mtkimmins/LTSDM_hack/scripts/cartridge-flasher/README.md

#TODO
- make LTSDM-specific wiring diagram for a resistor divider, upload, link
- count the jumper wires, insert #
- upload all pictures
- verify formatting on github
- continuity testing resistors will not beep
- redo all pictures

# Official Documentation of the LTSDM Cartridge Flasher
*The aim of this documentation is to explain this build so simply that a kid could build it like Legos. To report ambiguity, please submit a question to [the github](https://github.com/mtkimmins/LTSDM_hack/discussions/new?category=q-a).*

## Foreword
This is certainly not the only way to set up a communication channel with a cartridge ([see John-K's repo](https://github.com/John-K/LittleTikesDreamProjector)). For my own sanity, I will document a validated setup guide to at least get to where I am now, and as a way to "save" my progress more consistently.

---

## Resources Used
### Software
- Linux Ubuntu LTS (as operating system)
- Arduino IDE (for arduino upload)
- VSCode (for scripts)

### Hardware
- A multimeter with continuity testing ability
- Arduino Uno 3 (ch340-based clone; idVendor=1a86, idProduct=7523) (x1)
- Arduino-PC USB cable (x1)
- [8-Pin Card Edge Connector Socket](https://www.amazon.ca/PATIKIL-Connector-Straight-Connection-Circuit/dp/B0BPP6SVRD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) (Thanks to [John-K](https://github.com/John-K) for finding this part in the wild) (x1)
- Breadboard/Protoboard (x1)
- 24G wires
- 2k ohm resistors (x3)
- 3k ohm resistors (x3)
- intact LTSDM cartridge (x1)

---

## Circuitry Wiring
### P25D80SH PCB
It is important to note that the P25D80SH chip is the black integrated circuit (IC) that sits on the topside of the green PCB inside the cartridge housing. The cartridge uses the PCB's golden fingers to conduct electrical information from the embedded chip (IC) and the projector. The golden fingers on the PCB found in the LTSDM cartridges *is not* a direct mapping to the P25D80SH pins (see [datasheet](https://github.com/mtkimmins/LTSDM_hack/blob/main/Images/Chips/P25D80SH.pdf) vs explanation below).

#### **PINOUT** for P25D80SH *PCB*
> [!NOTE]
> For the description below, the PCB orientation is with (1) the golden fingers pointing toward you, (2) the black IC chip facing up, and (3) this position is held when describing both the top-face and bottom-face.
> The [PCB is in this orientation](https://github.com/mtkimmins/LTSDM_hack/blob/main/Images/CartridgeDissassembly/orientation_of_pcb.JPG) when the cartridge casing is (1) pointing the PCB golden fingers toward you, and (2) the book's cover label is face-down.The PCB golden fingers are DIFFERENT than the [pinout of the chip](https://github.com/mtkimmins/LTSDM_hack/blob/main/Images/Chips/P25D80SH.pdf). See [John-K's repository](https://github.com/John-K/LittleTikesDreamProjector) for further clarification.

**PCB Golden Finger Pinout**
||LEFT|||RIGHT|
|:-:|:-:|:-:|:-:|:-:|
|TOP-FACE|MISO|CS*|SLCK*|MOSI*|
|BOTTOM-FACE|WP/HOLD/VCC|WP/HOLD/VCC|GND|GND|

*\*must reduce the voltage from 5V to 3.3V*

Despite there being two sets of two bottom-facing fingers with WP/HOLD/VCC and GND, **both P25D80SH GND fingers must be connected to the arduino GND.

### Resistor Dividers
> [!CAUTION]
> Running 5V (PC USB voltage) through the P25D80SH will **fry the chip** making it potentially unusable.

Resistor dividers are essential (but not the only option, see *level shifters*) for the protection and proper operation (dump/flash) of the P25D80SH chip. The following P25D80SH pins need to be connected to the arduino through resistor dividers: **MOSI**, **SLCK**, and **CS**.

**Diagram of a Resistor Divider in the Context of the LTSDM Project**
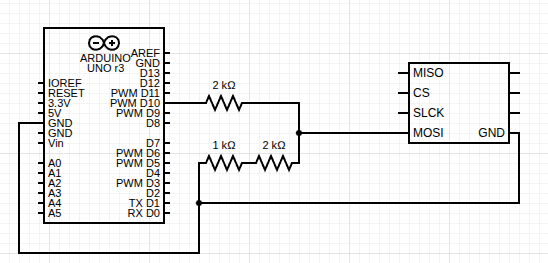
[picture p1: Images/WiringSetup/official-guide/1-resistor-divider-circuit-diagram.png]


Resistor dividers are partitioned into the "top resistor" and "bottom resistor." In the LTSDM project, we are reducing the voltage from the arduino pins (coming out at 5V; too high for the P25D80SH) to the operational ~3.3V.

Our top resistor (R1) = 2k ohms

Our bottom resistor (R2) = 3k ohms (direct chaining a 2k ohm resistor and a 1k ohm resistor together in series for the first breadboard prototype, then subbed them for a 3k resistor for the shield).

This resistor divider produces a current of about 3.0V, which is sufficient for the P25D80SH to operate.

### Arduino Pinout
For convention, one may use the following pins on the arduino:
- GND
- 3.3V
- PIN 10 through PIN 13 (this choice and assignment is largely arbitrary)
*the pinout is physically labeled on my arduino's PCB making the wiring much easier; Check your arduino's/microcontroller's datasheet if unsure of its pinout.*

> [!NOTE]
> Pins 10 through 13 output electricity at 5.0V, thus the need for resistor dividers despite there also being an actual *3.3V* pin. One cannot run all the P25D80SH pins through a single 3.3V arduino pin.

**Arduino-P25D0SH-Divider Mapping**
|P25D80SH pin|Arduino pin|Divider required?|
|:-:|:-:|:-:|
|CS|10|YES|
|SI|11|YES|
|SO|12|NO|
|SCLK|13|YES|
|GND|GND|NO|
|VCC/HOLD/WP|3.3V|NO|

---

## Hardware Setup Guide
**Full Circuit Diagram**
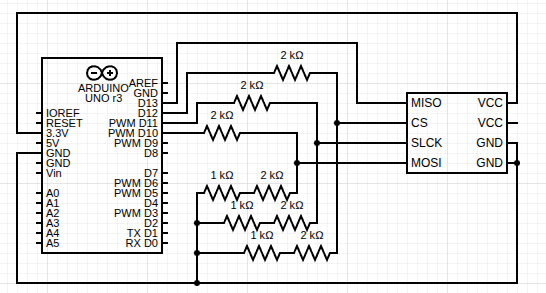
[picture p2: Images/WiringSetup/official-guide/full-circuit-diagram.png]


### Breadboard or Protoboard
Home circuity has been a messy endeavour, but using breadboards and then protoboards has connected the worlds of electronics and programming for me. Although I am quite awful with soldering, it has helped move this project along significantly even at my toddler-grade work. Consider soldering if connectivity is a bothersome issue. Alternatively, a solderless plastic breadboard is best to minimize health risk.

> [!WARNING]
> Have a responsible adult to supervise children operating soldering equipment. Soldering poses several health threats such as toxic fumes, physical contact with lead, and scalding-hot metal. Refer to a comprehensive soldering guide before attempting.

**Photo of One Plastic Breadboard (middle) and Two Protoboards**


### Adding the Cartridge Socket
**Photo of Socket and Header Pins**
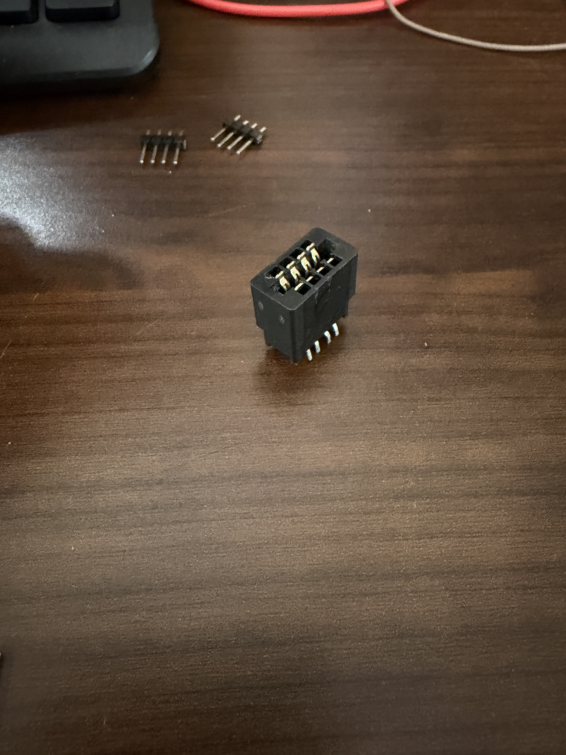
[picture p3: Images/WiringSetup/official-guide/socket-up.JPG]
Upright
  
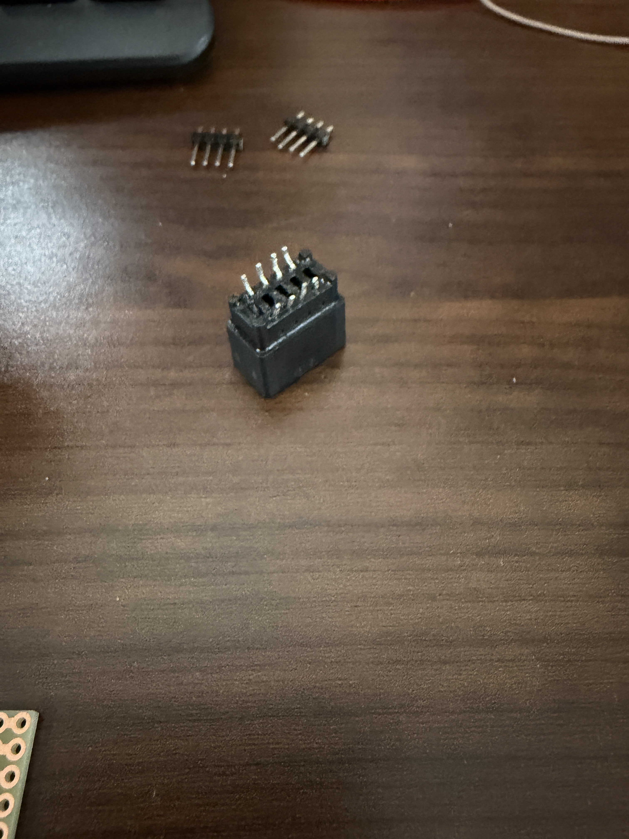
[picture p4: Images/WiringSetup/official-guide/socket-down.JPG]
Upside-down


Originally, I had thought that this part was a proprietary piece of electronics. For mine, I bought an entire other projector off Amazon, gutted it, and stole its socket. Months later, I read in John-K's documentation that one may buy these sockets off Amazon by the handful. Either approach works as evident by both our repositories. As noted by John-K, the width of this socket is not sufficient by default to interface with most breadboards and protoboards, thus the pins may be bent to accomodate the extra width required.

**Photo of 8-pin Socket in Breadboard**
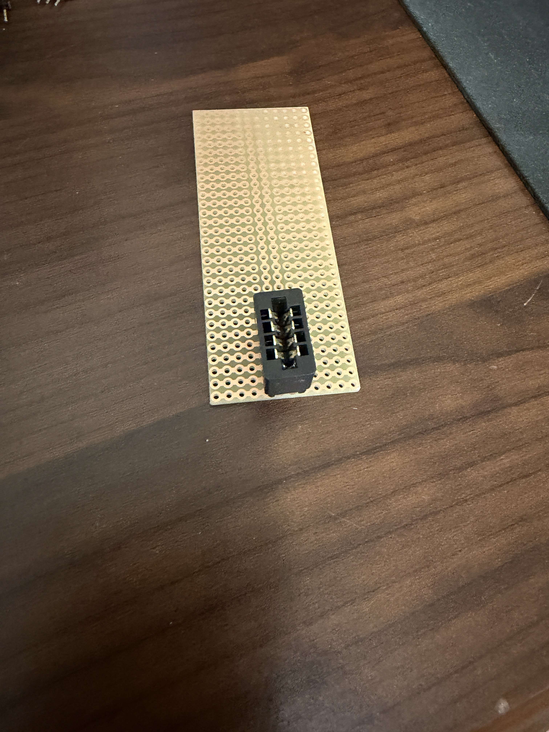
[picture p5: Images/WiringSetup/official-guide/placed-socket.JPG]


#### Checking Electrical Continuity
In order to ensure that the socket works and is securely connected to the breadboard/protoboard a multimeter should be used to perform a continuity test on each of the socket's pins. It is essential to test if the soldering joints are actually touching. This testing helps prevent later confounding between hardware malfunction and software debugging.

For breadboards one could use *header pins* to allow the multimeter leads to connect with the socket and the breadboard. Potentially, using two headers on either end of the breadboard's breakout rows can verify the validity of the *header pins* themselves. A disadvantage to plastic breadboards is the possibility of components shifting and slipping causing momentary or hidden circuit breaks.

For protoboards one could use the above-described "breadboard method," however, protoboards have the advantage over breadboards in that they can be soldered to hold components in place and increase the chance of a complete circuit connection. An additional advantage of a protoboard over a breadboard is that often the breakout rows are exposed versus on a conventional breadboard, thus allowing one to continuity test without *header pins*.

It is important to note that performing a continuity test through *resistors* will not trigger a signal. Resistors are meant to slow electricity, thus a continuity test will fail on a multimeter despite a circuit being physically complete. Using the Ohms setting on a multimeter can perform a continuity test through resistors if the meter reads the correct resistor value.

### Inserting the Cartridge, and Cartridge Orientation
One may notice that once the socket is placed on the board the LTSDM cartridge can be plugged in two conformations. Only 1 conformation will work -- they are not interchangeable as the P25D80SH pins will be flipped. This is where the builder must choose what orientation they would like their cartridge to fit into their socket. It is recommended to make a marking on the board and cartridge that align them properly.

**Photo of Cartridge in Socket**


### Resistor Dividers
As illustrated above, resistor dividers are used to reduce the voltage sent out of the arduino and into the P2D80SH chip. This protects the chip and allows it to function properly where it sends out signals classified in two states, "high" and "low."

**Photo of Resistor Dividers**


Ground (GND) will not need a divider as it receives any voltage of electricity sent through. Similarly, "master-in-slave-out" (MISO) will also conduct the output of the P25D80SH which will be within its tolerated 3.3V window by default. There also exists one 3.3V port on the arduino which can be used for the WP/HOLD/VCC. This leaves three P25D80SH pins: "master-out-slave-in (MOSI), "clock" (SCLK), and "chip select" (CS) to be reduced by resistor dividers. Three pins means three separate resistor dividers. One must connect each of those pins to a resistor divider *before* the arduino, thus positioning the resistor divider in the obligatory middle between the P25D80SH chip and the arduino.

To connect the P25D80SH chip pin to a resistor divider, one may use *jumper wires* to allow electricity to pass from the pin breakout row to the appropriate position in the resistor divider. The position of jumper wire connection *does* matter, so following the circuit diagram above as well as observing the reference photos may be of help.

The position of each resistor also matters which are designated as *top* and *bottom*. As the formula for a resistor divider is the following:
$$
V_{out}=(V_{in}*R_{bottom})/(R_{top}+R_{bottom})
$$
If $R_{top}$ > $R_{bottom}$, then the $V_{in}$ will be reduced more than 50%, and vice-versa.

**Photo of All Chip-Resistor Divider Connections**
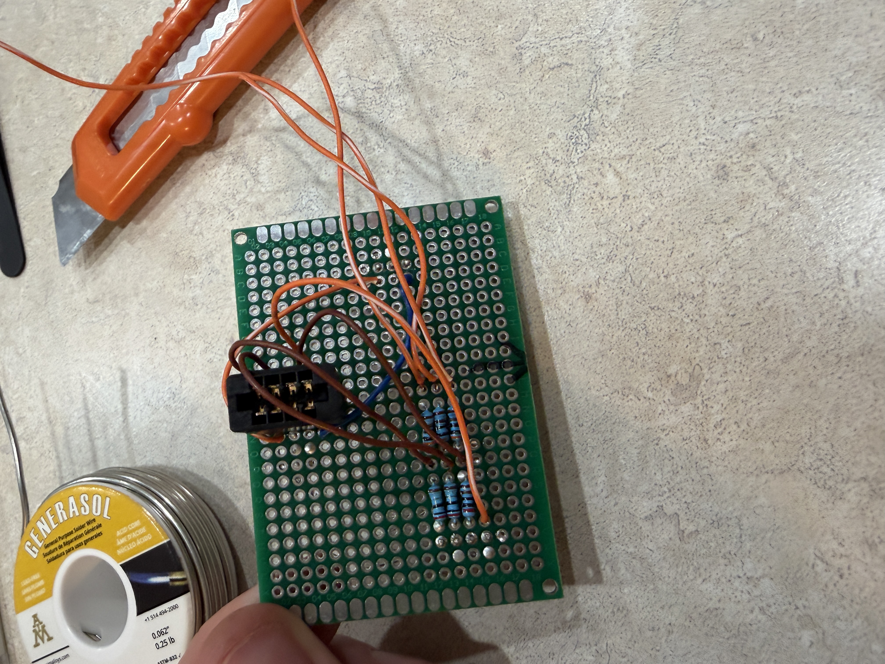
[picture p8: Images/shield/soldering/pre-solder-bridges-top.jpg]


### Complete Connection
**Photo of Physical Complete Connection Build**
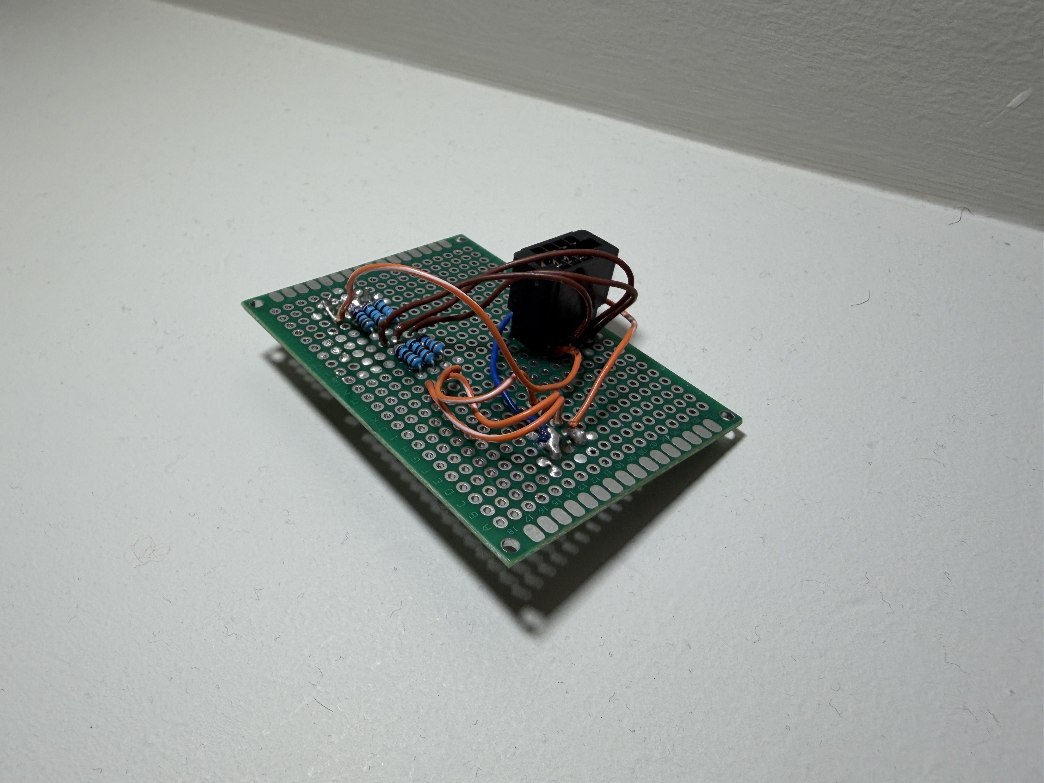
[picture p9: Images/shield/soldering/final3.jpg]


For a technical building overview, refer to the "Full Circuit Diagram" above.

### Arduino-PC Connection
In order to control the flow of electricity (and thus information) one must plug in the Arduino to a PC where one can compile and upload a script the arduino may execute to push and pull data from the cartridge. Plug in the microcontroller to the PC using the USB adapter that came with the microcontroller.

### Conclusion
Congratulations! The physical build is completed. The rest of the guide will reference the software used to interact with the P25D80SH chip.

**Photo of Overall Build**


---
## Flasher GUI
M0: Confirm SPI strategy (bitbang vs rewire) ──► M1
M1: PC↔Arduino serial handshake ──► M2
M2: Arduino low-level SPI primitives (CS assert, byte in/out) ──► M3
M3: JEDEC ID read (0x9F) — confirms chip talks & IDs correctly ──► M4, M6
M4: Bulk READ (0x03) — dump full 1MB to PC over serial ──► M5
M5: PC-app: save dump, verify length/checksum ──► M7
M6: Write-enable + status register polling (0x06, 0x05) ──► M6a
M6a: Erase primitives (0x20 sector / 0xD8 block / 0xC7 chip) ──► M6b
M6b: Page program (0x02) ──► M7
M7: Full round-trip test: dump → erase → flash → re-dump → diff ──► M8
M8: GUI polish (tkinter): progress bar, error states, retry logic

---
## Preparing the Custom Audio/Light Data Payload to Flash onto the P25D80SH chip
### Gathering Sources
### Converting Audio
### Defining Lights
### Compiling Payload
### Flashing Payload

---
## Milestones
TIER 2 — Link verification (your requirement #1 and #2)
 [3] Arduino ⟷ PC serial link verified   (PING/PONG handshake)
 [4] Arduino ⟷ chip electrical link verified (JEDEC ID read ≠ 0x00/0xFF)
      └─> [3] feeds: 5, 7, 9   |   [4] feeds: 5

TIER 3 — Read path
 [5] Single-block READ command working (addr, len) → hex payload over serial
      └─> feeds: 6

TIER 4 — Requirement #3: verified dump
 [6] Full-chip dump loop with double-read compare + retry/majority-vote on mismatch
      └─> feeds: 10

TIER 5 — Write path (each depends on the read path existing, for verify)
 [7] STATUS/WIP polling + WRITE ENABLE handling
 [8] ERASE (sector/chip) using [7]
 [9] PAGE PROGRAM (256B) using [7]
      └─> [8],[9] feed: 10 (need [5] too, for readback verify)

TIER 6 — Requirement #4: flash + verify
 [10] Erase→flash→read-back-verify orchestration for custom .bin

TIER 7 — Integration
 [11] GUI ties 3,4,6,10 into one workflow with logging + abort-safety
 [12] End-to-end test: dump stock cartridge → hash it → flash test pattern → dump again → diff
