mtkimmins/LTSDM_hack/docs/physical_specs.md

# Physical Specifications
This document will house the numerical values of dimensional measurements for the case, film, and PCB -- all components of the cartridge. All measurements were measured using a digital caliper with a **resolution** of 0.1mm/0.01" and an **accuracy** of $\pm$ 0.2mm/0.01".

## Case Components
### Carousel
* Diameter of big nubs = 2.2mm
* Diameter of small nubs = 1.9mm
* Height of all nubs (top of nub to back of disc) = 2.0mm
* Total diameter = 38.7mm
* Center gear diameter = 11.9mm
* Central hole in gear head depth = 1.4mm
* Film window width (ea) = 5.0mm
* Film window height (ea) = 6.0mm
* Inner central hole diameter = 3.2mm
* Center lip thickness = 0.9mm
* Carousel disc thickness (uniform) = 1.0mm
* Outer central hole diameter = 9.5mm
* Bottom of frame-bottom of frame diameter = 22.7mm
* Margin thickness between window outer top->edge = 1.4mm
* Depth of outer central hole = 2.3mm
* Depth of inner central hole = 3.0mm
* Depth of black window = 0.4mm
* Margin thickness between black window and bottom of film window = 0.6mm
* Height from back of disc (no nub) to top of gear teeth = 4.7mm
* Height from back of disc (no nub) to bottom groove of gear teeth = ~3.4mm
* Height of gear teeth (calculated) = 1.3mm
* Number of gear teeth = 12
* Number of film windows = 12
> [!Note]
> Carousel-film mounting becomes arbitrary in a modded cartridge due to its lack of interfacing with the projector making it functionally non-critical. As long as the film is fixed to the carousel in the right position, and turns with the carousel, the mounting method can be altered.
>
> An aspect of the official mounting method I would like to retain is the forced directionality the mounts impose on the film ensuring it is oriented and faced correctly. We also must ensure that the black window aligns with the first frame of the film too.
>
> Film windows are spaced evenly along the radius of the carousel.
>
> Gear teeth are centrally aligned with their nearest film window.
>
> The black marker that signals when to stop spinning the projector upon cartridge setup is directly opposite (180$^o$) from slide 1.
>
> The gear is on the rear surface of the carousel.
>
> The projected slide is the window to the center-left, at -90$^o$, or at 270$^o$ when looking at the backside (gear side).

### Front Case
* Pillar (PCB) diameter = 3.8mm
### Back Case

## Film Components
### Film Disc (Both Halves)
* Thickness (uniform across whole film) = 0.1mm
* Film diameter = 38mm
* Film slide width (average of 6) = 4.2mm
* Film slide height (average of 6) = 3.5mm
* Outer margin between outer slide edge and disc edge (average of 6) = 1.9mm
> [!Note]
> In official cartridges the film disc is cut in half and mounted separately onto the same carousel. It is unclear as the the purpose of the division, but it can be speculated that the mass production process favoured it.
>
> Film center hole edge borders on the outside of the carousel's central lip.
>
> Film background is all black except for the transparent arrows indicating rotation direction for each half.
>
> The film is projected upside down (vertically inverted) through the carousel window.
>
> Our custom film should have "FRONT" and "BACK" printed on it close to the centre of the whole disc. Alternatively, the print "THIS SIDE AWAY FROM CAROUSEL" may be ideal for layman orientation and repeatability.
> 
> When deciding how to print the custom film, a decision must be made whether it is best to print it so the ink is smushed against the carousel, or facing away from the carousel.
>
> Resolution of each slide is roughly 6:5.

## PCB Components
> [!Note]
> Dimensions are from the perspective of P25D80SH chip facing toward the viewer with the golden fingers pointed down.
* Top width = 14.5mm
* Top side height = 11.1mm
* Bottom width = 12.1mm
* Total PCB height = 19.9mm
* Rounded corners of Bottom = 7.0mm
* Small hole diameter = ~2.0mm
* Small hole-edge top margin = 2.2mm
* Small hole-edge left matgin = 1.6mm
* Large hole diameter = 4.0mm
* Large hole-edge top margin = 1.0mm
* Large hole-edge right margin = 1.8mm
> [!Note]
> All gold finger measurements can be assumed also from the socket's dimensions. However, these measurements are from direct caliper measurement.
* Edge connector pitch (center-to-center between neighbouring gold fingers; as per manufacturer ) = 2.54mm
* Gold finger width = 1.5mm
* Gold finger height = 7.4mm
* Gold finger margin between fingers = 0.4mm
* Gold finger-exge margin left = ~1.4mm
* Gold ginger-edge margin right = 1.6mm
* P25D80SH pin solder length = 2.5mm
* Copper well x from left edge to well center = 5.6mm
* Copper well y from too edge to well center = 1.5mm
* Copper well diameter = ~0.7mm
* PCB thickness (just board, no components) = 
1.4mm
* PCB thickness total (bottom to top surface of P25D80SH = 2.9mm
> [!Note]
> There is one capacitor adjacent to the P25D80SH chip on the PCB. Read value with multimeter with capacitance setting.
* Capacitor value = 20 uF
* Capacitor length = 2.2mm
* Capacitor width = 1.3mm
* Capacitor height = 0.7mm
