mtkimmins/LTSDM_hack/docs/a1800.md

# Turning Sound Data Back to Sound Using the A1800 Codec

## Illustrating the Problem
### The Task
Imagine you are an engineer at Little Tikes. You have an idea to make a movie projector for young children. The company says, "sure, but due to budget constraints, here are the parts you are allowed to work with: a P25D80SH SPI chip. This holds exactly 1 MiB of data, no more. You must take a book -- albeit abridged -- and fit the sound of someone reading it along with a light show and motor signals.
### The Challenge
this is how big an uncompressed audio file would be (too big)
### Possible Solutions
Cut uncompressed audio short
Compress it and release it with the main chip
### Data Compression
encoder decoder
audio compression uses a "codec"
### A1800 Codec
few examples of compression algorithms
### The Compressing Process
16:1 compression (illustrate)
### Anatomy of '.a18' file in LTSDM
header
payload
### Header
size
hz
### Payload
40-byte chunks
### Decompressing Process
Cartridge to sound
what a speaker needs
what we have (byte blocks)
### Byte Translation
necessity overlap between bytes
convert bytes -> bits = "bitstream"
### What are subbands?
### Loading the First Subband with a Gain
first 5 bytes = band 0 gain
chain of gains
### Huffman Coding Data Compression
differences
table hardcoded external
### Loading Gains for Remaining Subbands
chain of gains
### Bit Allocation
purpose
loudest frequencies get more attention
attention levels turn into specific procedures
types of representation 
why noise as opposed to silence
