mtkimmins/LTSDM_hack/docs/preliminary_data.md

The following is a culmination of data from physical examination and the analysis of recorded video (not posted) with video editing software (Microsoft Clipchamp).
___
# Big Shark, Little Shark
pcb label number (back): 11
#Frames = 12  
No figurine mount used  
|Audio Event|Timestamp Begun|Timestamp End|Duration (Seconds)|Description|
|:-:|:-:|:-:|:-:|:-:|
|Display first frame|0:00|

Number on back of cartridge: W34J071

# Big Shark, Little Shark, Baby Shark
PCB label number (back): 12
#Frames = 12  
No figurine mount used  
|Audio Event|Timestamp Begun |Timestamp End|Duration (Seconds)|Description|
|:-:|:-:|:-:|:-:|:-:|
|Display first frame|0:00|0:18|18||
|Vocal introduction|0:00|0:08|8|Announce title, narrator, authors|
|Vocal reading|0:08|0:18|10|Reading first frame|
|Light - blue|0:08|0:10|2|"big shark"|
|Light - cyan|0:10|0:12|2|"little shark"|
|Light - blue|0:12|0:13|1|"big shark"|
|Light - cyan|0:13|0:14|1|"little shark"|
|Light - yellow|0:14|0:18|4|"friends"|
|Light off, hide + change frame|0:18|0:21|3|
|Display second frame|0:21|0:25|4|
|Light - pink|0:21|0:23|2|"play"|
|Vocal reading|0:21|0:25|4|Reading second frame|
|Light - yellow|0:23|0:25|2|"fun"|
|Light off, hide + change frame|0:25|0:28|3|
|Display third frame|0:28|0:39|11|
|Light - Blue|0:28|0:30|2|"uh oh"|
|Vocal reading|0:29|0:39|1|Reading third frame|
|Light - pink|0:30|0:33|3|"baby shark"|
|Light - blue|0:33|0:34|1|"Big Shark"|
|Light - cyan|0:34|0:35|1|"Little shark"|
|Light - red|0:35|0:38|3|Sharks mad at baby shark approach|
|Light - pink|0:38|0:39|1|"baby shark"|
|Light off, hide + change frame|0:39|0:42|3|
|Display fourth frame|0:42|0:54|12|
|Light - pink|0:42|0:45|3|"baby shark"|
|Vocal reading|0:43|0:54|11|Reading fourth frame|
|Light - green|0:45|0:46|1|"too little"|
|Light - pink|0:46|0:48|2|"Baby shark"|
|Light - yellow|0:48|0:49|1|"too slow"|
|Light - red|0:49|0:54|5|disgust for baby shark|
|Light off, hide + change frame|0:54|0:57|3|
|Display fifth frame|0:57|1:07|10|
|Light - blue|0:57|0:59|2|"big shark"|
|Vocal reading|0:57|1:05|8|Reading fifth frame|
|Light - cyan|0:59|1:00|1|"Little shark"|
|Light - pink|1:00|1:05|5|"Swim away, sad"|
|Light - blue + baby crying sfx|1:05|1:07|2|blue light for duration of baby crying sfx|
|Light off, hide + change frame|1:07|1:10|3|
|Display sixth frame|1:10|1:19|9|
|Light - pink|1:10|1:11|1|"baby shark"|
|Vocal reading|1:11|1:18|7|Reading sixth frame|
|Light - cyan|1:11|1:14|3|Baby swim to parents|
|Light - red|1:14|1:18|4|Parents mad at other two sharks|
|Light - pink/blue/red/pink/red + gong|1:18|1:19|1|Gong sfx + light flashes quickly in order before shutting off|
|Light off, hide + change frame|1:19|1:22|3|
|Display seventh frame|1:22|1:29|7|
|Light - cyan|1:22|1:25|3|Tell grandpa shark|
|Vocal reading|1:22|1:27|5|Reading seventh frame|
|Light - red|1:25|1:27|2|"what [the other sharks] did"|
|Light - pink/blue/pink/red + gong sfx|1:28|1:28|0|gong paired with light flash in order, lingers on red|
|Light off, hide + change frame|1:29|1:31|2|
|Display eighth frame|1:31|1:39|8|
|Light - cyan|1:32|1:34|2|"grandpa shark"|
|Vocal reading|1:32|1:38|6|Reading eighth frame|
|Light - blue|1:34|1:36|2|"grandma shark"|
|Light - red|1:36|1:38|2|"what [the other sharks] did"|
|Light - yellow/red + gong|1:38|1:39|1|gong paired with a flash of yellow, then red|
|Light off, hide + change frame|1:39|1:43|4|
|Display ninth frame|1:42|1:48|6|
|Light - red|1:43|1:46|3|"family mad"|
|Vocal reading|1:43|1:48|5|Reading ninth frame|
|Light - purple|1:46|1:48|2|"sharks do?"|
|Light off, hide + change frame|1:48|1:50|2|
|Display tenth frame|1:50|2:05|15|
|Light - purple|1:51|1:53|2|"5 sharks"|
|Vocal reading|1:51|1:58|7|Reading tenth frame pt1|
|Light - blue|1:53|1:55|2|"Deep breaths"|
|Light - white|1:55|1:57|2|"Play"|
|Light - yellow|1:57|1:58|1|"own game"|
|Light - blue/yellow/blue/yellow + baseball organ sfx|1:58|2:00|2|light flashes blue, then yellow, then blue, then yellow along with baseball organ "Play ball!" sfx|
|Light stays yellow|2:00|2:02|2|continue from previous yellow light, "now"|
|Vocal reading|2:00|2:05|5|continuation of reading tenth frame|
|Light - blue|2:02|2:03|1|"big shark"|
|Light - cyan|2:03|2:05|2|"little shark"|
|Light off, hide + change frame|2:05|2:08|3|
|Display eleventh frame|2:08|2:17|9|
|Light - cyan|2:08|2:10|2|"say"|
|Vocal reading|2:08|2:16|8|Reading eleventh frame|
|Light - yellow|2:10|2:13|3|big shark and little shark apology|
|Light - purple/pink|2:13|2:14|1|"baby shark"|
|Light - yellow|2:14|2:16|2|baby asks other two to play|
|Light off, hide + change frame|2:16|2:19|3|
|Display twelfth frame|2:19|2:26|7|
|Light - blue|2:20|2:21|1|"all play"|
|Vocal reading|2:20|2:24|4|Reading twelfth frame|
|Light - cyan|2:21|2:23|2|"baseball"|
|Light - blue|2:23|2:24|1|"together"|
|Light - white/blue + baseball bat sfx|2:24|2:26|2|baseball bat hitting a ball sfx + changed to white for a while, then flashed blue before off|
|Light off, hide + change frame|2:26|2:29|3|
|Finished sound|2:29|

Number on backof cartridge: W34F171

# Big Shark, Little Shark Go to School
PCB label number (back): 13
#Frames = 12  
No figurine mount used  
|Audio Event|Timestamp Begun|Timestamp End|Duration (Seconds)|Description|
|:-:|:-:|:-:|:-:|:-:|
|Display first frame|0:00|

Number on back of cartridge: W34F171
