mtkimmins/LTSDM_hack/data/devlog/images/CartridgeDissassembly/internals_11.JPG

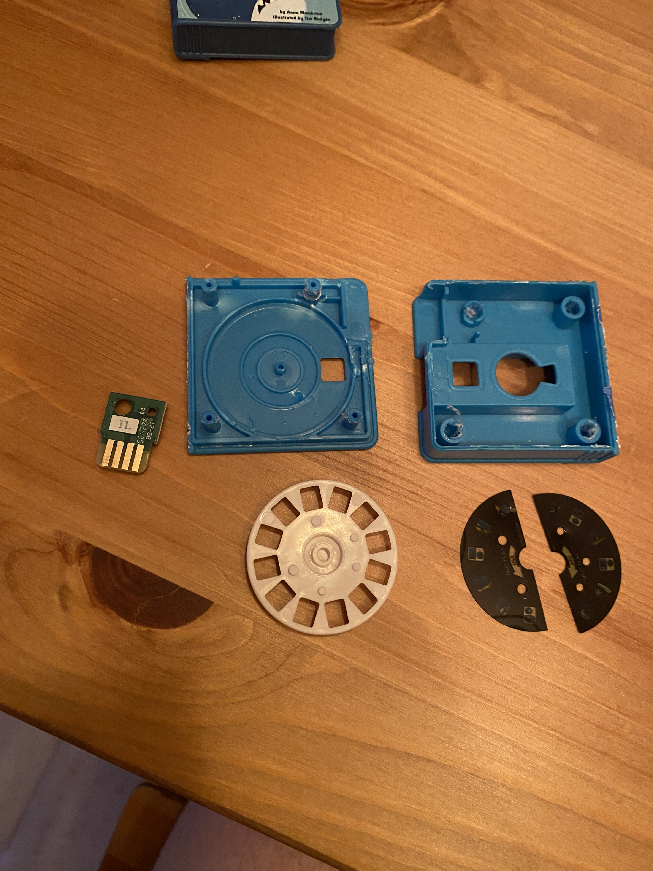
data/devlog/images/CartridgeDissassembly/internals_11.JPG
