mtkimmins/LTSDM_hack/data/devlog/images/CartridgeDissassembly/internals_12.JPG

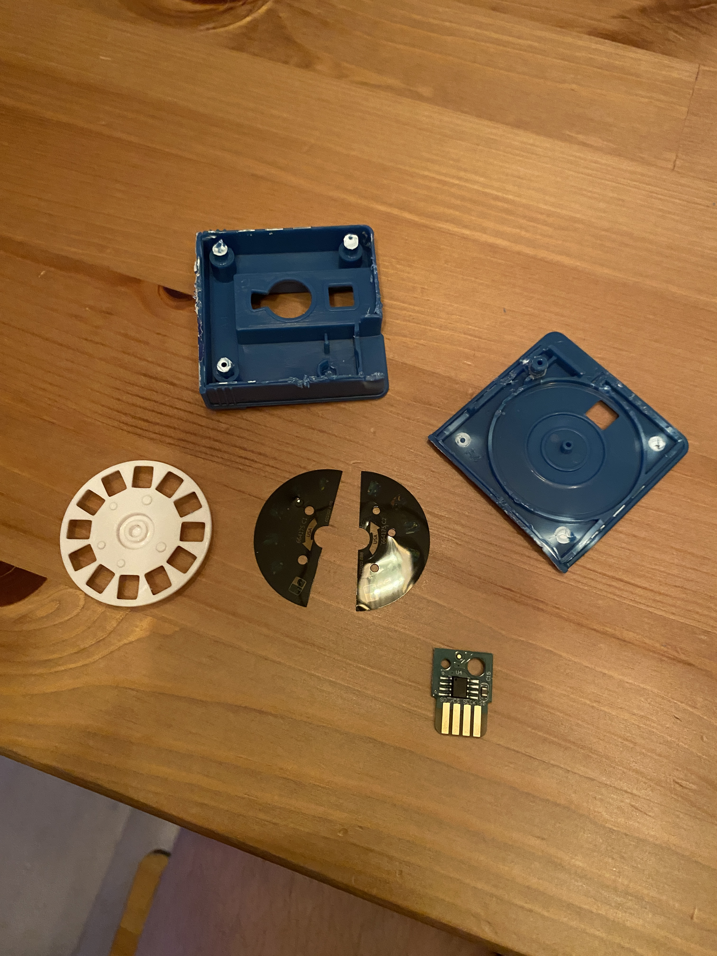
data/devlog/images/CartridgeDissassembly/internals_12.JPG
