mtkimmins/LTSDM_hack/data/devlog/images/CartridgeDissassembly/orientation_of_pcb.JPG

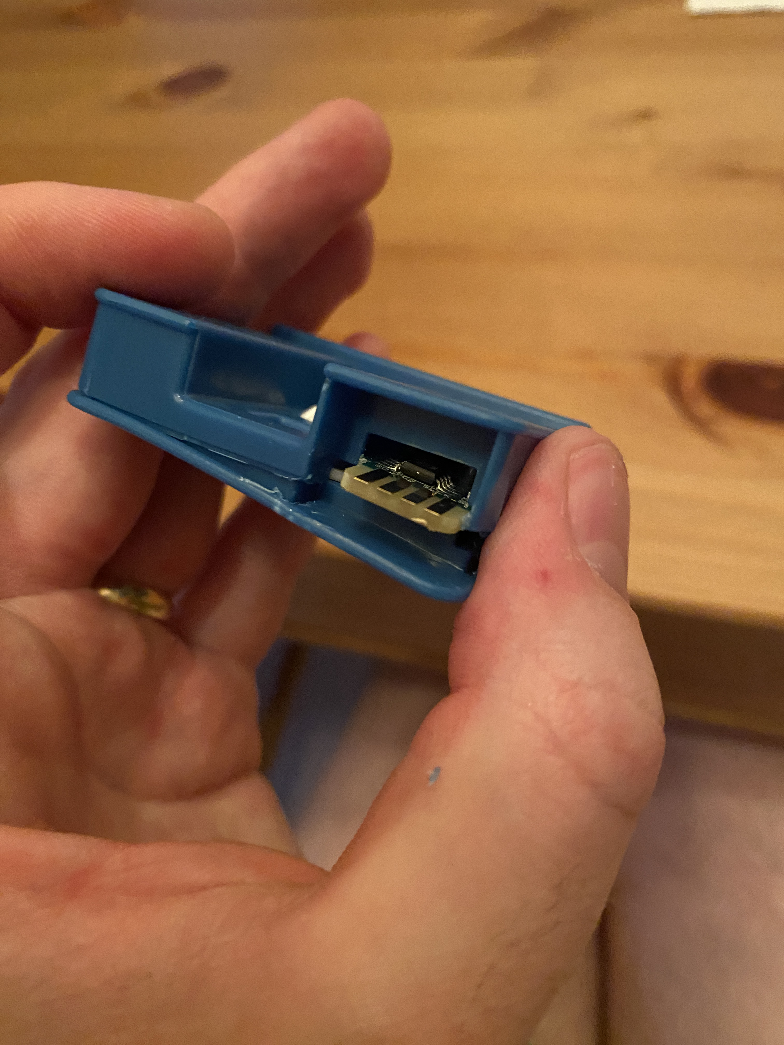
data/devlog/images/CartridgeDissassembly/orientation_of_pcb.JPG
