mtkimmins/LTSDM_hack/data/devlog/images/Projector_disassembly/audio jack board2.JPG

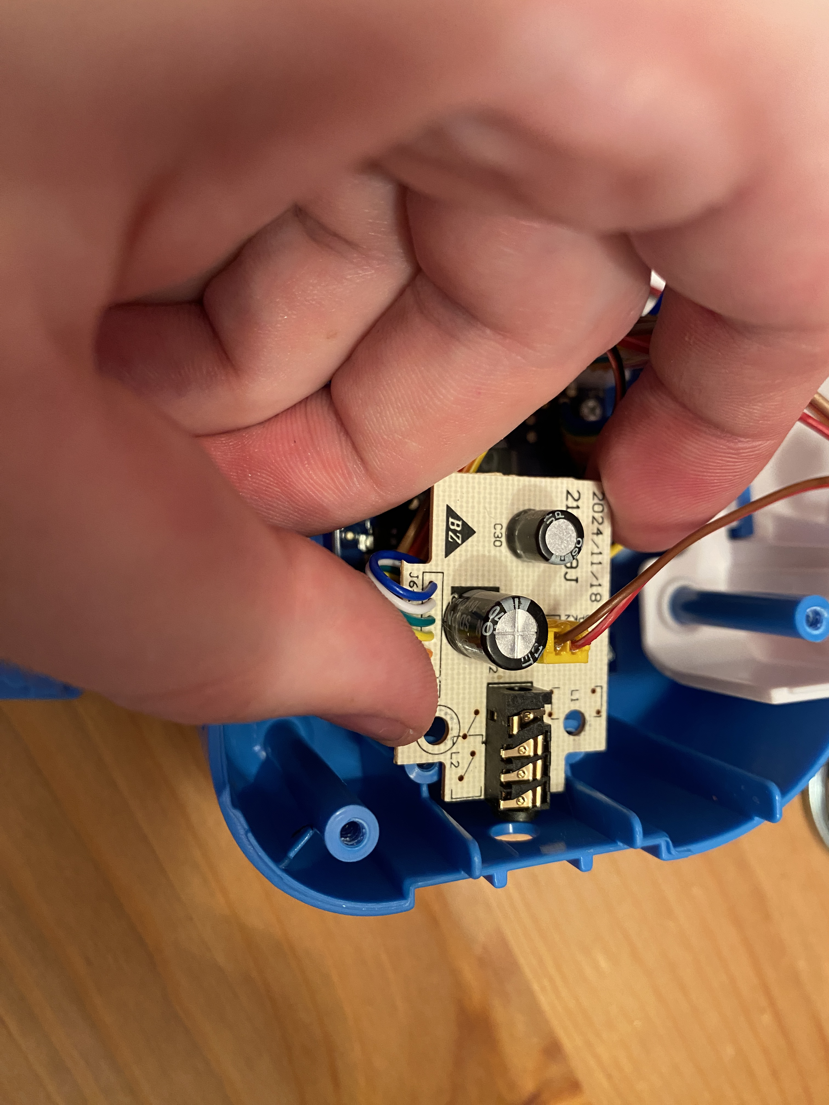
data/devlog/images/Projector_disassembly/audio jack board2.JPG
