mtkimmins/LTSDM_hack/data/devlog/images/Projector_disassembly/audio jack board.JPG

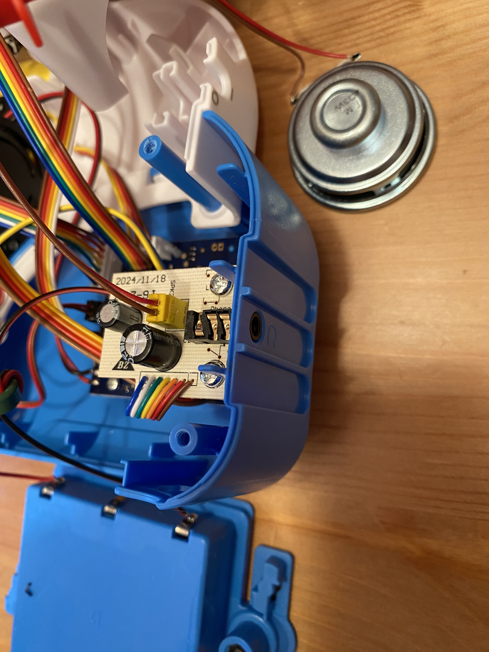
data/devlog/images/Projector_disassembly/audio jack board.JPG
