mtkimmins/LTSDM_hack/data/devlog/images/Projector_disassembly/audio jack converter.JPG

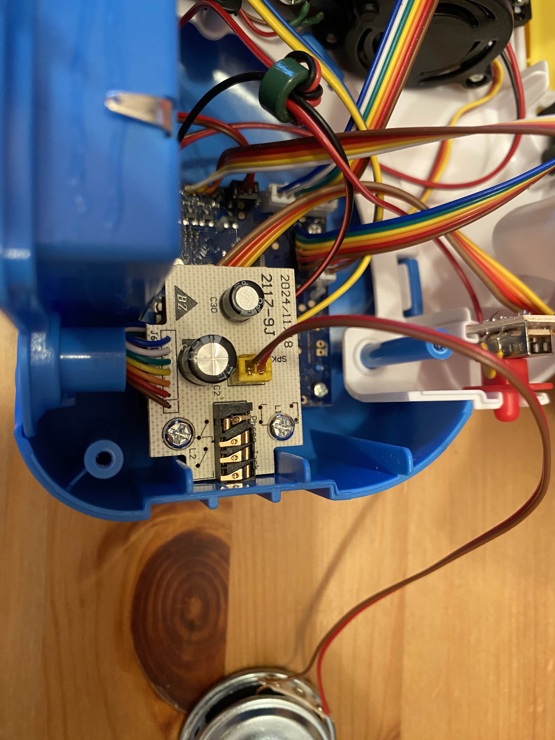
data/devlog/images/Projector_disassembly/audio jack converter.JPG
