mtkimmins/LTSDM_hack/data/devlog/images/Projector_disassembly/cartridge adapter side of main board.JPG

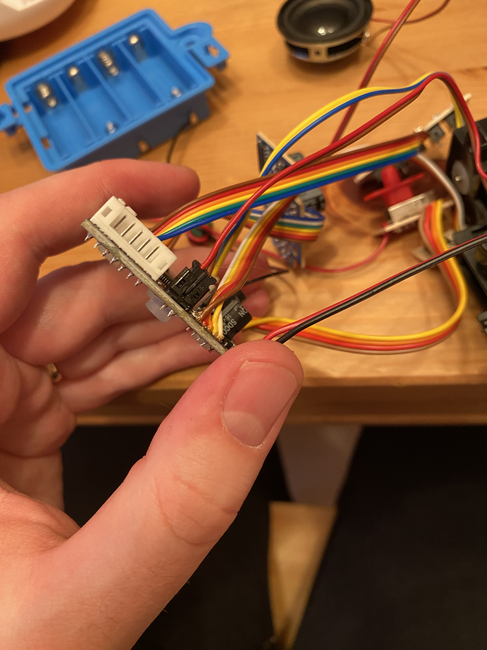
data/devlog/images/Projector_disassembly/cartridge adapter side of main board.JPG
