mtkimmins/LTSDM_hack/data/devlog/images/Projector_disassembly/cartridge edge adapter.JPG

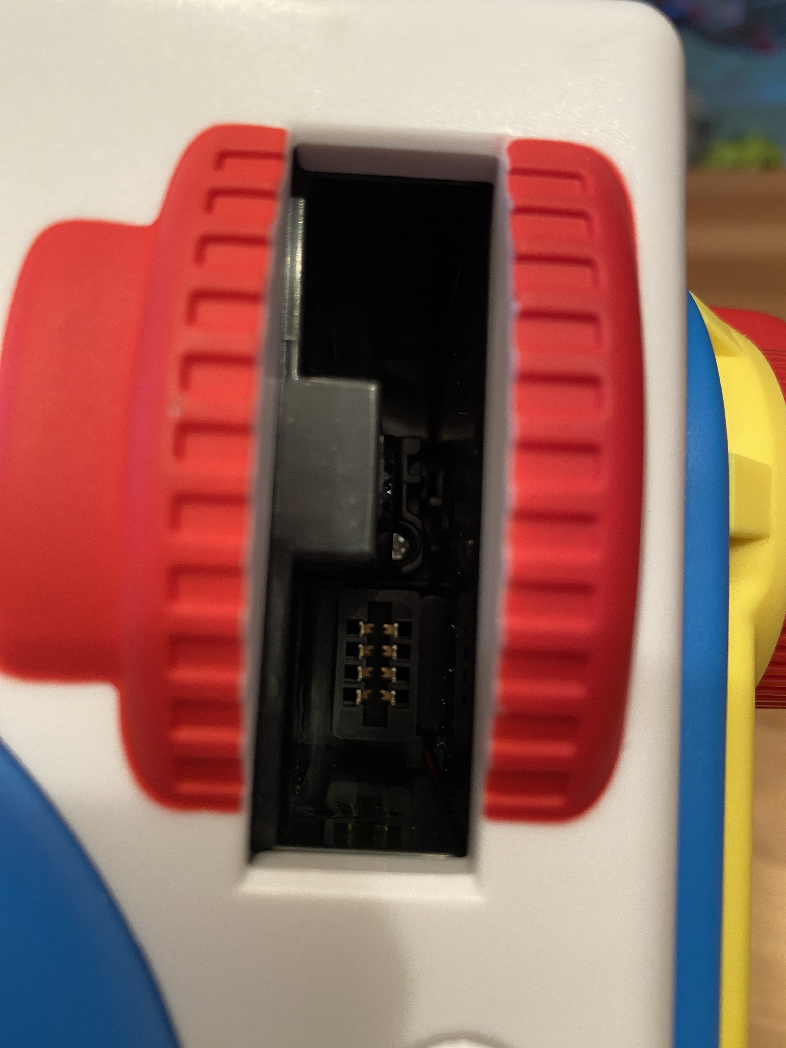
data/devlog/images/Projector_disassembly/cartridge edge adapter.JPG
