mtkimmins/LTSDM_hack/data/devlog/images/Projector_disassembly/cartridge wiring1.JPG

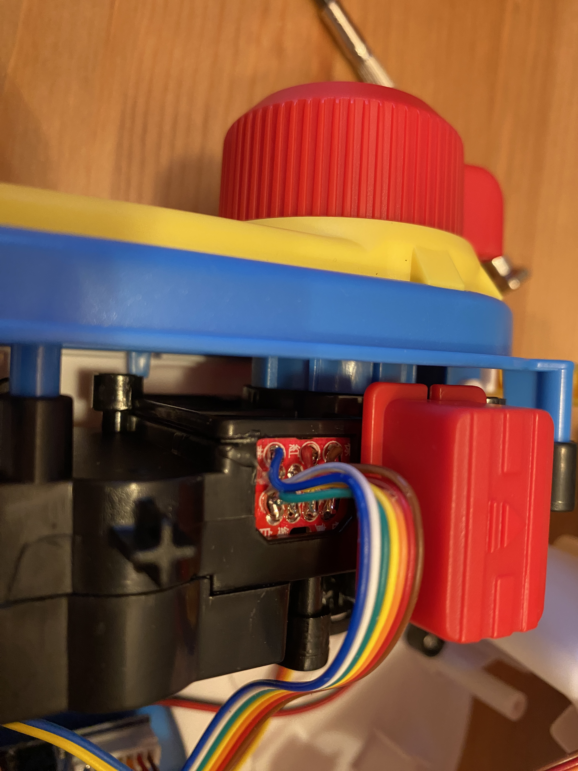
data/devlog/images/Projector_disassembly/cartridge wiring1.JPG
