mtkimmins/LTSDM_hack/data/devlog/images/Projector_disassembly/cartridge wiring.JPG

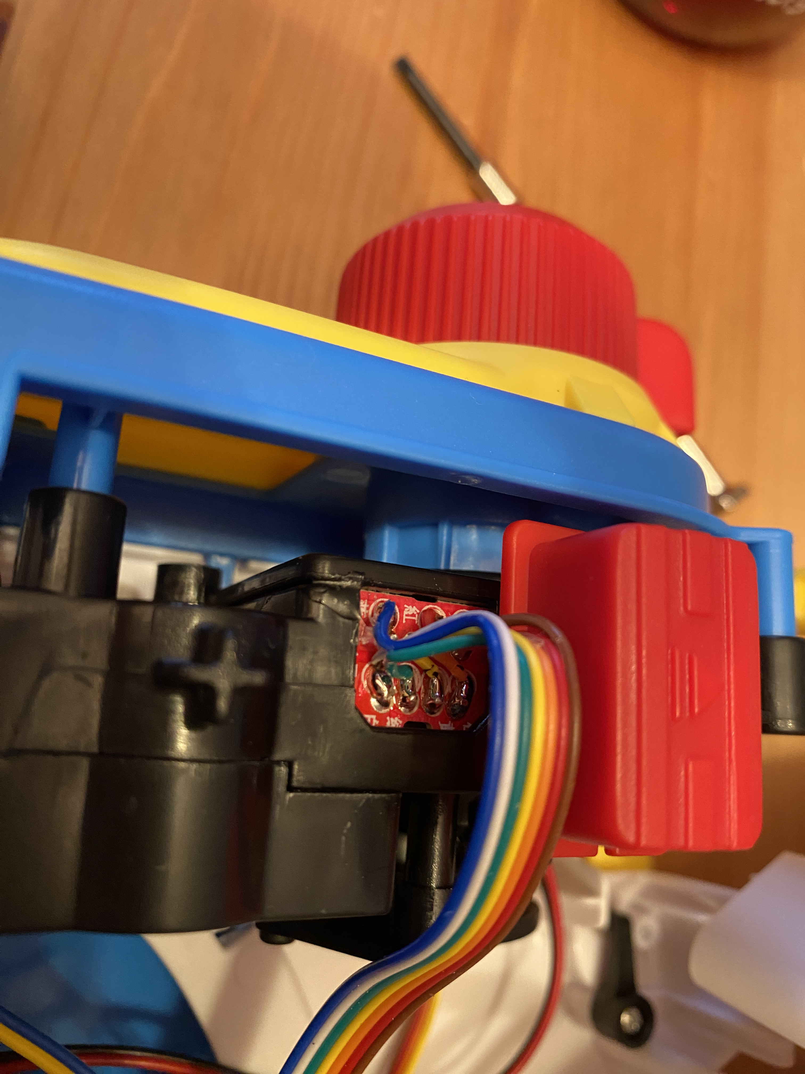
data/devlog/images/Projector_disassembly/cartridge wiring.JPG
