mtkimmins/LTSDM_hack/data/devlog/images/Projector_disassembly/figurine slot wiring1.JPG

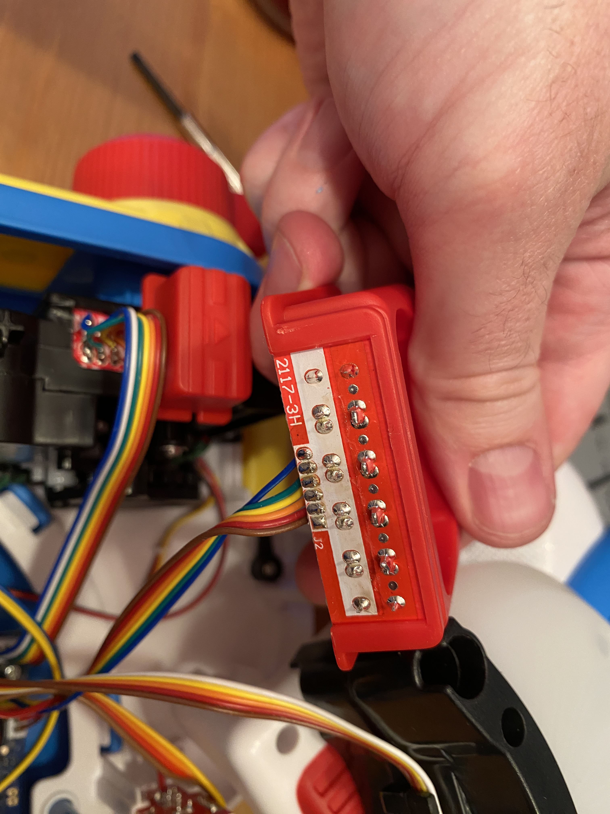
data/devlog/images/Projector_disassembly/figurine slot wiring1.JPG
