mtkimmins/LTSDM_hack/data/devlog/images/Projector_disassembly/figurine slot wiring3.JPG

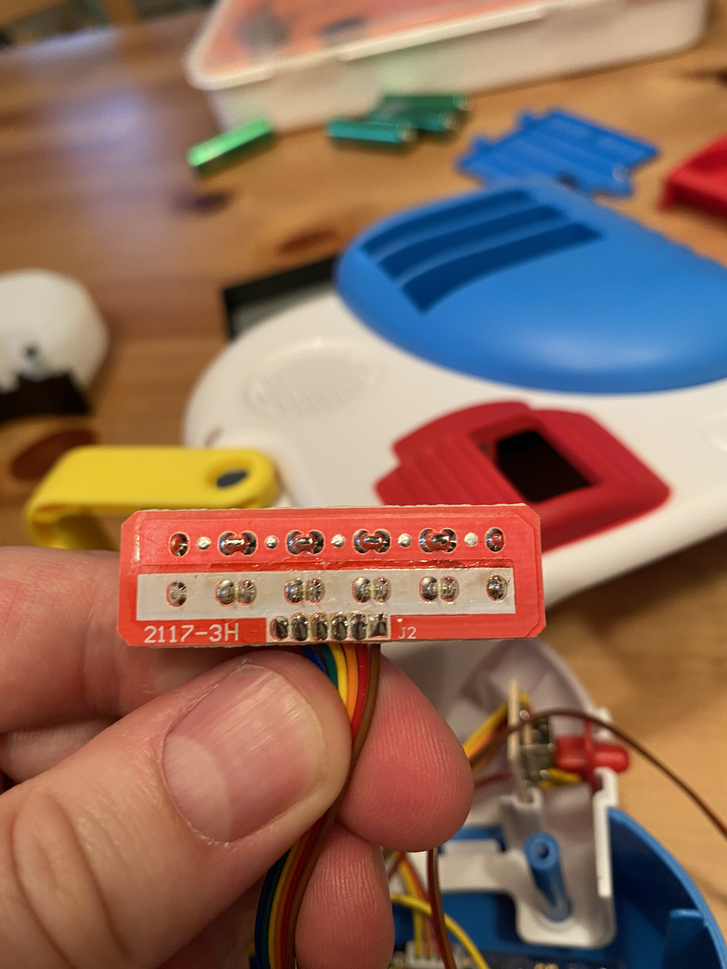
data/devlog/images/Projector_disassembly/figurine slot wiring3.JPG
