mtkimmins/LTSDM_hack/data/devlog/images/Projector_disassembly/figurine slot wiring.JPG

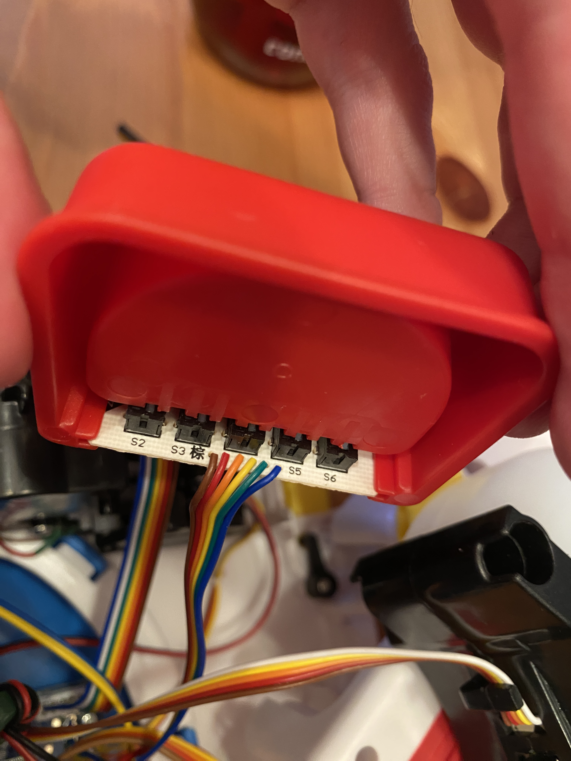
data/devlog/images/Projector_disassembly/figurine slot wiring.JPG
