mtkimmins/LTSDM_hack/data/devlog/images/Projector_disassembly/figurine slot.JPG

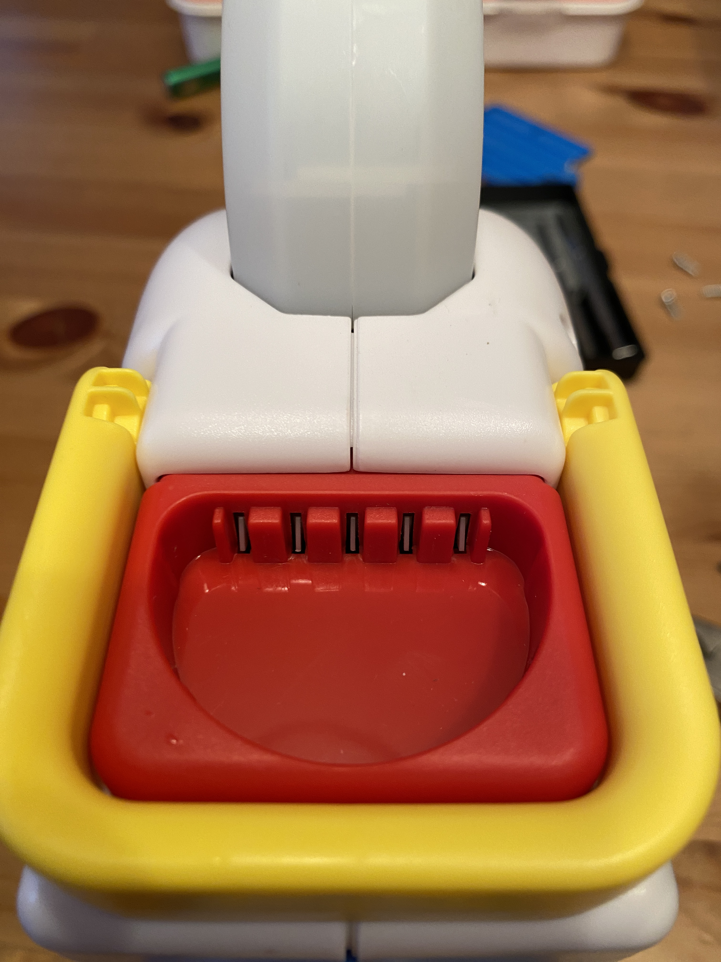
data/devlog/images/Projector_disassembly/figurine slot.JPG
