mtkimmins/LTSDM_hack/data/devlog/images/Projector_disassembly/glued_adapter1.JPG

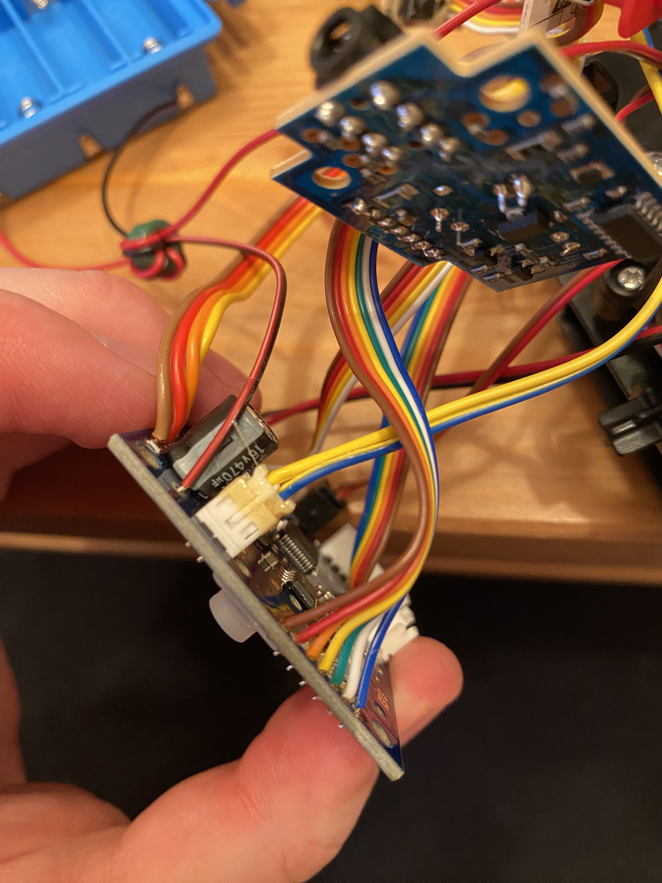
data/devlog/images/Projector_disassembly/glued_adapter1.JPG
