mtkimmins/LTSDM_hack/data/devlog/images/Projector_disassembly/IO switch.JPG

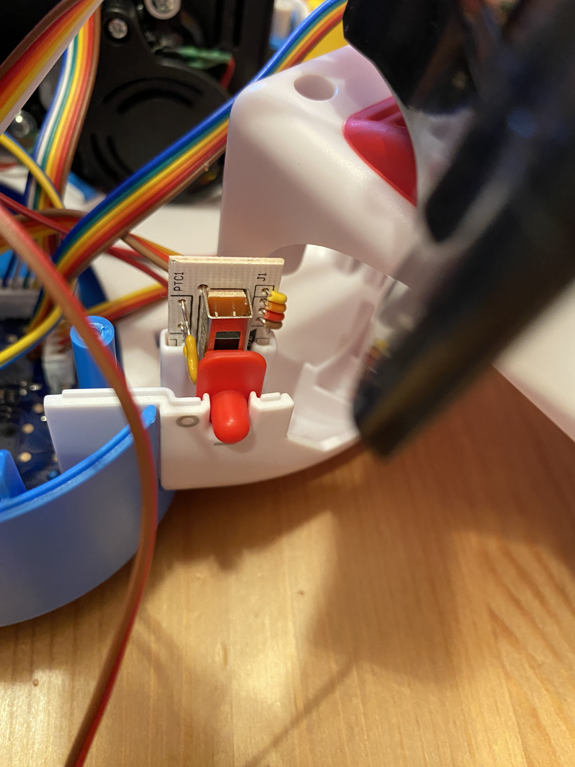
data/devlog/images/Projector_disassembly/IO switch.JPG
