mtkimmins/LTSDM_hack/data/devlog/images/Projector_disassembly/IO wiring1.JPG

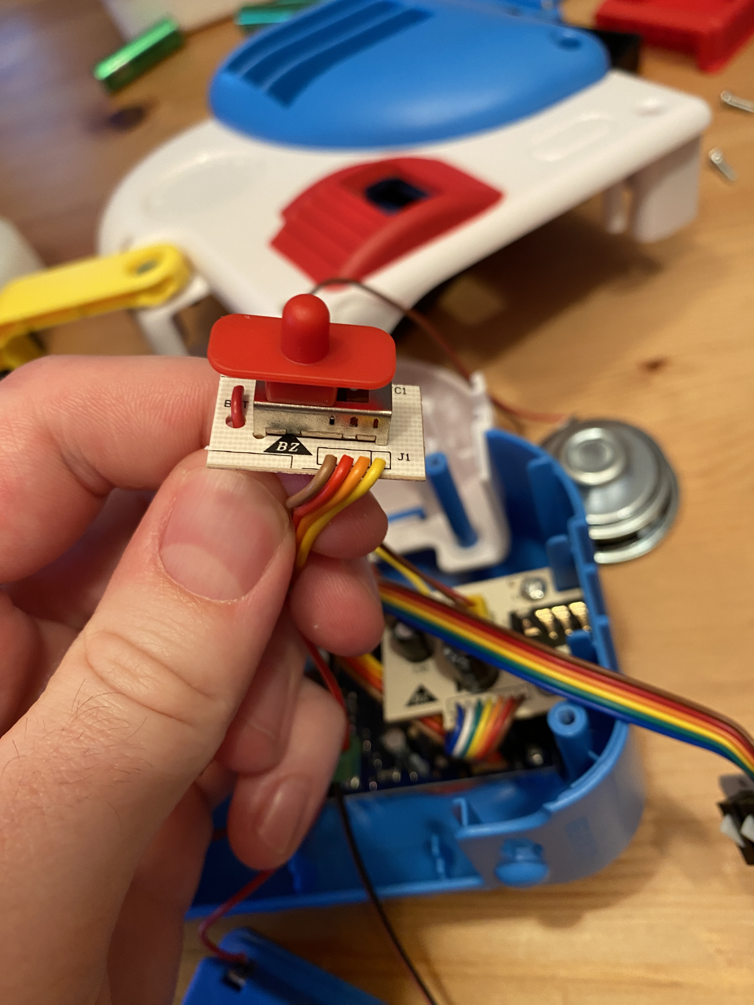
data/devlog/images/Projector_disassembly/IO wiring1.JPG
