mtkimmins/LTSDM_hack/data/devlog/images/Projector_disassembly/IO wiring back.JPG

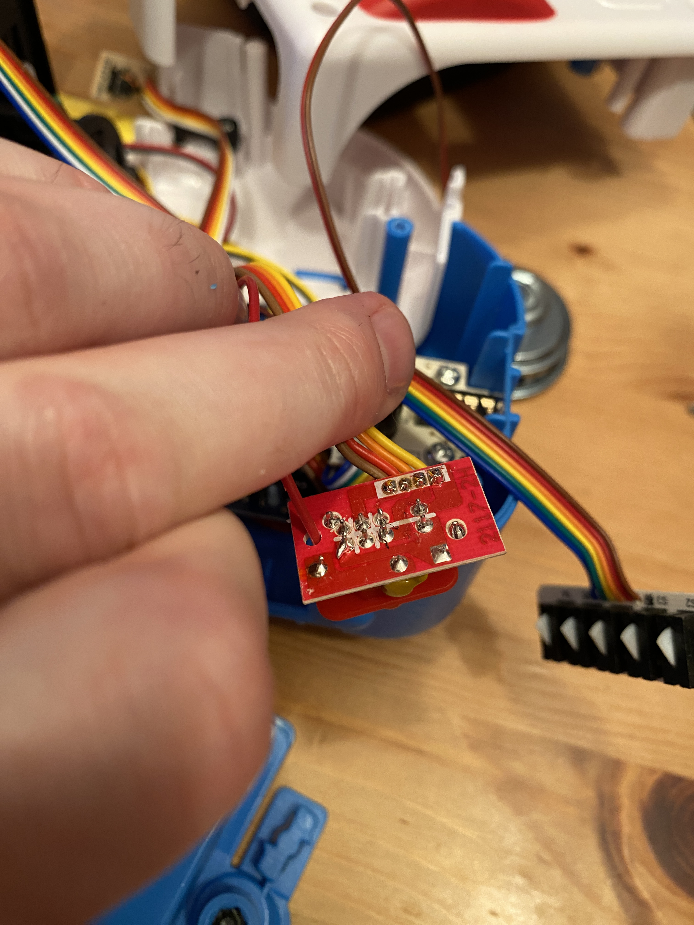
data/devlog/images/Projector_disassembly/IO wiring back.JPG
