mtkimmins/LTSDM_hack/data/devlog/images/Projector_disassembly/IO wiring.JPG

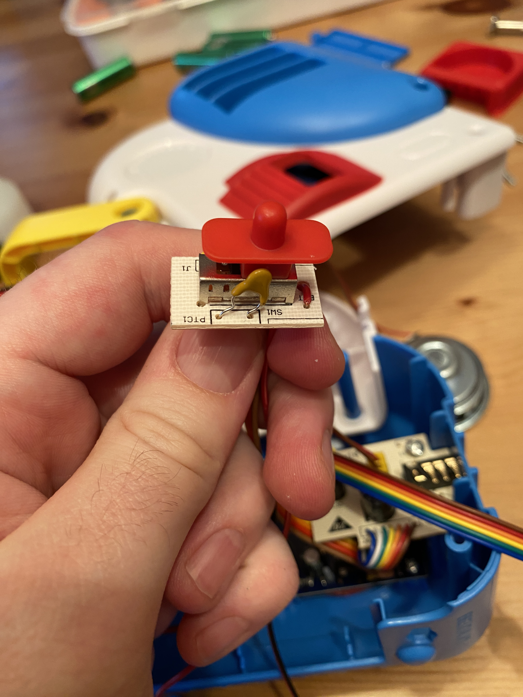
data/devlog/images/Projector_disassembly/IO wiring.JPG
