mtkimmins/LTSDM_hack/data/devlog/images/Projector_disassembly/led wiring bottom1.JPG

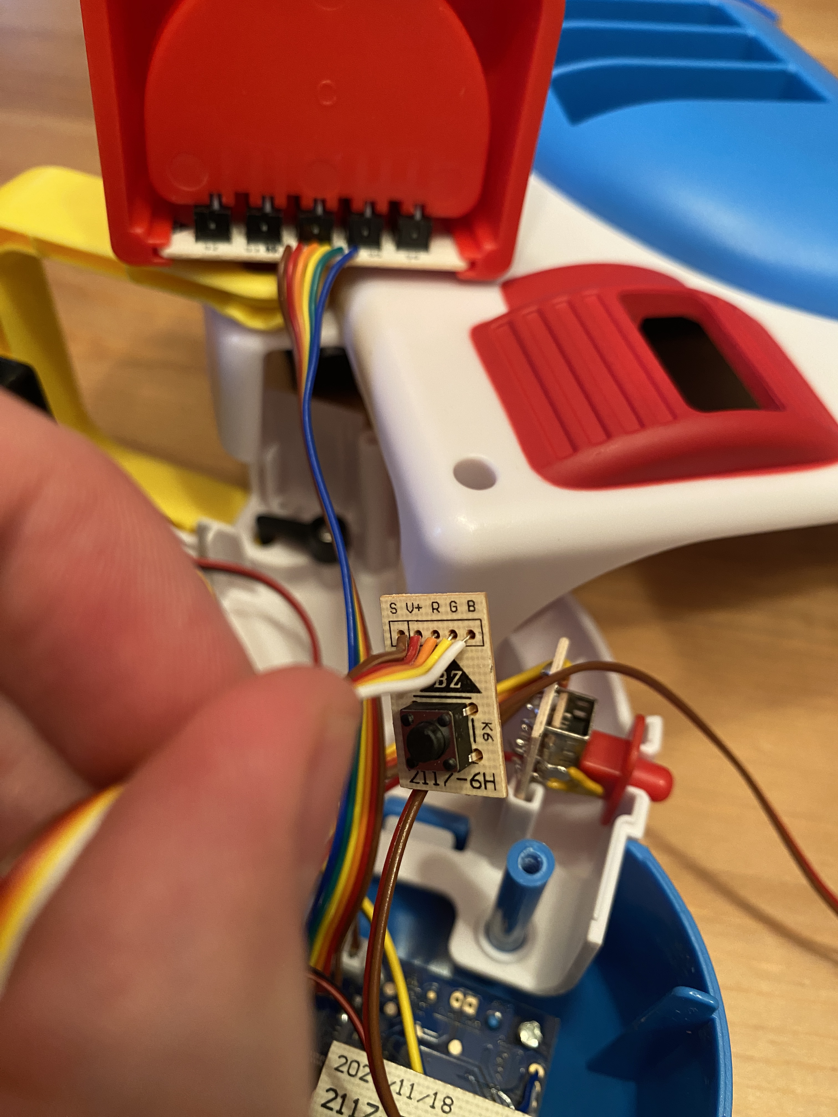
data/devlog/images/Projector_disassembly/led wiring bottom1.JPG
