mtkimmins/LTSDM_hack/data/devlog/images/Projector_disassembly/led wiring bottom.JPG

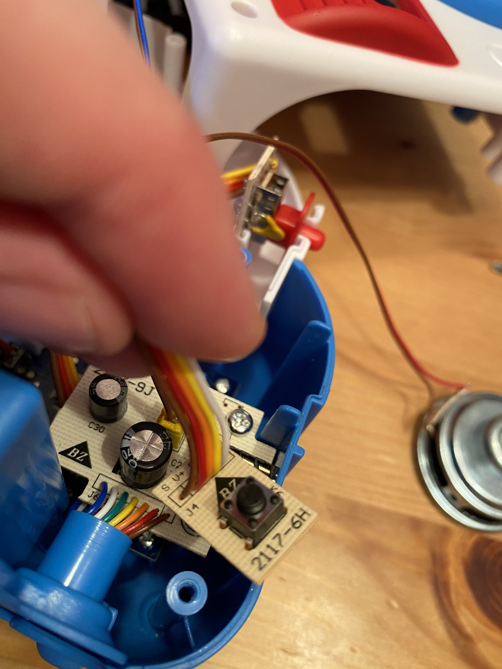
data/devlog/images/Projector_disassembly/led wiring bottom.JPG
