mtkimmins/LTSDM_hack/data/devlog/images/Projector_disassembly/led wiring.JPG

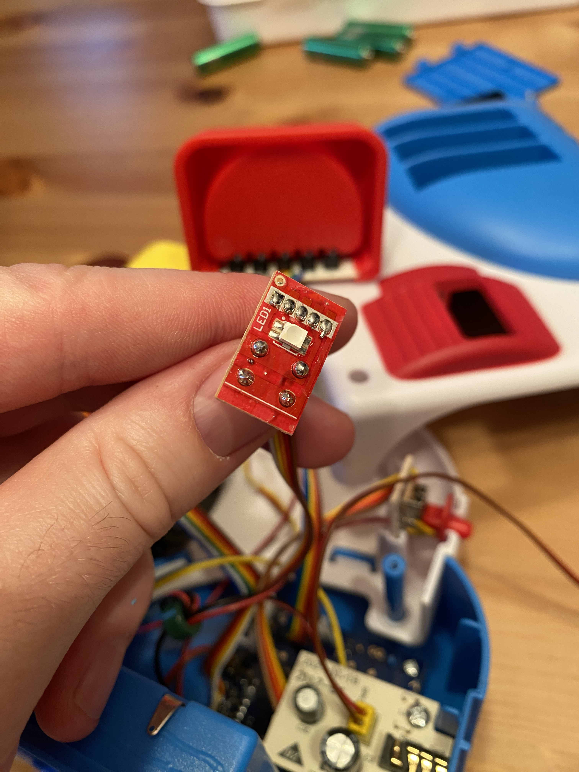
data/devlog/images/Projector_disassembly/led wiring.JPG
