mtkimmins/LTSDM_hack/data/devlog/images/Projector_disassembly/light inside wiring.JPG

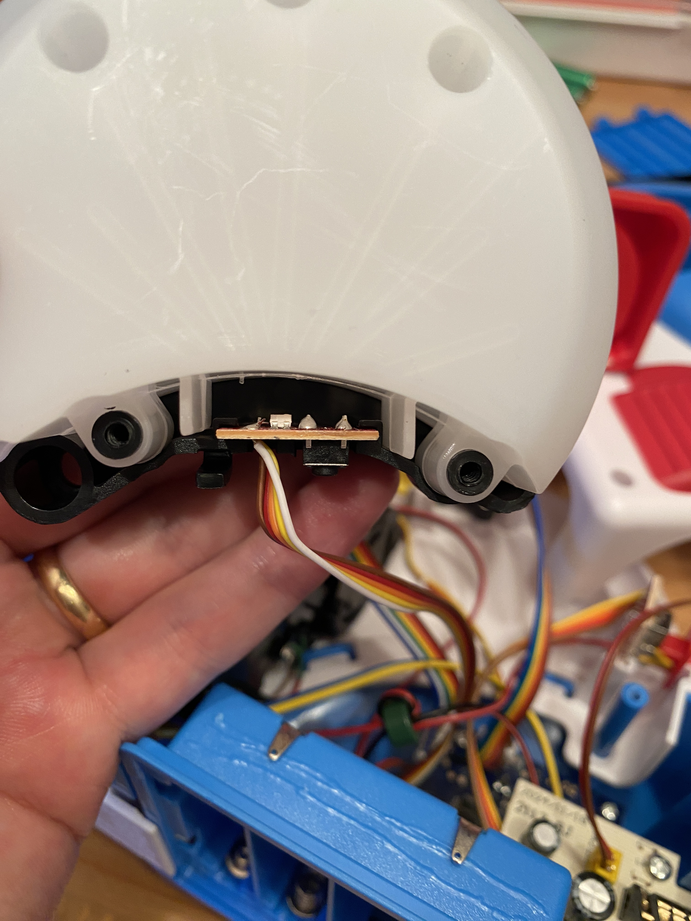
data/devlog/images/Projector_disassembly/light inside wiring.JPG
