mtkimmins/LTSDM_hack/data/devlog/images/Projector_disassembly/light wiring.JPG

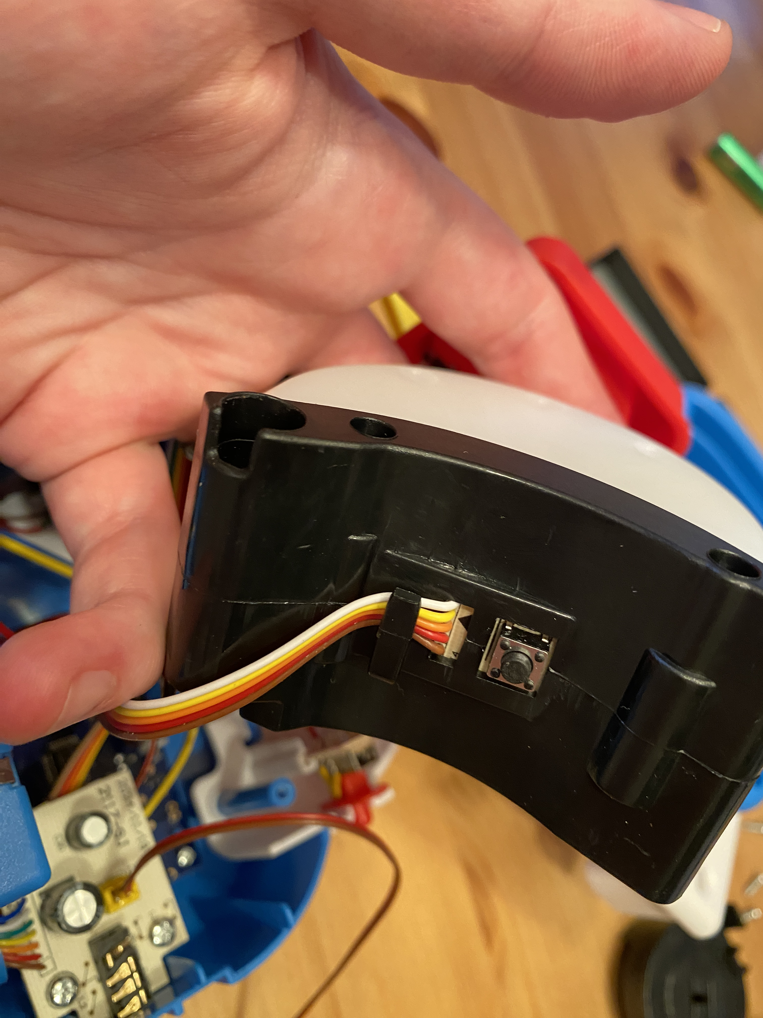
data/devlog/images/Projector_disassembly/light wiring.JPG
