mtkimmins/LTSDM_hack/data/devlog/images/Projector_disassembly/main_board_back.JPG

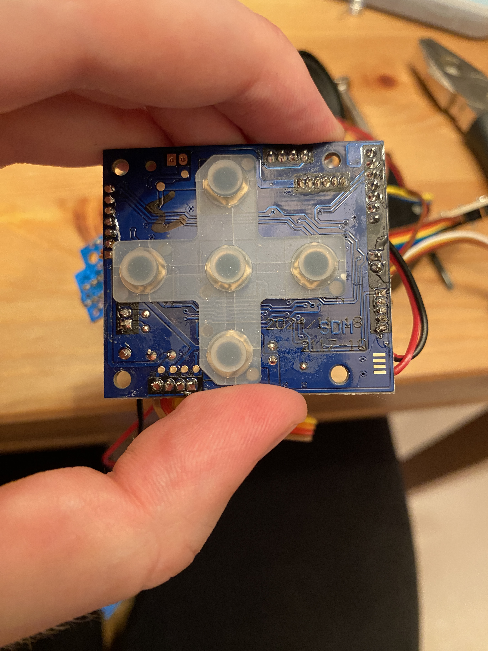
data/devlog/images/Projector_disassembly/main_board_back.JPG
