mtkimmins/LTSDM_hack/data/devlog/images/Projector_disassembly/main_board_front1.JPG

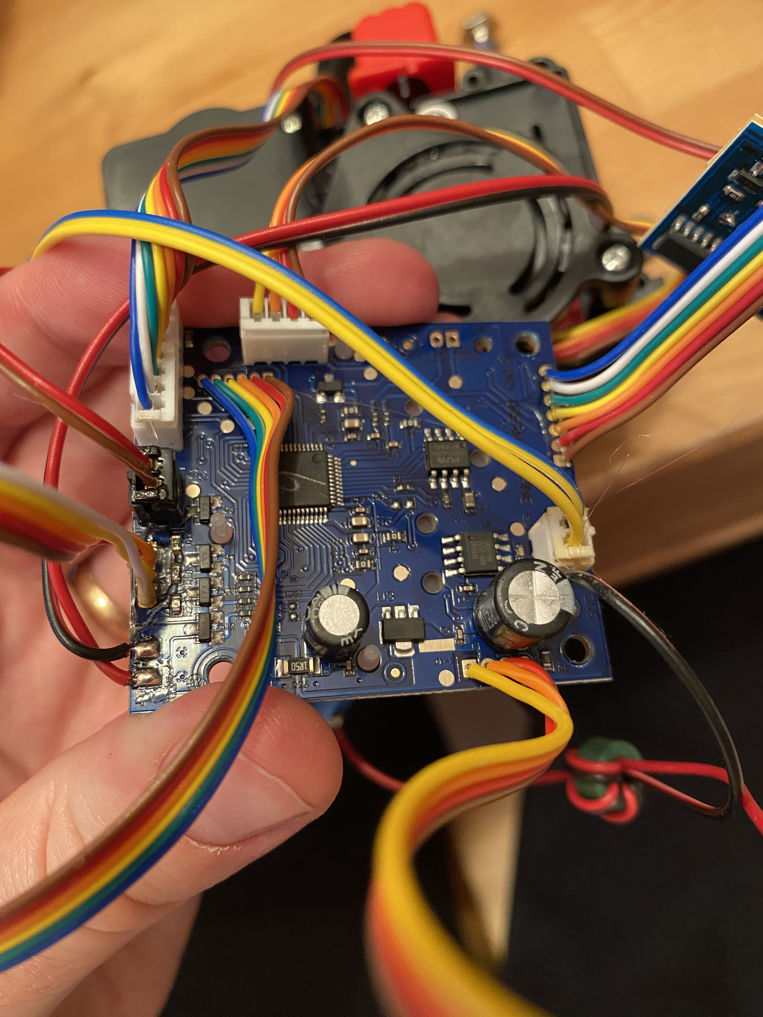
data/devlog/images/Projector_disassembly/main_board_front1.JPG
