mtkimmins/LTSDM_hack/data/devlog/images/Projector_disassembly/orientation of cartridge reader adapter.JPG

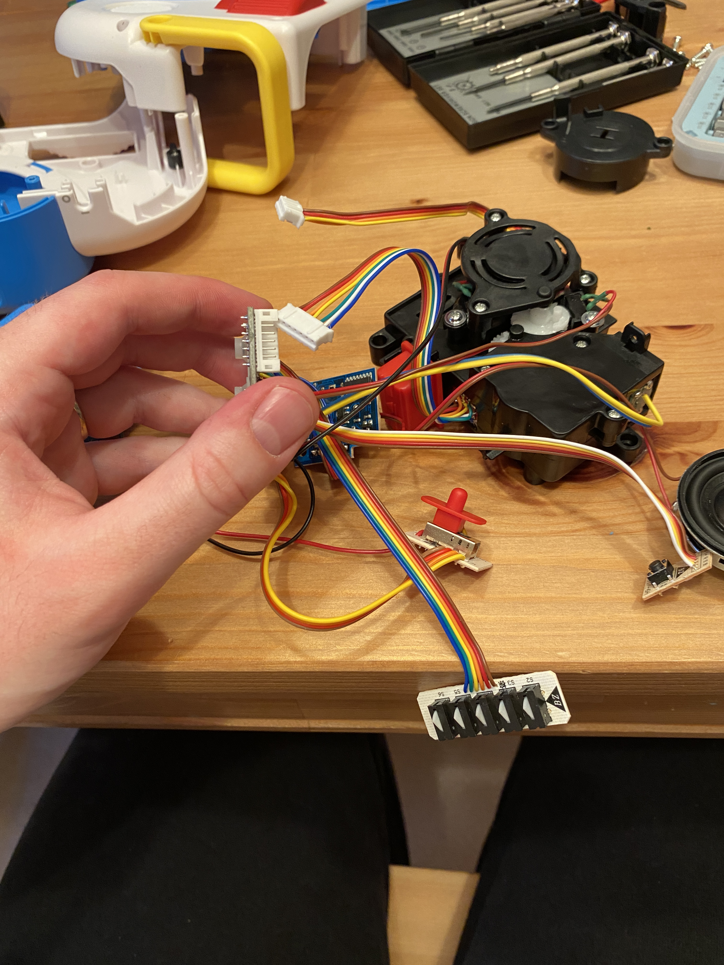
data/devlog/images/Projector_disassembly/orientation of cartridge reader adapter.JPG
