mtkimmins/LTSDM_hack/data/devlog/images/Projector_disassembly/orientation of motor adapter.JPG

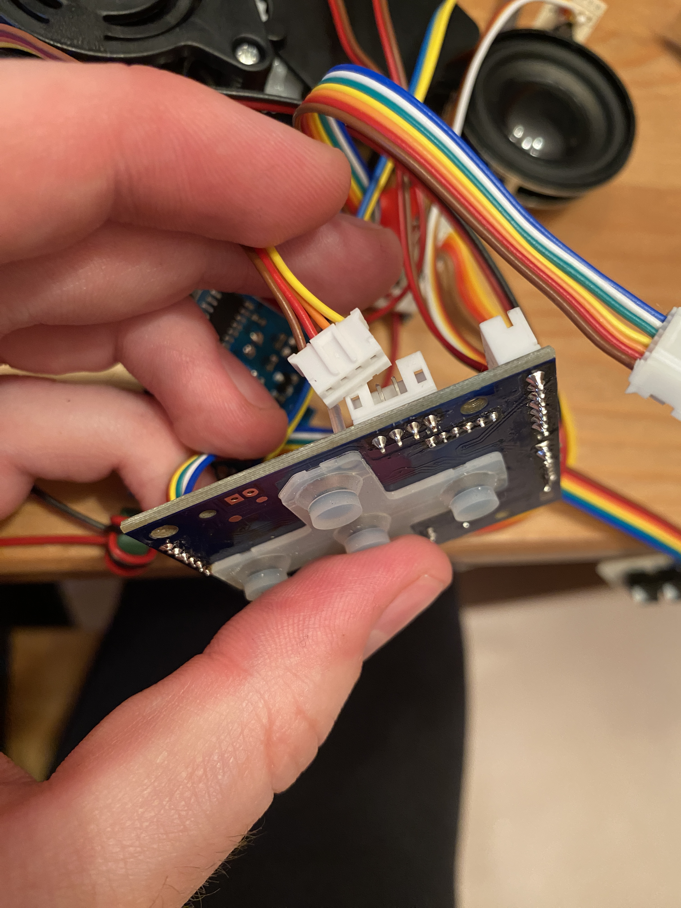
data/devlog/images/Projector_disassembly/orientation of motor adapter.JPG
