mtkimmins/LTSDM_hack/data/devlog/images/Projector_disassembly/screw1.JPG

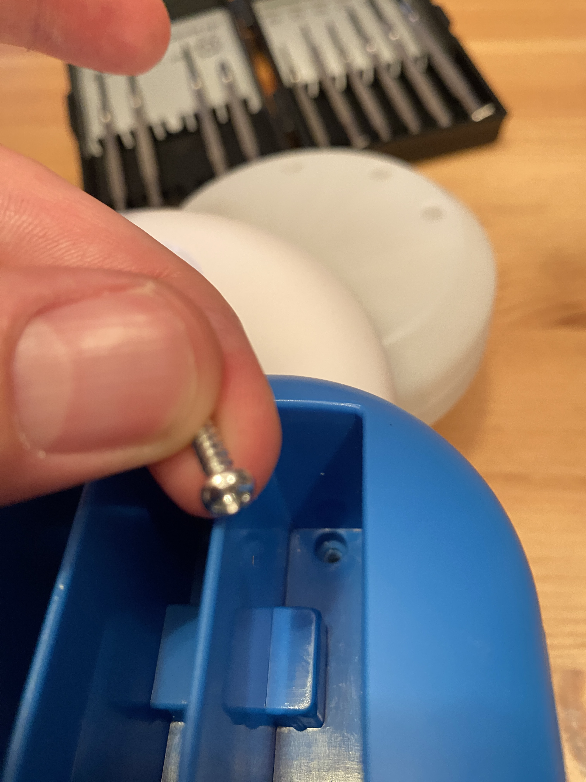
data/devlog/images/Projector_disassembly/screw1.JPG
