mtkimmins/LTSDM_hack/data/devlog/images/Projector_disassembly/screw2.JPG

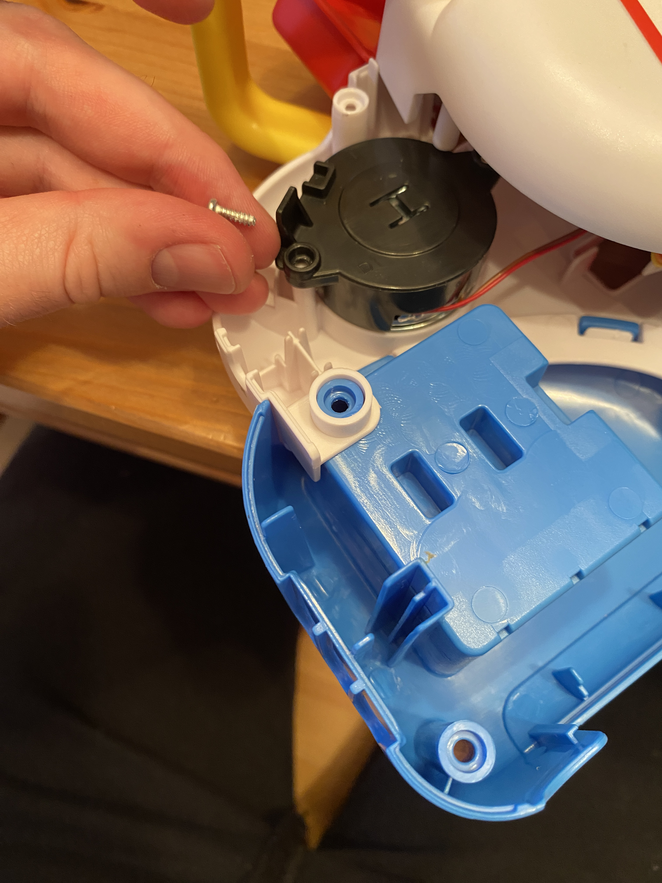
data/devlog/images/Projector_disassembly/screw2.JPG
