mtkimmins/LTSDM_hack/data/devlog/images/Projector_disassembly/screw3.JPG

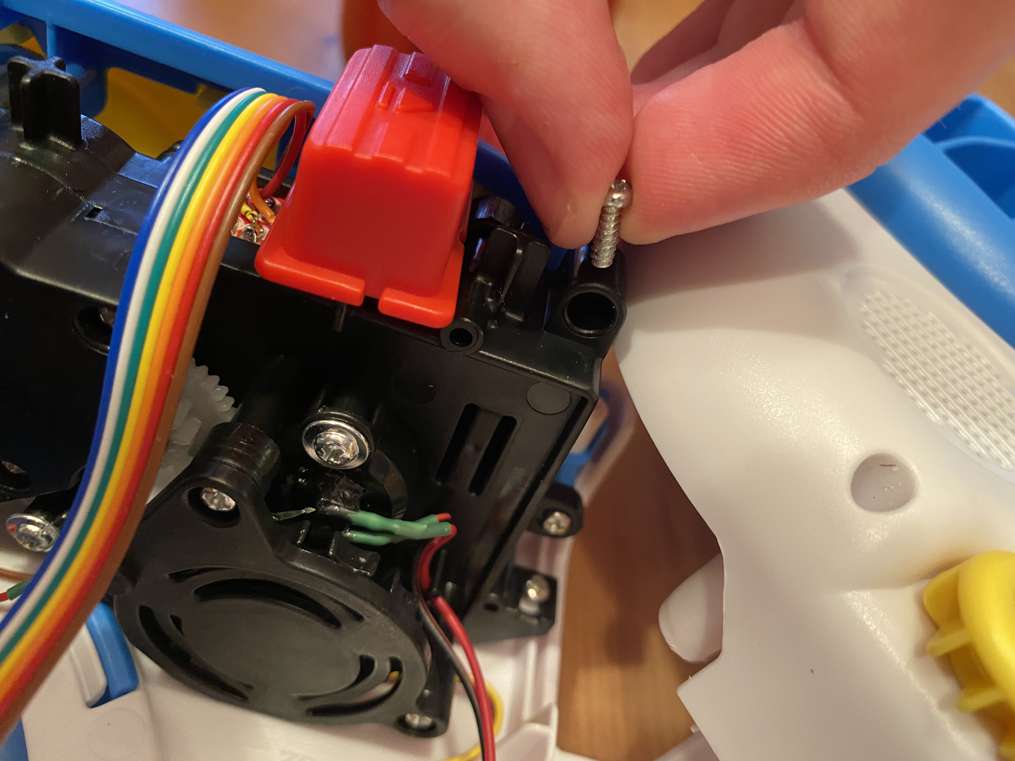
data/devlog/images/Projector_disassembly/screw3.JPG
