mtkimmins/LTSDM_hack/data/devlog/images/Projector_disassembly/screw4.JPG

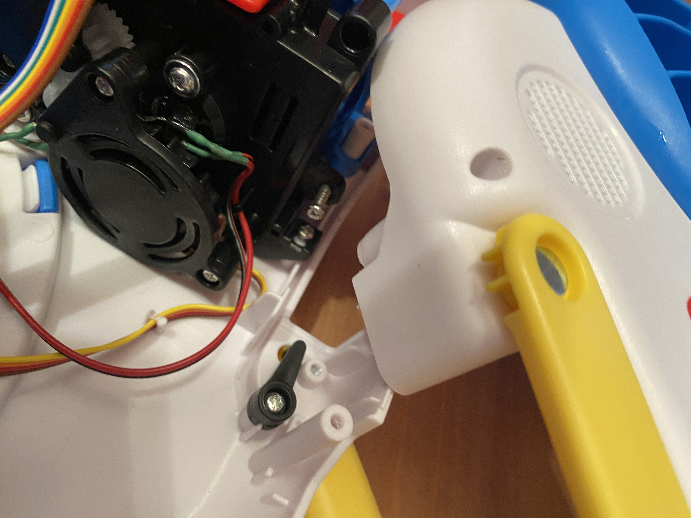
data/devlog/images/Projector_disassembly/screw4.JPG
