mtkimmins/LTSDM_hack/data/devlog/images/Projector_disassembly/screw5.JPG

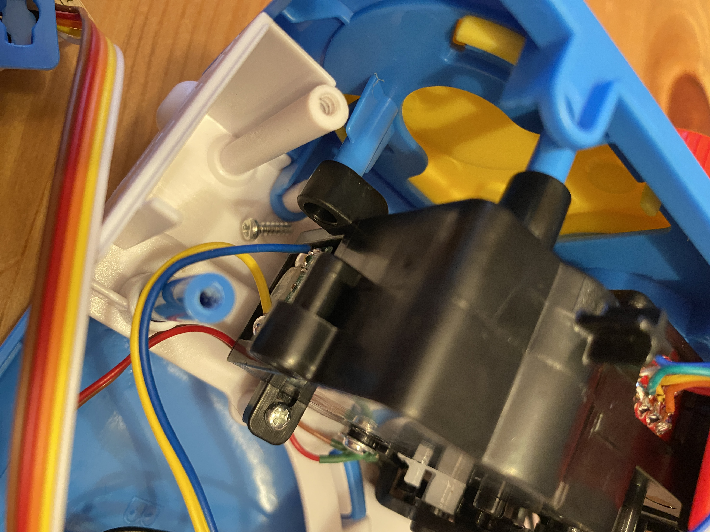
data/devlog/images/Projector_disassembly/screw5.JPG
