mtkimmins/LTSDM_hack/data/devlog/images/Projector_disassembly/screw7.JPG

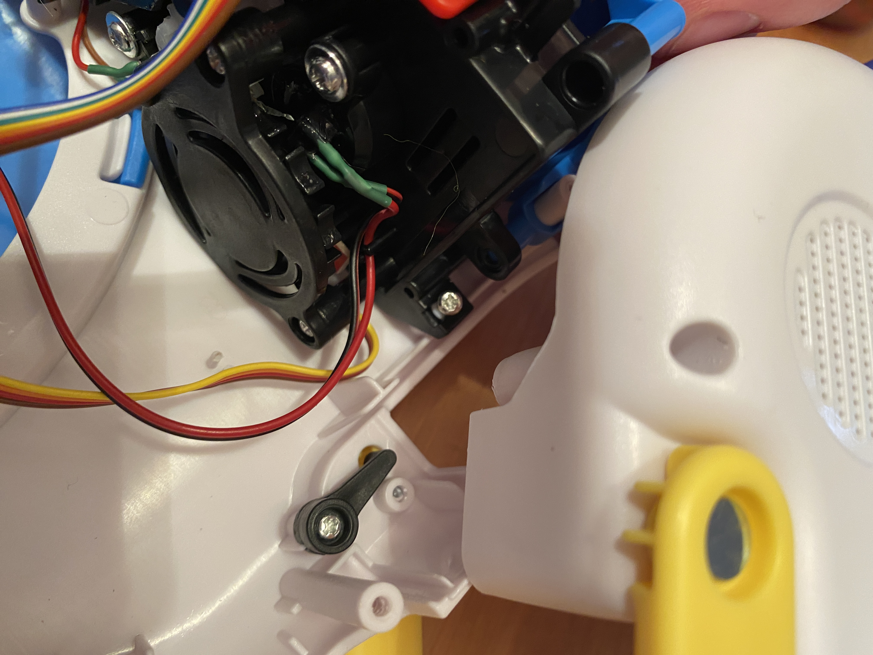
data/devlog/images/Projector_disassembly/screw7.JPG
