mtkimmins/LTSDM_hack/data/devlog/images/Projector_disassembly/screw_locations.JPG

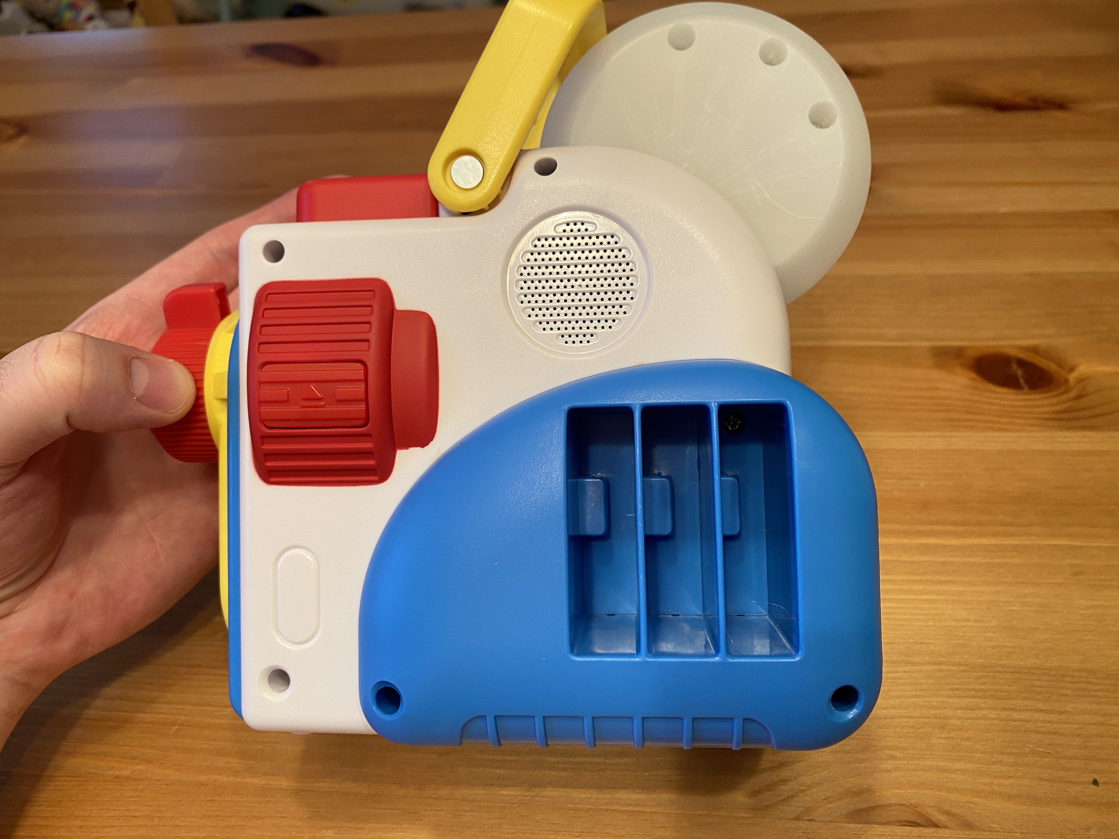
data/devlog/images/Projector_disassembly/screw_locations.JPG
