mtkimmins/LTSDM_hack/data/devlog/images/Projector_disassembly/serial number comparison (new on right).JPG

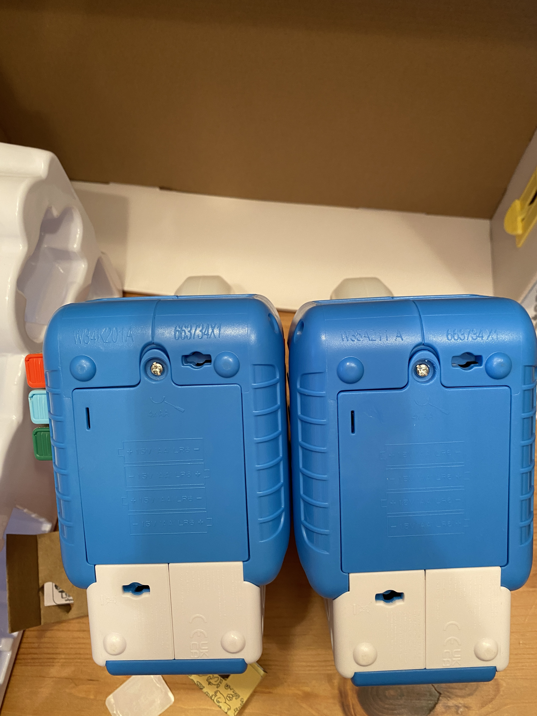
data/devlog/images/Projector_disassembly/serial number comparison (new on right).JPG
