mtkimmins/LTSDM_hack/data/devlog/images/Projector_disassembly/speaker.JPG

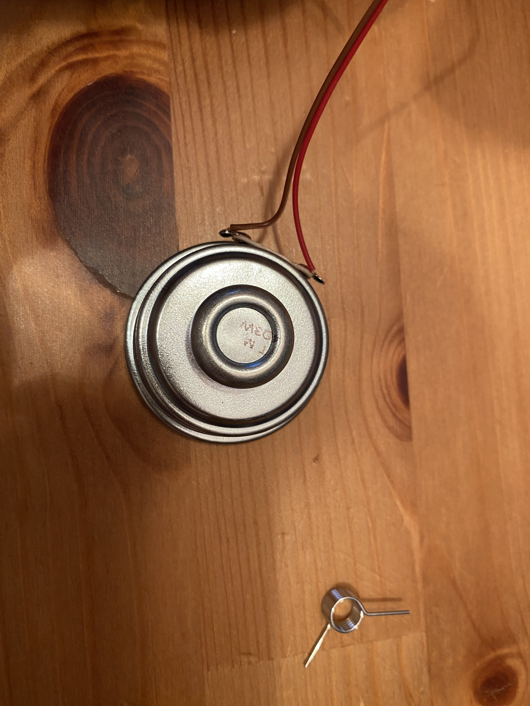
data/devlog/images/Projector_disassembly/speaker.JPG
