mtkimmins/LTSDM_hack/data/devlog/images/shield/soldered-headers-arduino.JPG

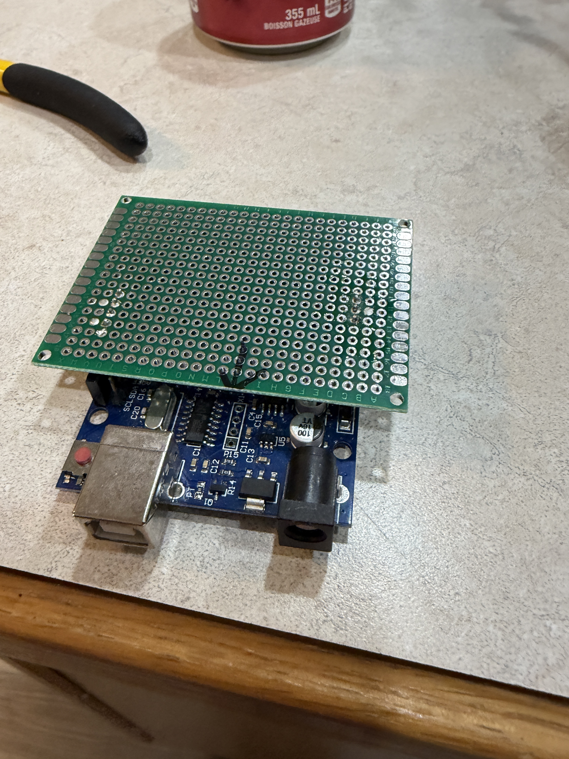
data/devlog/images/shield/soldered-headers-arduino.JPG
