mtkimmins/LTSDM_hack/data/devlog/images/shield/soldering/connecting-dividers.jpg

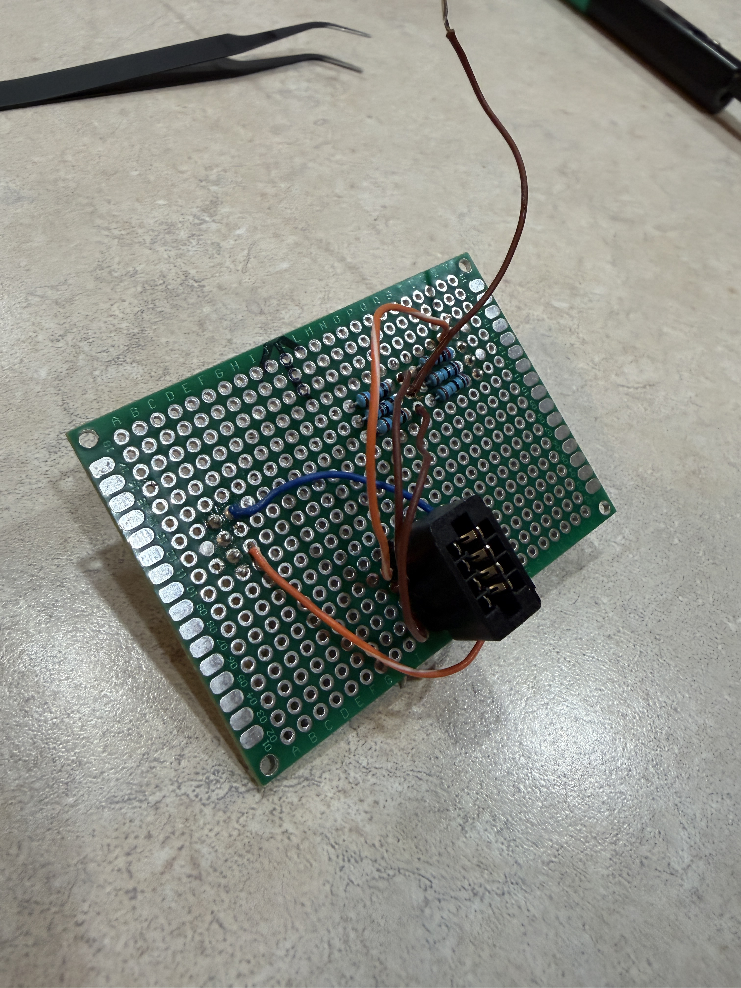
data/devlog/images/shield/soldering/connecting-dividers.jpg
