mtkimmins/LTSDM_hack/data/devlog/images/shield/soldering/divider-final-bottom.jpg

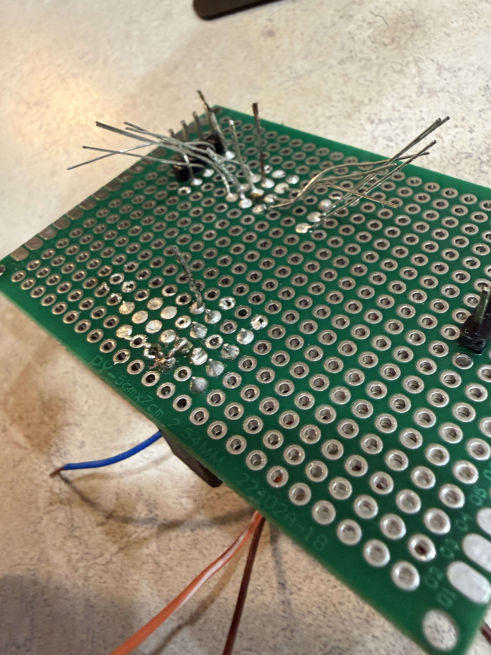
data/devlog/images/shield/soldering/divider-final-bottom.jpg
