mtkimmins/LTSDM_hack/data/devlog/images/shield/soldering/divider-wires-bottom2.jpg

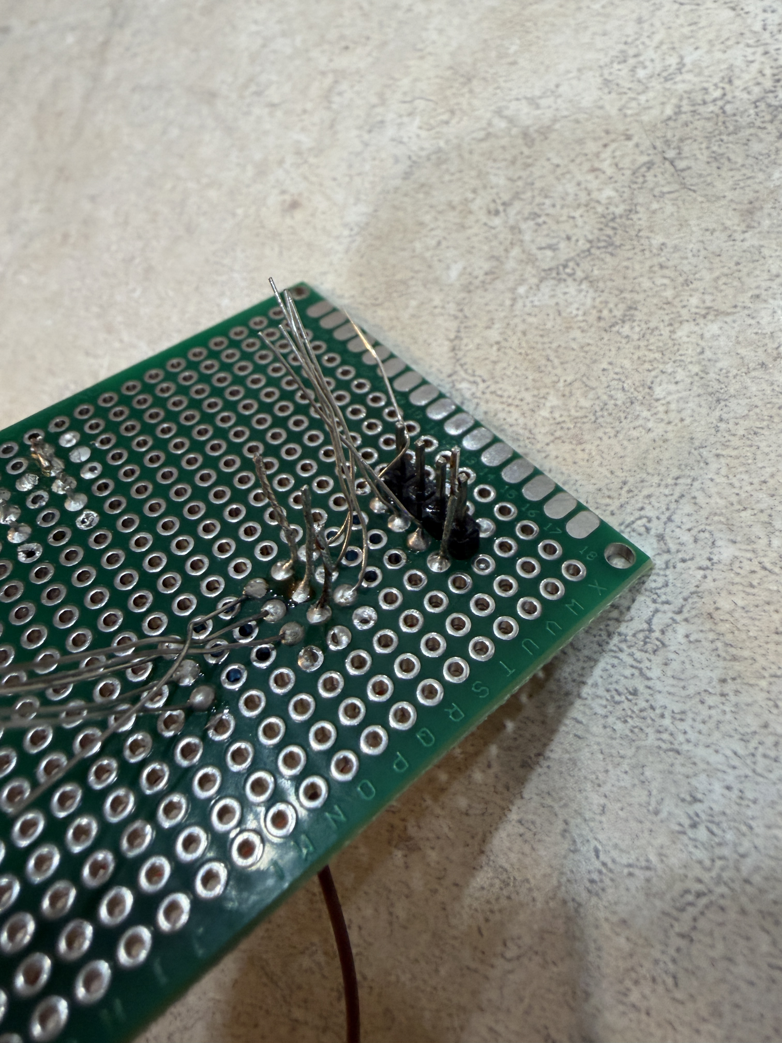
data/devlog/images/shield/soldering/divider-wires-bottom2.jpg
