mtkimmins/LTSDM_hack/data/devlog/images/shield/soldering/divider-wires-bottom.jpg

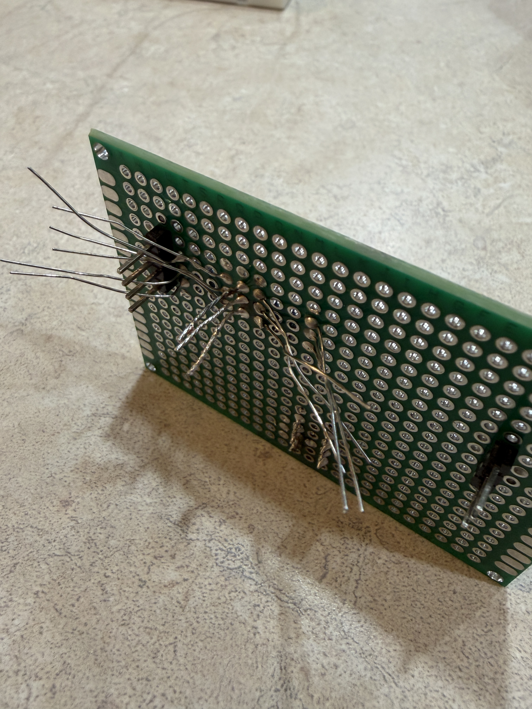
data/devlog/images/shield/soldering/divider-wires-bottom.jpg
