mtkimmins/LTSDM_hack/data/devlog/images/shield/soldering/dry-wire-bottom.jpg

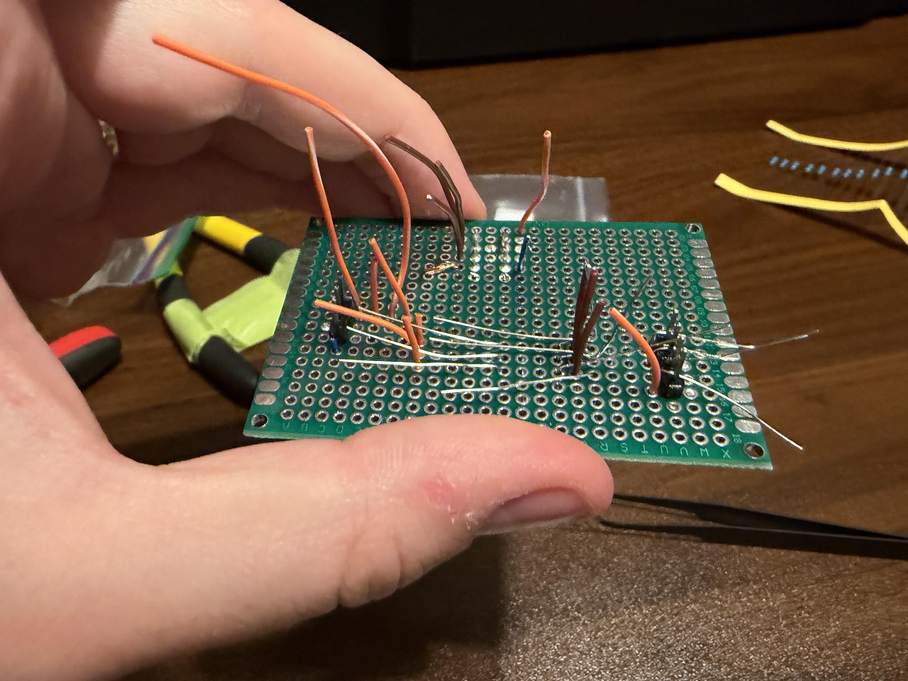
data/devlog/images/shield/soldering/dry-wire-bottom.jpg
