mtkimmins/LTSDM_hack/data/devlog/images/shield/soldering/dry-wire-top1.jpg

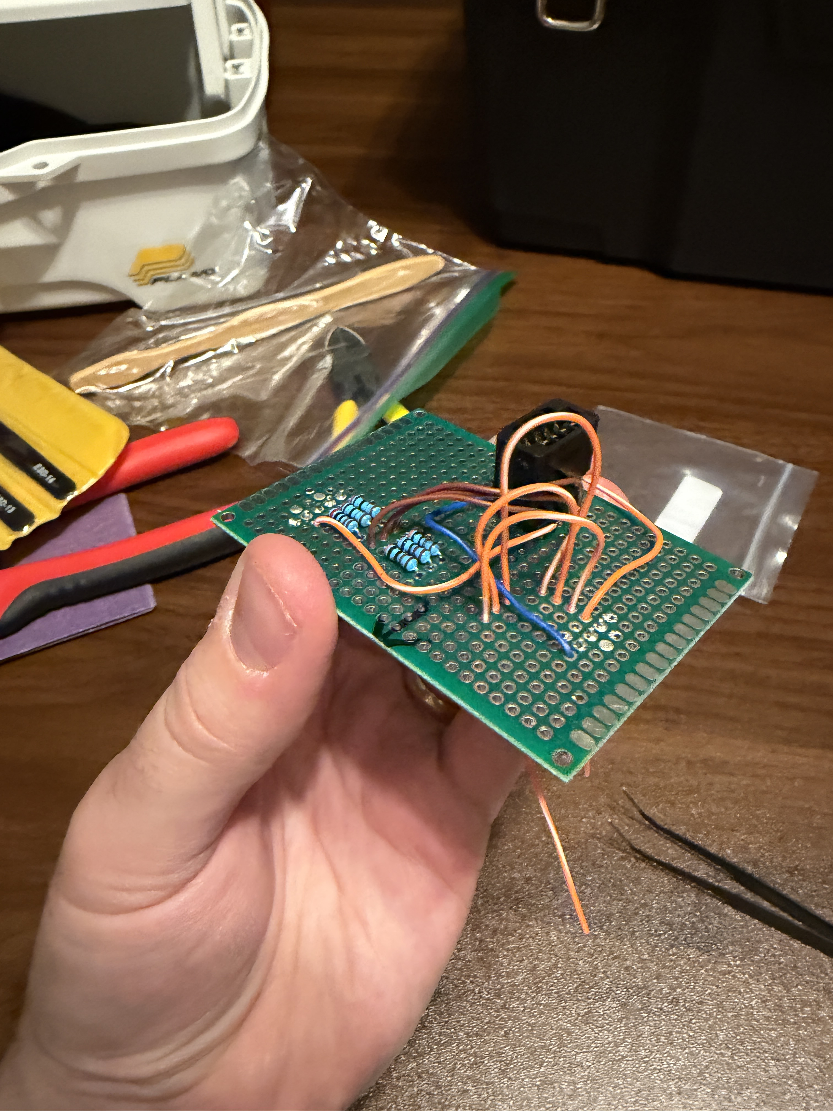
data/devlog/images/shield/soldering/dry-wire-top1.jpg
