mtkimmins/LTSDM_hack/data/devlog/images/shield/soldering/final2.jpg

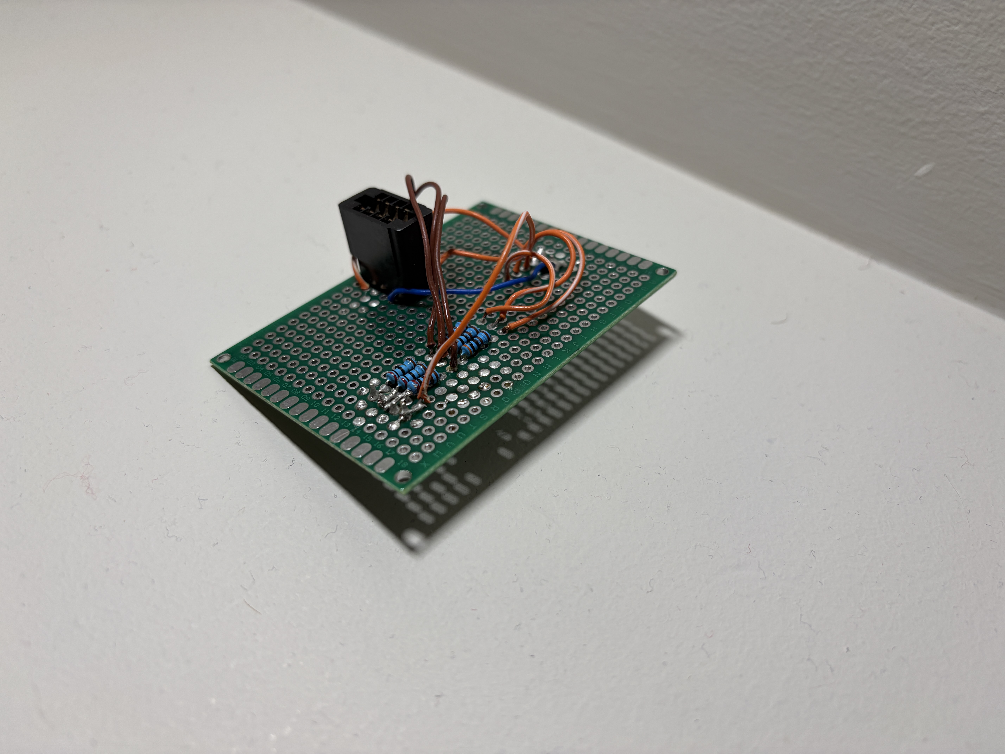
data/devlog/images/shield/soldering/final2.jpg
