mtkimmins/LTSDM_hack/data/devlog/images/shield/soldering/final-bottom.jpg

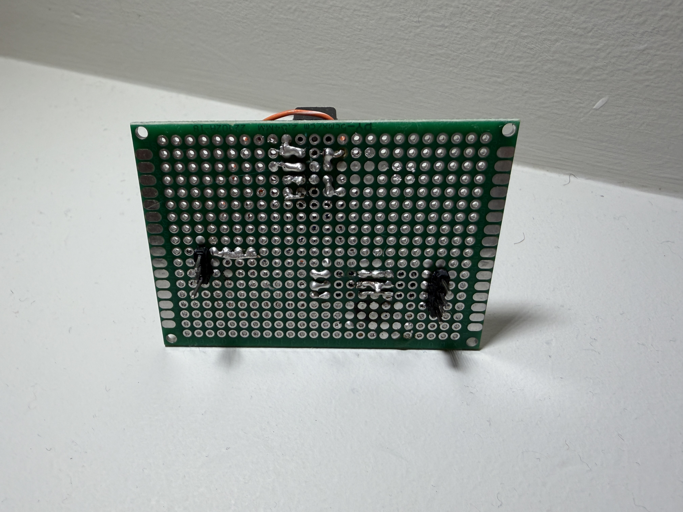
data/devlog/images/shield/soldering/final-bottom.jpg
