mtkimmins/LTSDM_hack/data/devlog/images/shield/soldering/miso-wire.jpg

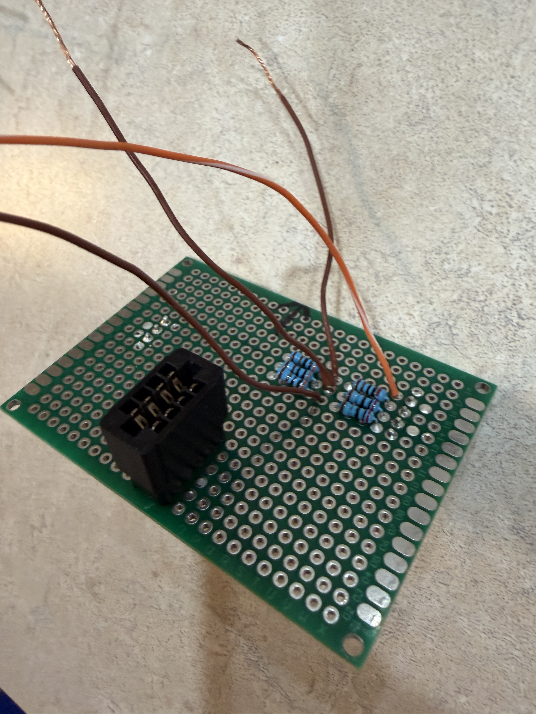
data/devlog/images/shield/soldering/miso-wire.jpg
