mtkimmins/LTSDM_hack/data/devlog/images/shield/soldering/pre-solder-bridge-bottom.jpg

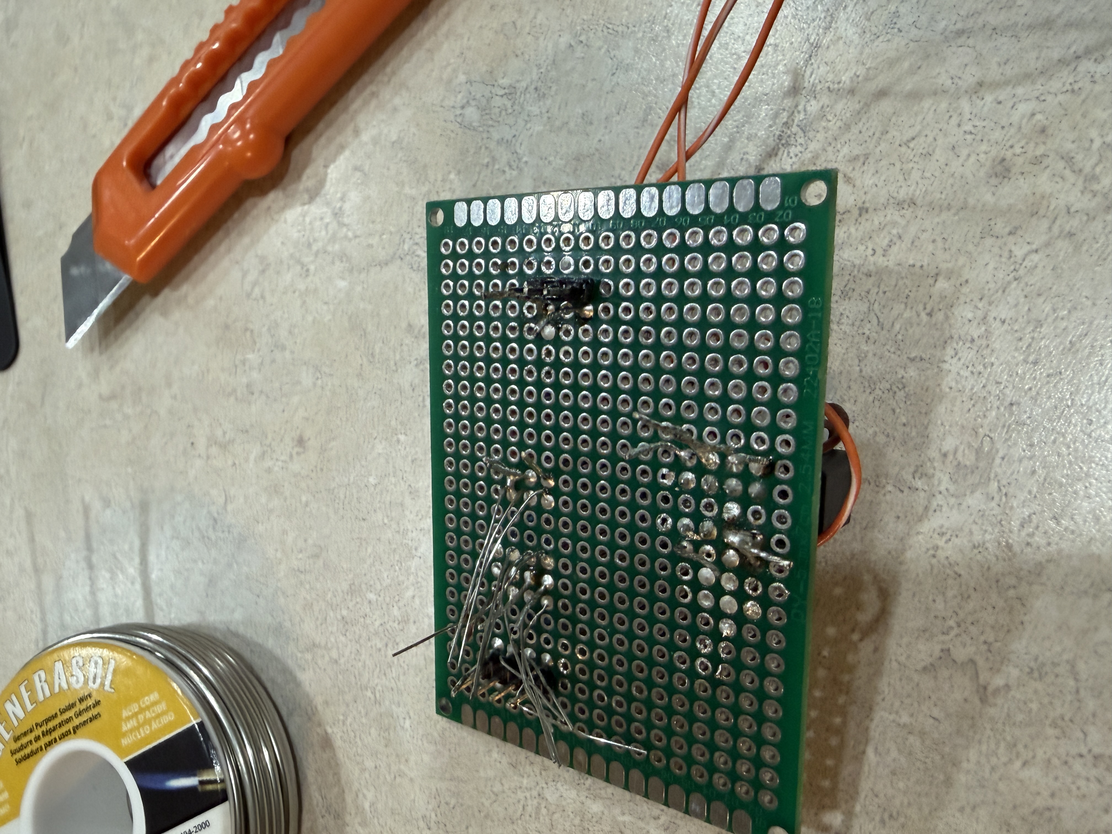
data/devlog/images/shield/soldering/pre-solder-bridge-bottom.jpg
