mtkimmins/LTSDM_hack/data/devlog/images/shield/soldering/pre-trim-bottom.jpg

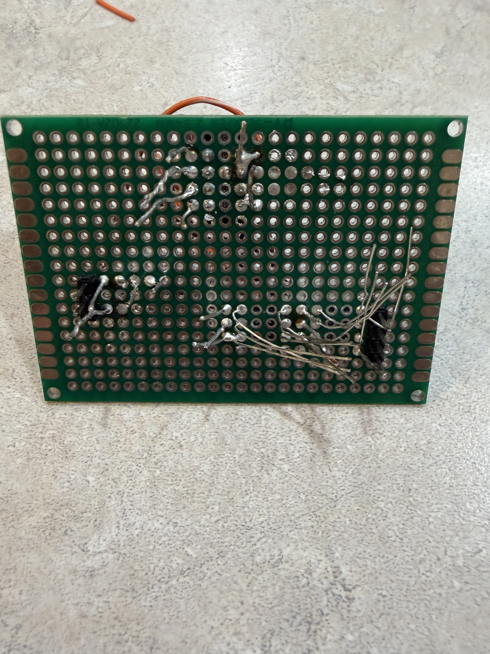
data/devlog/images/shield/soldering/pre-trim-bottom.jpg
