mtkimmins/LTSDM_hack/data/devlog/images/shield/soldering/soldered-resistors-bottom.jpg

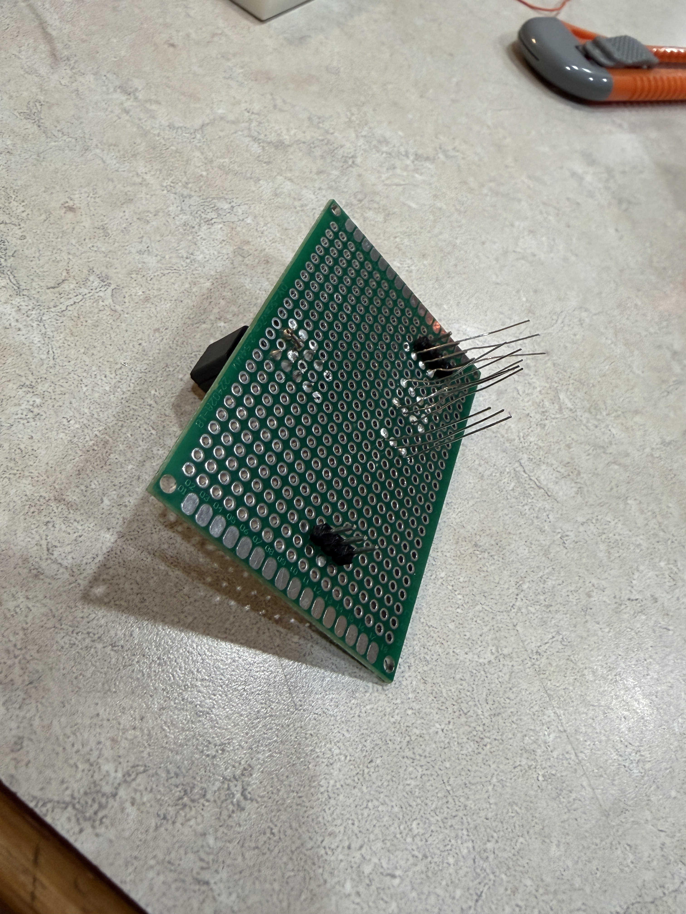
data/devlog/images/shield/soldering/soldered-resistors-bottom.jpg
