mtkimmins/LTSDM_hack/data/devlog/images/shield/soldering/vcc-chip2.jpg

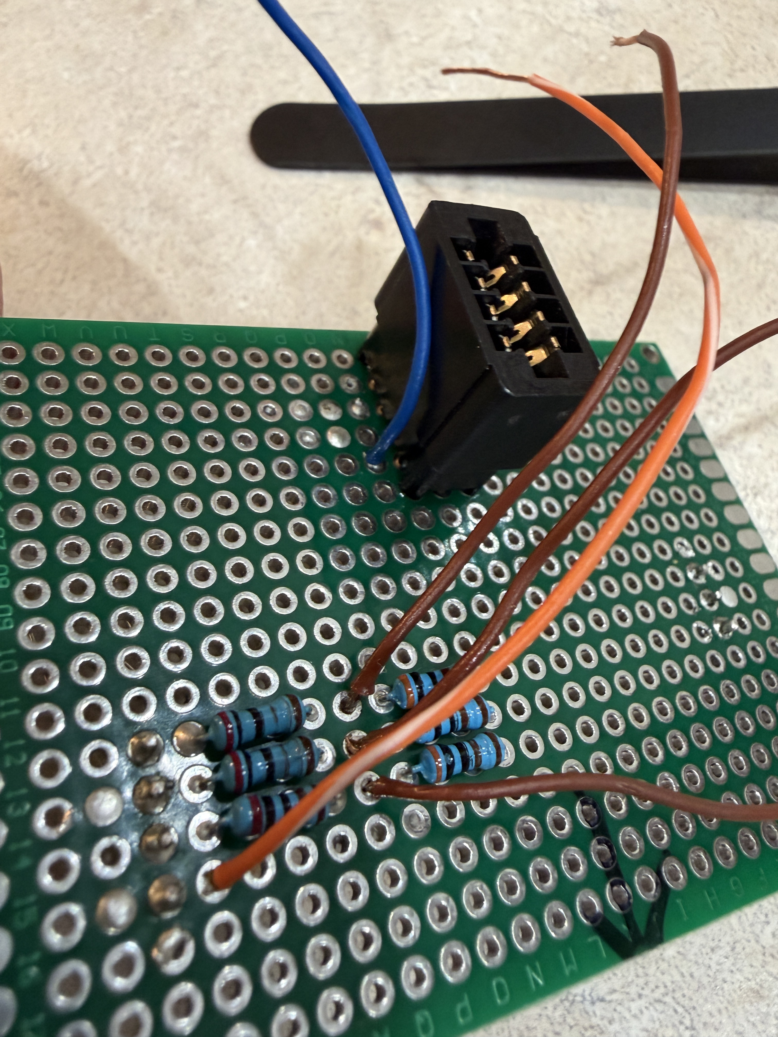
data/devlog/images/shield/soldering/vcc-chip2.jpg
