mtkimmins/LTSDM_hack/data/devlog/images/WiringSetup/cartridge_adapter_wiring_diagram.JPG

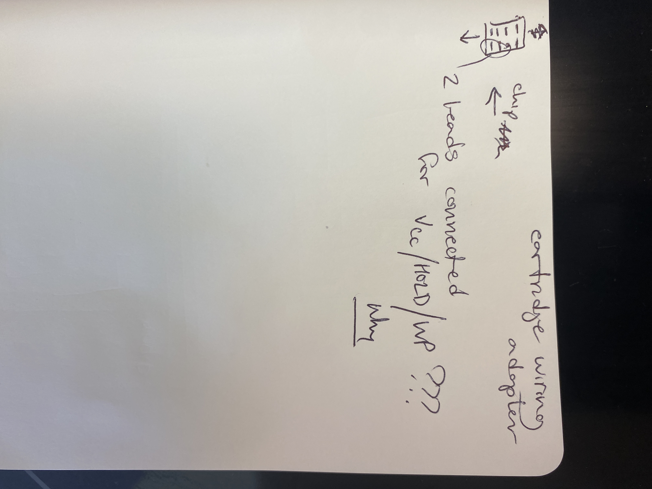
data/devlog/images/WiringSetup/cartridge_adapter_wiring_diagram.JPG
