mtkimmins/LTSDM_hack/data/devlog/images/WiringSetup/official-guide/soldered-socket.JPG

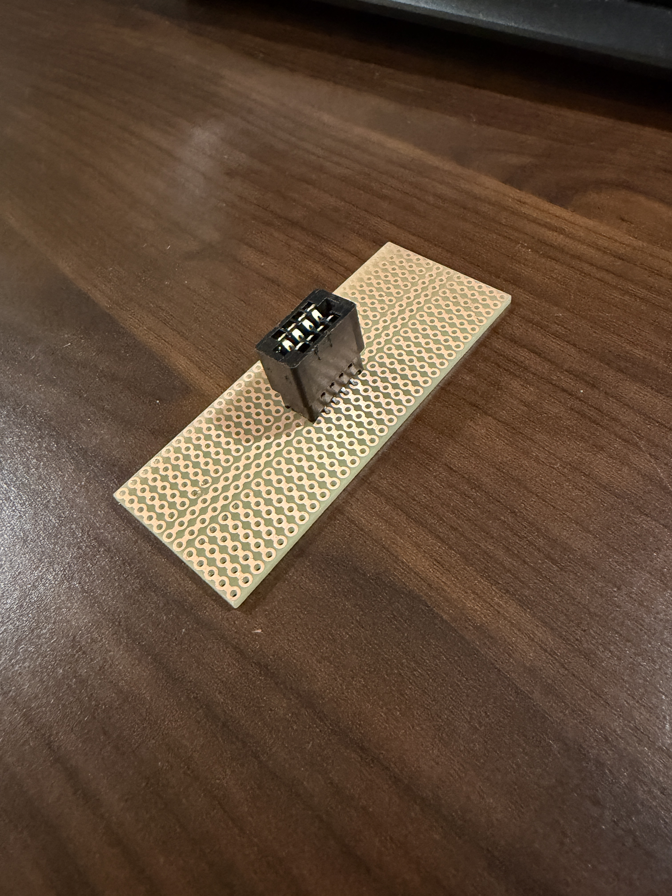
data/devlog/images/WiringSetup/official-guide/soldered-socket.JPG
