mtkimmins/LTSDM_hack/data/devlog/images/CaseMeasurements/port-end-measurements.png

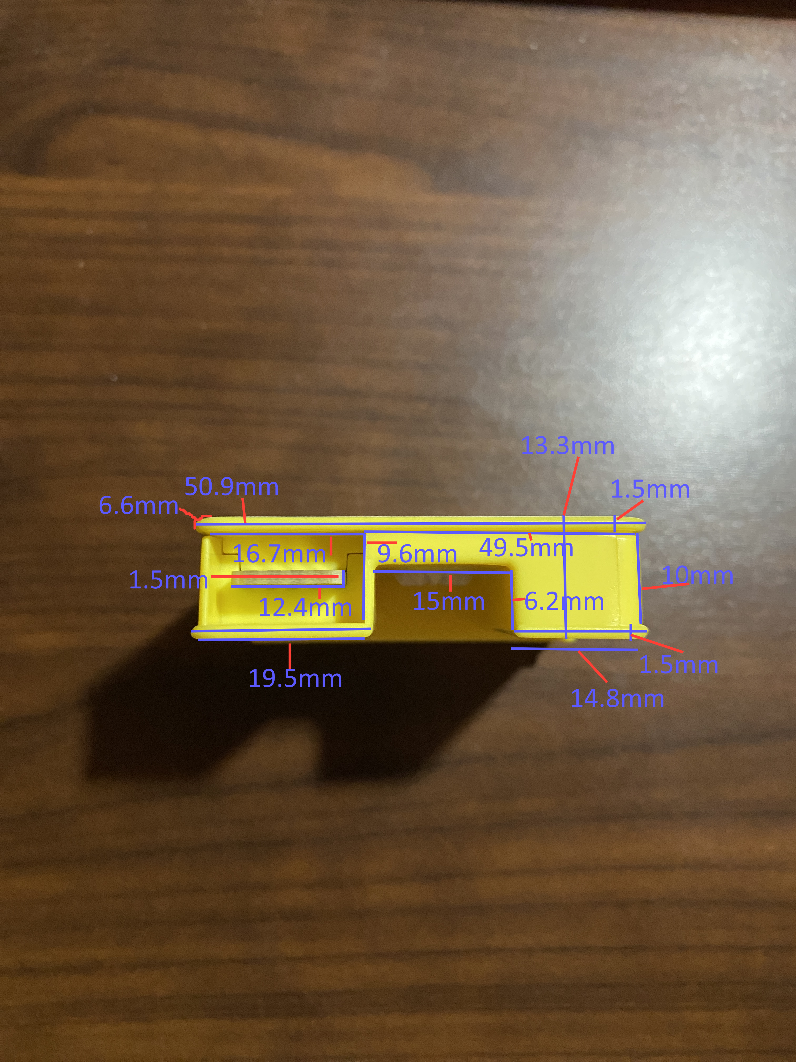
data/devlog/images/CaseMeasurements/port-end-measurements.png
