mtkimmins/LTSDM_hack/data/devlog/images/CaseMeasurements/side-measurements.png

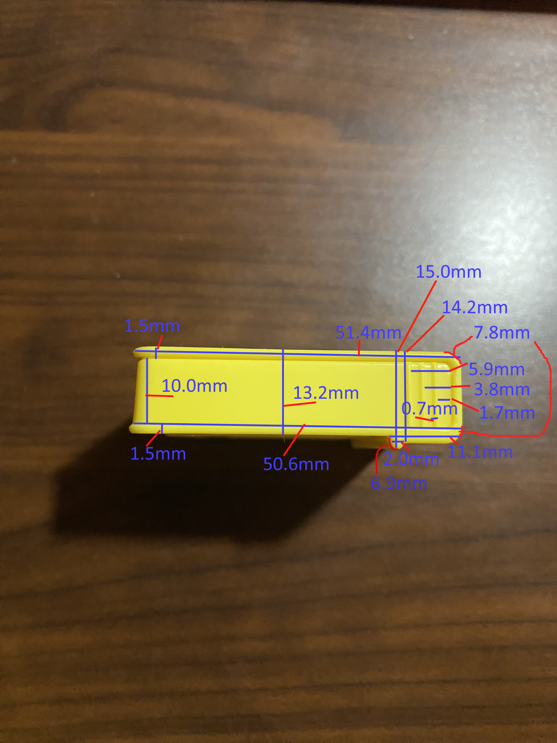
data/devlog/images/CaseMeasurements/side-measurements.png
