mtkimmins/LTSDM_hack/data/devlog/images/ImHex_screenshots/Diff_Results1.PNG

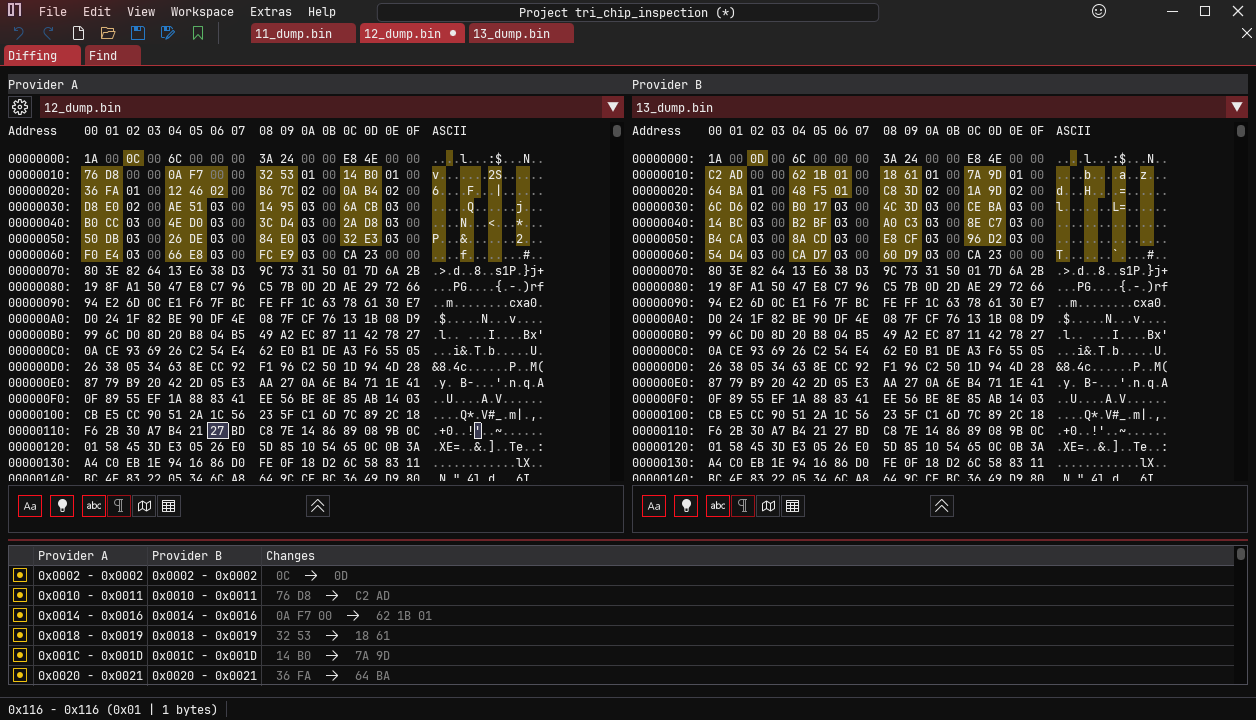
data/devlog/images/ImHex_screenshots/Diff_Results1.PNG
