mtkimmins/LTSDM_hack/data/devlog/images/ImHex_screenshots/Diff_Results.PNG

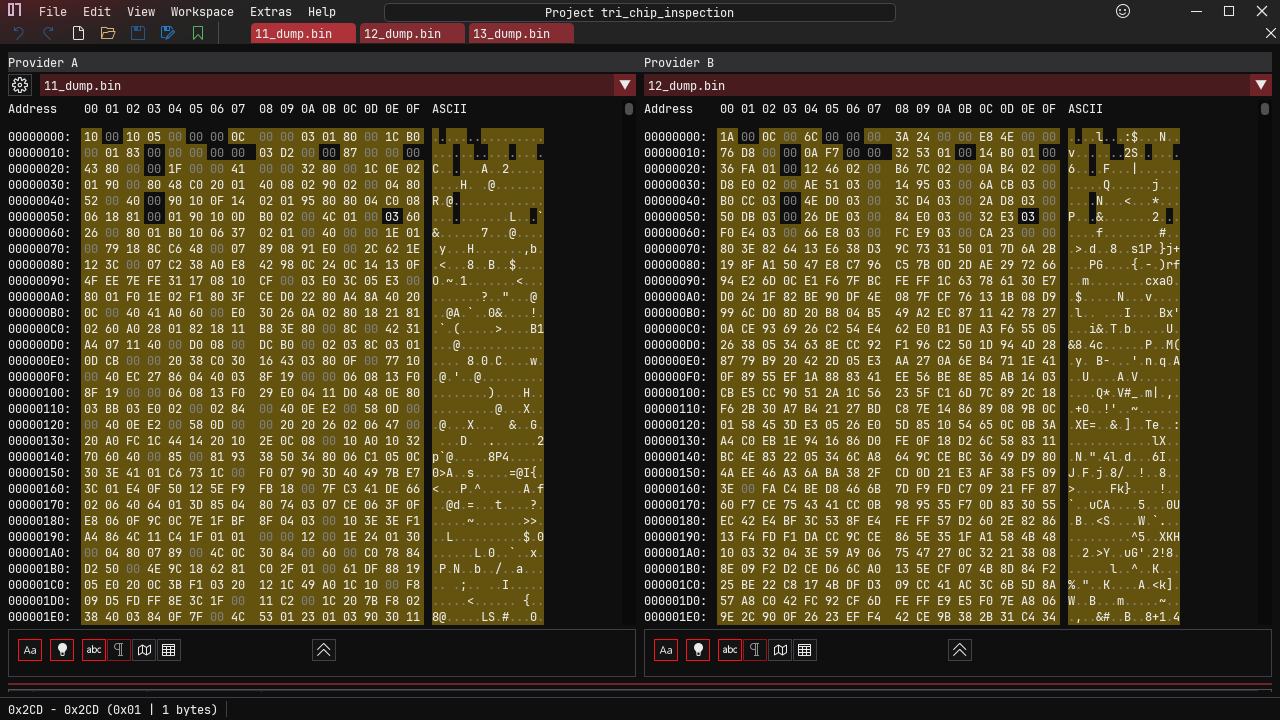
data/devlog/images/ImHex_screenshots/Diff_Results.PNG
