mtkimmins/LTSDM_hack/data/devlog/images/ImHex_screenshots/test1-terminal.png

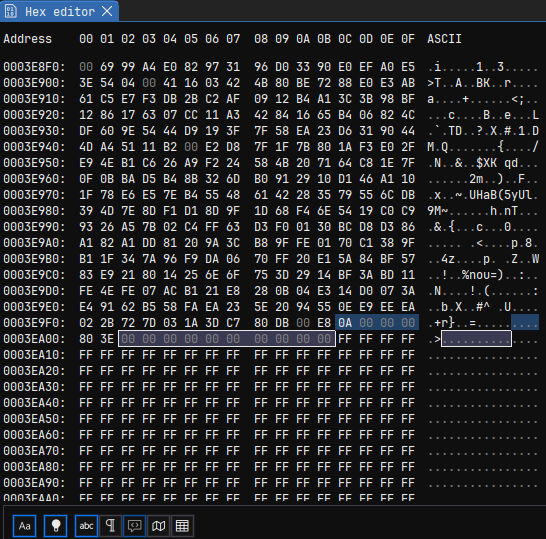
data/devlog/images/ImHex_screenshots/test1-terminal.png
