mtkimmins/LTSDM_hack/data/devlog/images/BinaryDiffs/GoldStandardComparisons/beginning1.PNG

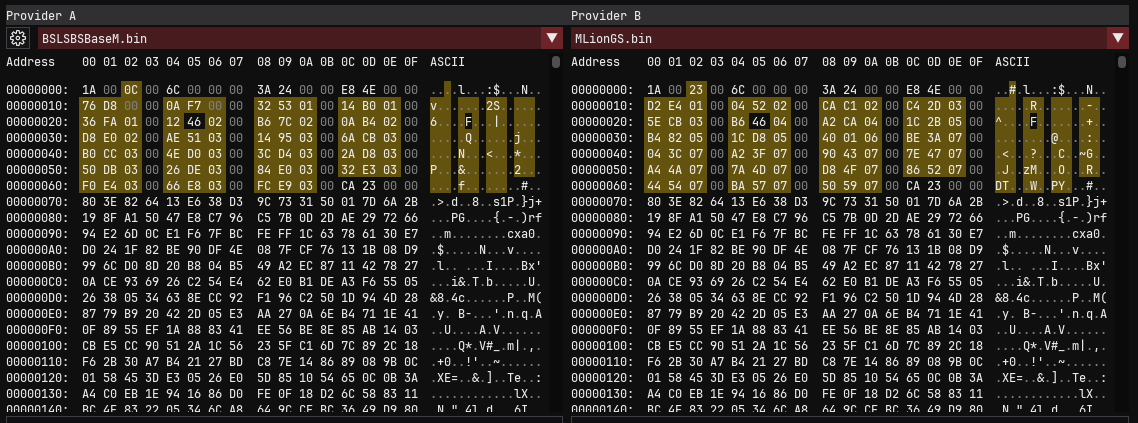
data/devlog/images/BinaryDiffs/GoldStandardComparisons/beginning1.PNG
