mtkimmins/LTSDM_hack/data/devlog/images/BinaryDiffs/GoldStandardComparisons/beginning2.PNG

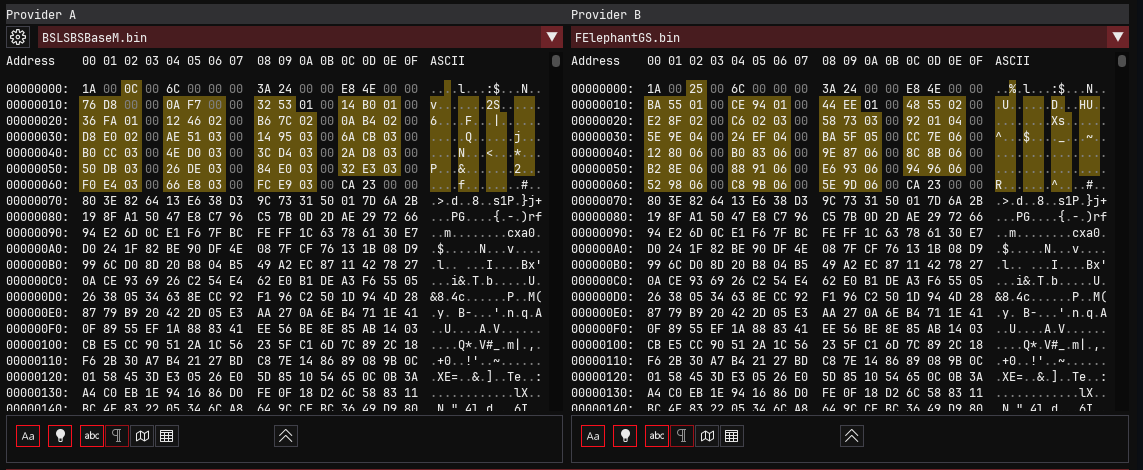
data/devlog/images/BinaryDiffs/GoldStandardComparisons/beginning2.PNG
