mtkimmins/LTSDM_hack/data/devlog/images/BinaryDiffs/GoldStandardComparisons/beginning3.PNG

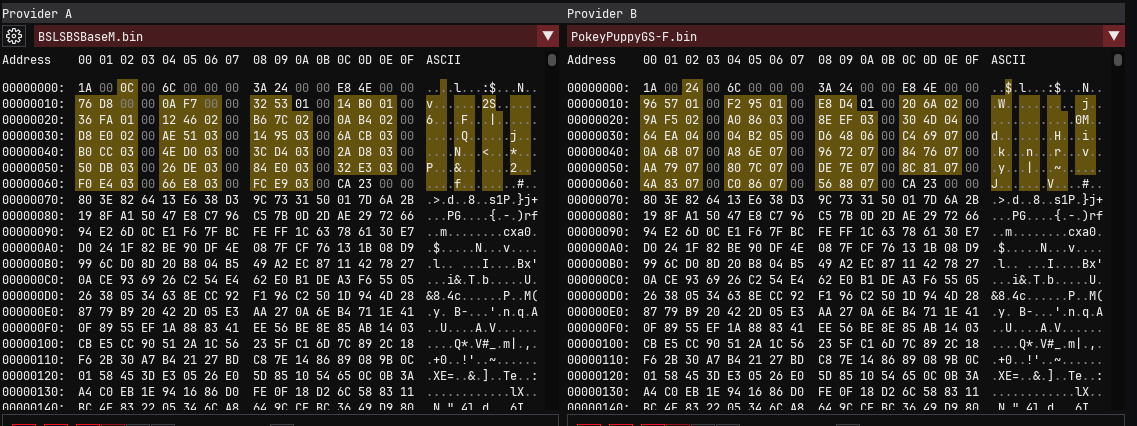
data/devlog/images/BinaryDiffs/GoldStandardComparisons/beginning3.PNG
