mtkimmins/LTSDM_hack/data/devlog/images/BinaryDiffs/GoldStandardComparisons/gold_standard_diff_match.png

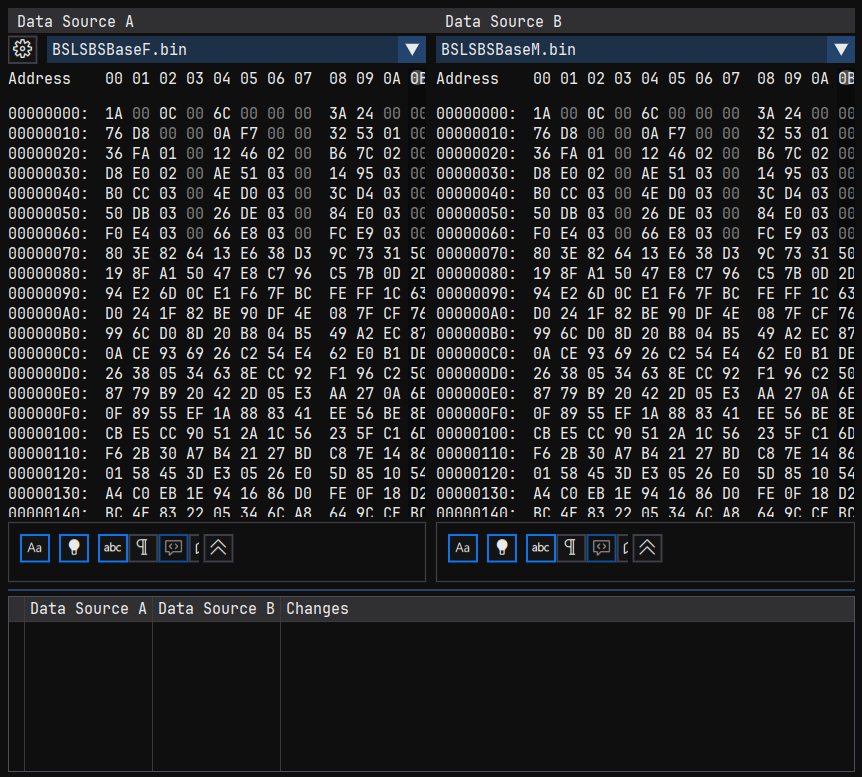
data/devlog/images/BinaryDiffs/GoldStandardComparisons/gold_standard_diff_match.png
