mtkimmins/LTSDM_hack/data/devlog/images/BinaryDiffs/GoldStandardComparisons/sameEnd1.PNG

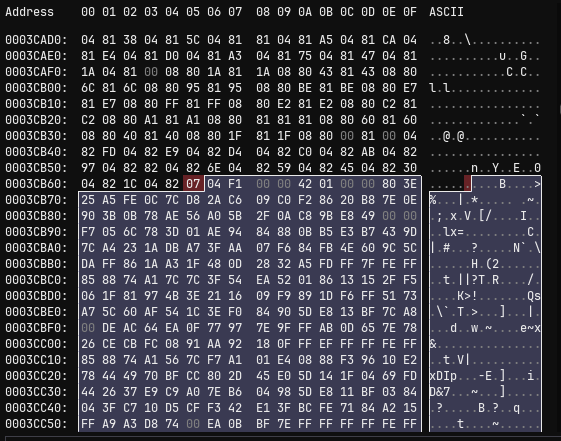
data/devlog/images/BinaryDiffs/GoldStandardComparisons/sameEnd1.PNG
