mtkimmins/LTSDM_hack/data/devlog/images/BinaryDiffs/GoldStandardComparisons/sameEnd2.PNG

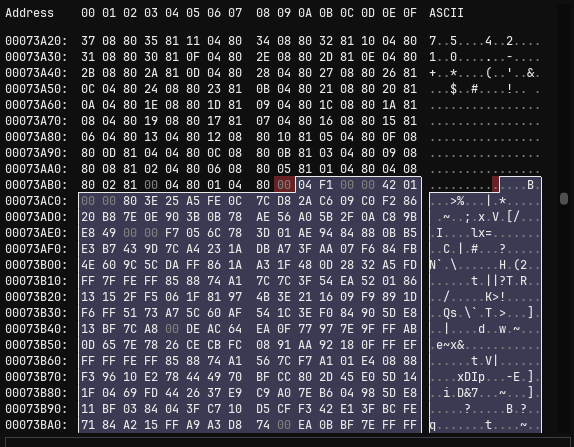
data/devlog/images/BinaryDiffs/GoldStandardComparisons/sameEnd2.PNG
