mtkimmins/LTSDM_hack/data/devlog/images/BinaryDiffs/GoldStandardComparisons/sameEnd3.PNG

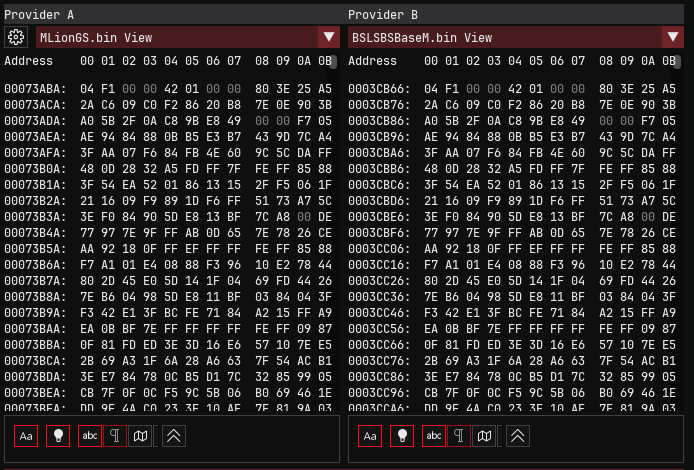
data/devlog/images/BinaryDiffs/GoldStandardComparisons/sameEnd3.PNG
