mtkimmins/LTSDM_hack/data/devlog/images/BinaryDiffs/GoldStandardComparisons/terminal1.PNG

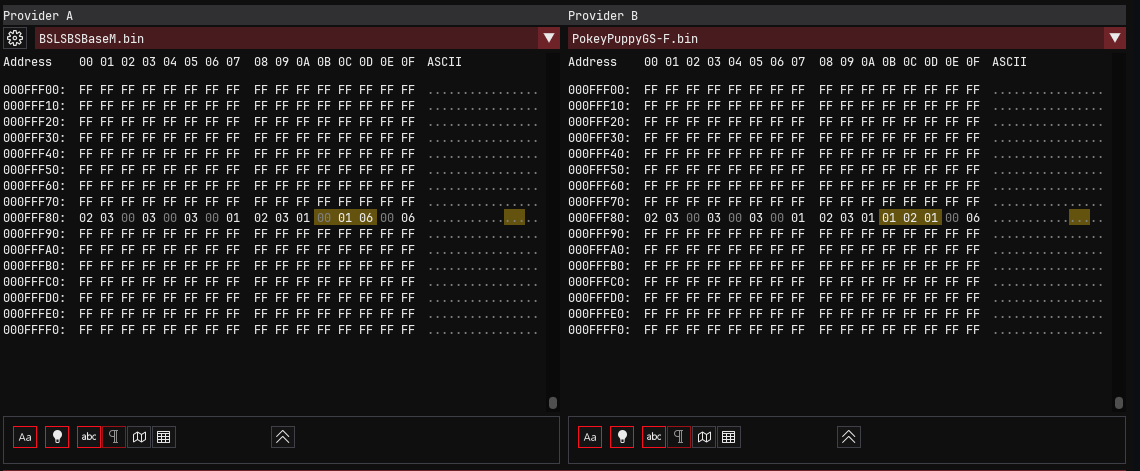
data/devlog/images/BinaryDiffs/GoldStandardComparisons/terminal1.PNG
