mtkimmins/LTSDM_hack/data/devlog/images/BinaryDiffs/GoldStandardComparisons/terminal2.PNG

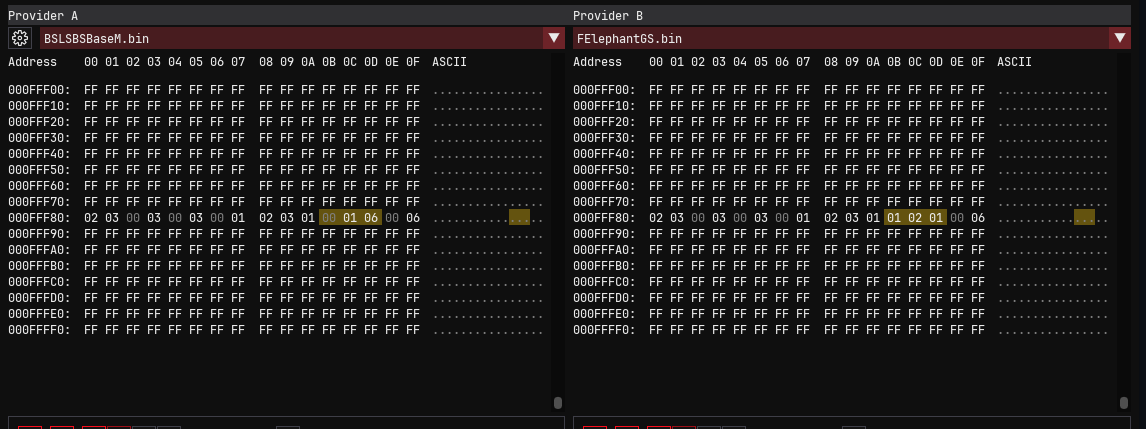
data/devlog/images/BinaryDiffs/GoldStandardComparisons/terminal2.PNG
