mtkimmins/LTSDM_hack/data/devlog/images/BinaryDiffs/GoldStandardComparisons/terminal3.PNG

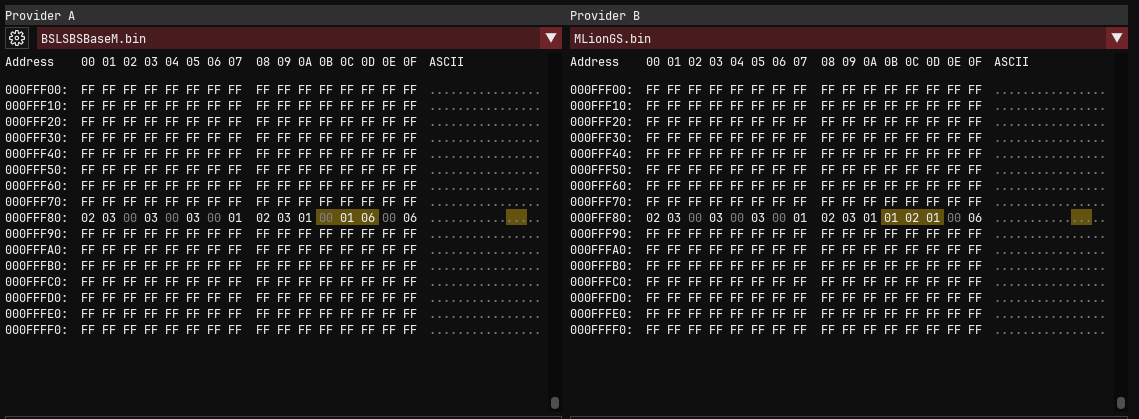
data/devlog/images/BinaryDiffs/GoldStandardComparisons/terminal3.PNG
