mtkimmins/LTSDM_hack/data/devlog/images/BinaryDiffs/GoldStandardComparisons/uniqueBorder1.PNG

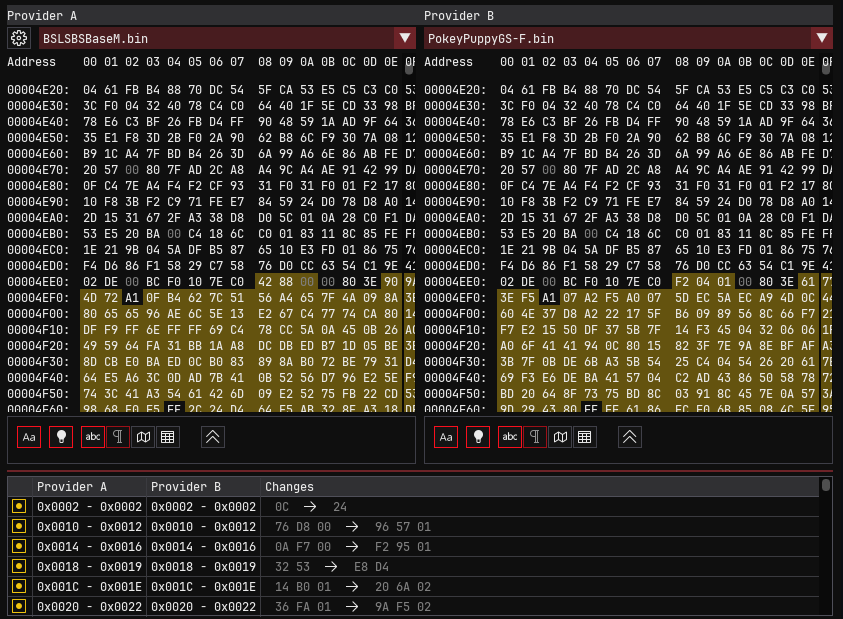
data/devlog/images/BinaryDiffs/GoldStandardComparisons/uniqueBorder1.PNG
