mtkimmins/LTSDM_hack/data/devlog/images/BinaryDiffs/GoldStandardComparisons/uniqueBorder2.PNG

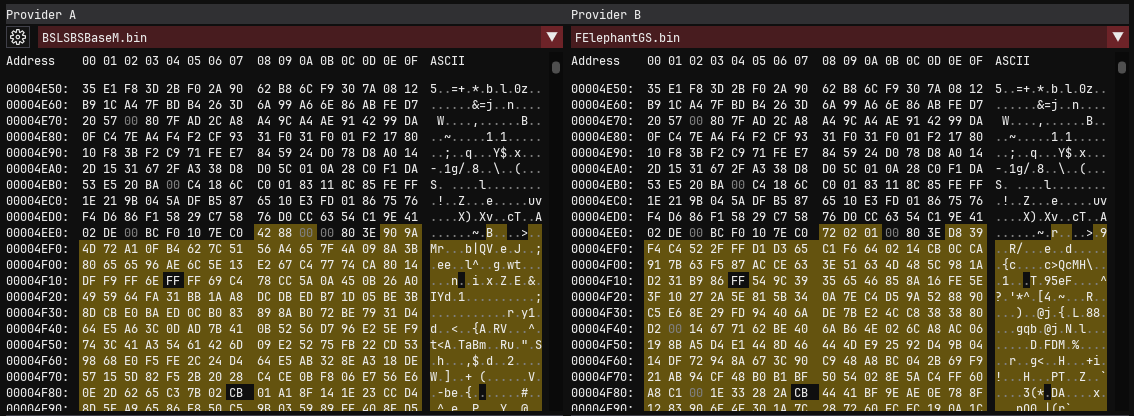
data/devlog/images/BinaryDiffs/GoldStandardComparisons/uniqueBorder2.PNG
