mtkimmins/LTSDM_hack/data/devlog/images/BinaryDiffs/GoldStandardComparisons/uniqueBorder3.PNG

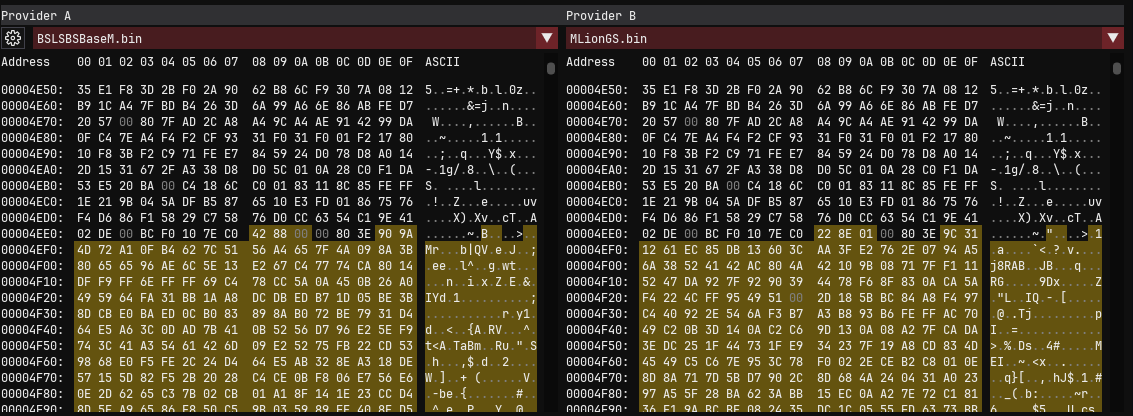
data/devlog/images/BinaryDiffs/GoldStandardComparisons/uniqueBorder3.PNG
