mtkimmins/LTSDM_hack/data/devlog/images/BinaryDiffs/GS-Diff-BSLSBS.PNG

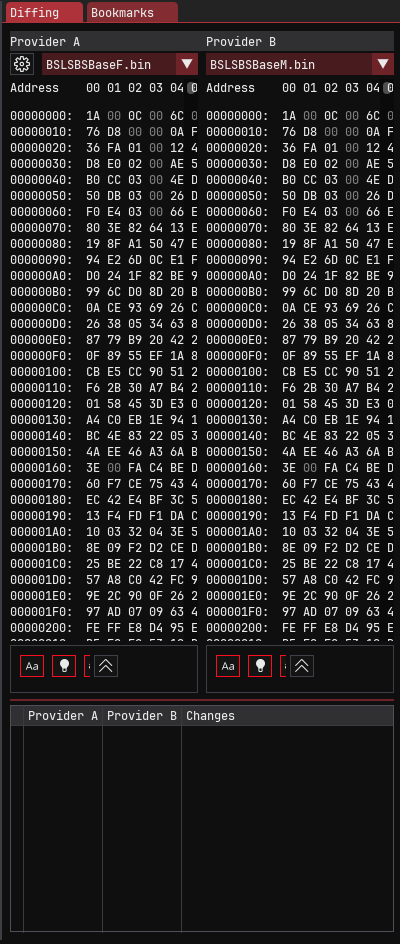
data/devlog/images/BinaryDiffs/GS-Diff-BSLSBS.PNG
