mtkimmins/LTSDM_hack/data/devlog/images/BinaryDiffs/GS-Region-Analysis/region 1-3 terminal alignment BSLSBS.PNG

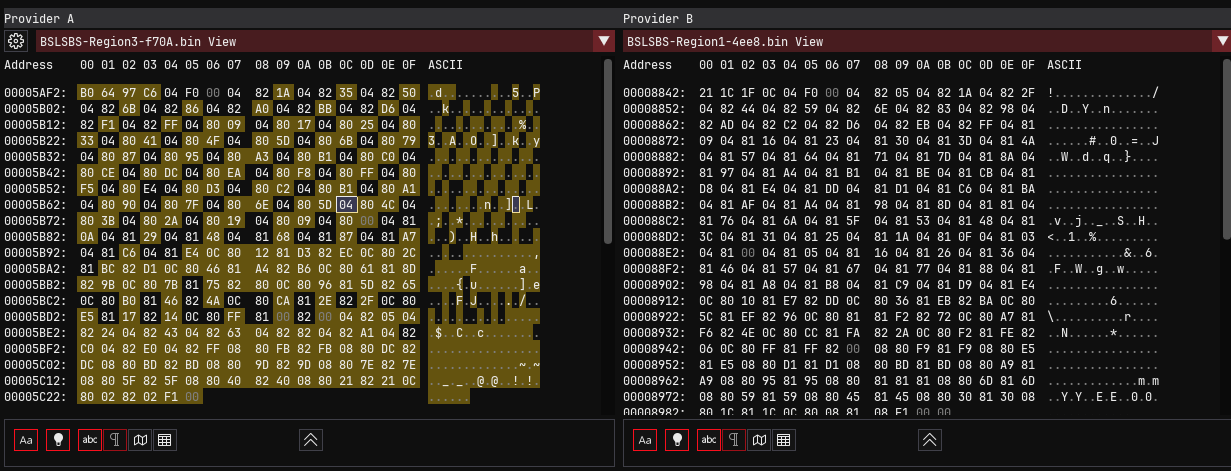
data/devlog/images/BinaryDiffs/GS-Region-Analysis/region 1-3 terminal alignment BSLSBS.PNG
