mtkimmins/LTSDM_hack/data/devlog/images/BinaryDiffs/GS-Region-Analysis/region ends 1-3 BSLSBS.PNG

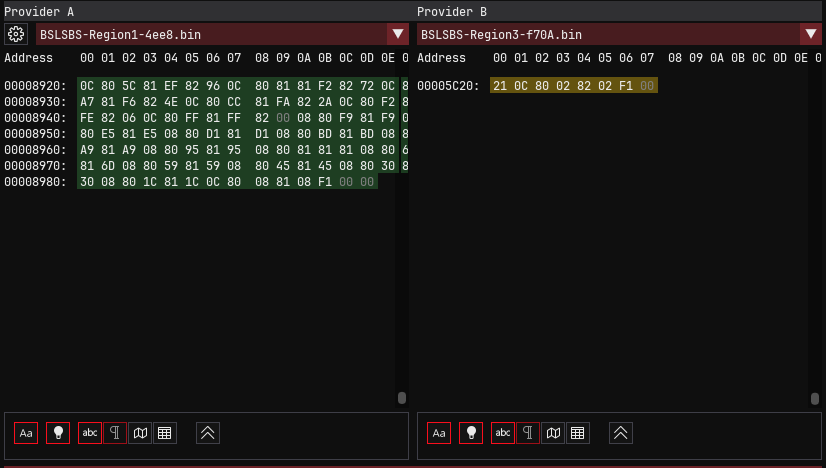
data/devlog/images/BinaryDiffs/GS-Region-Analysis/region ends 1-3 BSLSBS.PNG
