mtkimmins/LTSDM_hack/data/devlog/images/BinaryDiffs/GS-Region-Analysis/region pointer 1 BSLSBS end.PNG

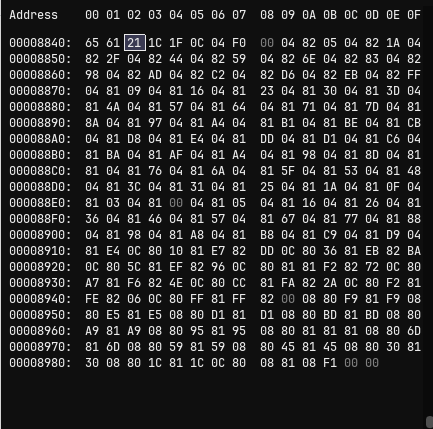
data/devlog/images/BinaryDiffs/GS-Region-Analysis/region pointer 1 BSLSBS end.PNG
