mtkimmins/LTSDM_hack/data/devlog/images/BinaryDiffs/PCM-Analysis/injection-diff.png

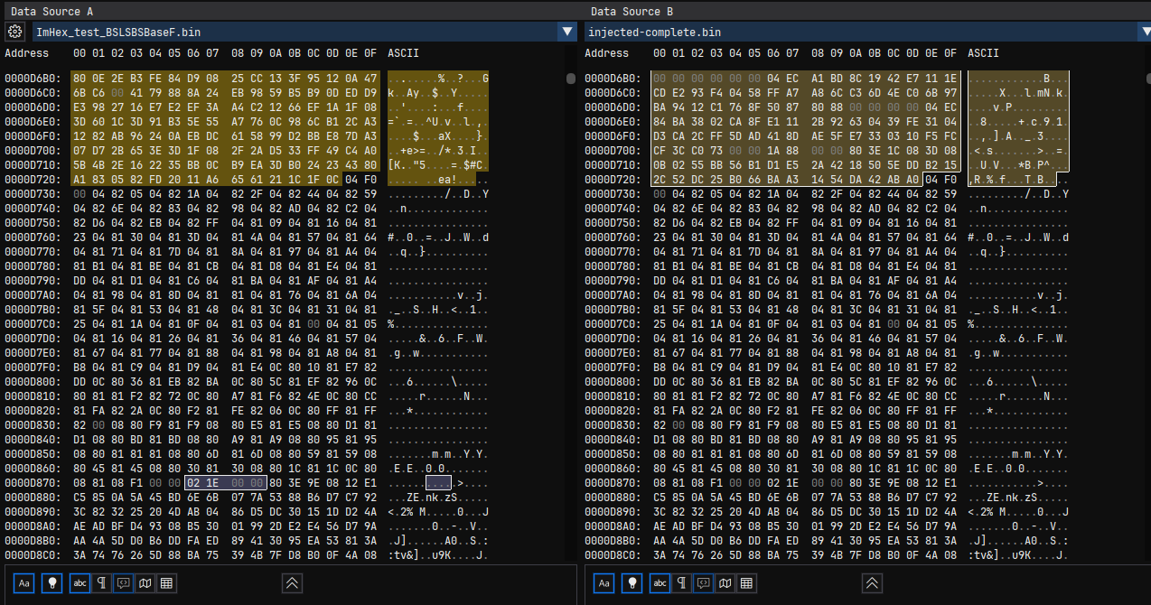
data/devlog/images/BinaryDiffs/PCM-Analysis/injection-diff.png
