mtkimmins/LTSDM_hack/data/devlog/images/BinaryDiffs/PCM-Analysis/puppy-BSLSBS-region1-mapDiff.PNG

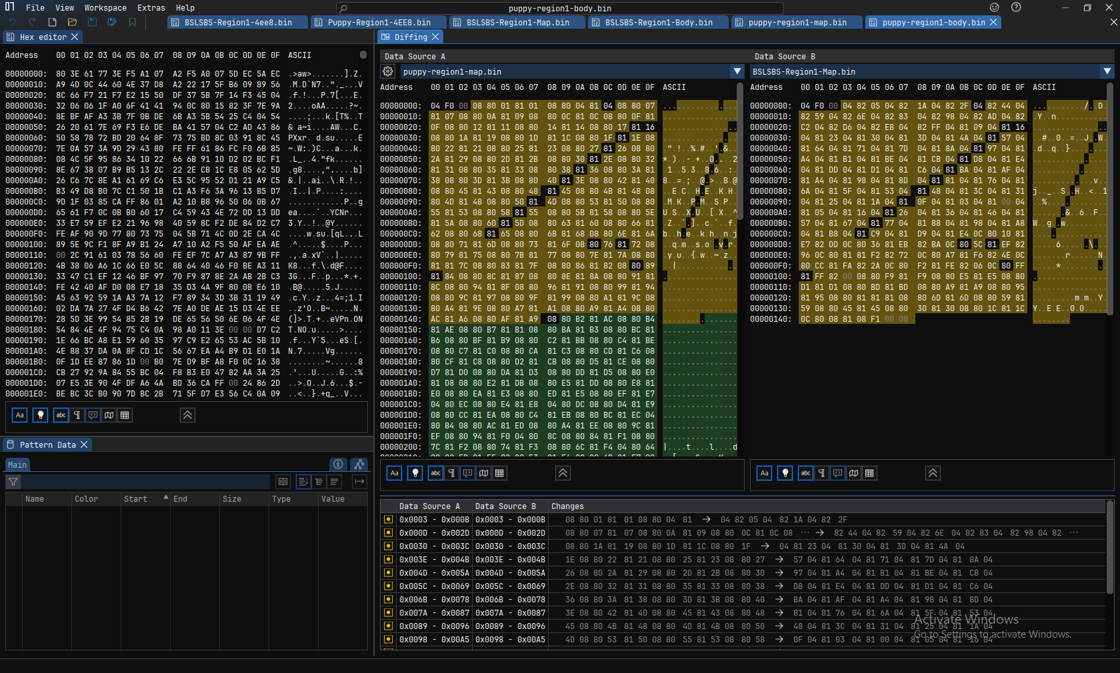
data/devlog/images/BinaryDiffs/PCM-Analysis/puppy-BSLSBS-region1-mapDiff.PNG
