mtkimmins/LTSDM_hack/data/devlog/images/BinaryDiffs/Region-Segment-Comparison/BSLSBS-8556-highlight.PNG

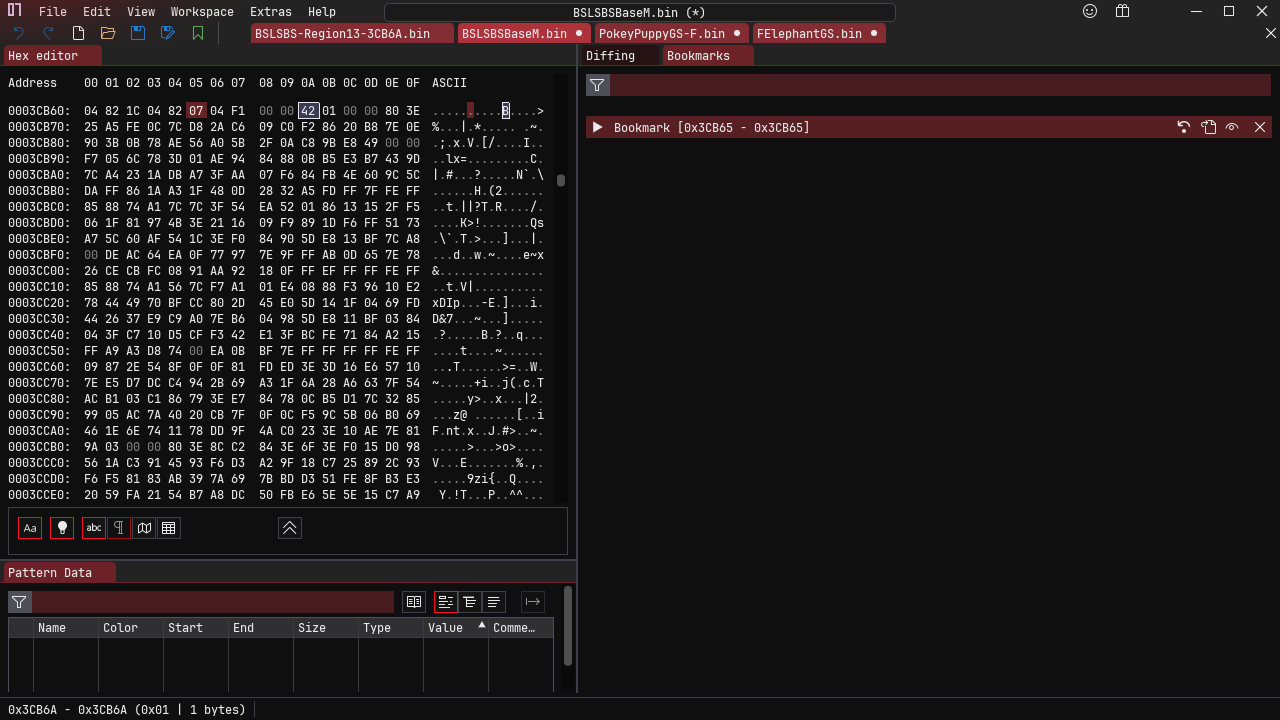
data/devlog/images/BinaryDiffs/Region-Segment-Comparison/BSLSBS-8556-highlight.PNG
