mtkimmins/LTSDM_hack/data/devlog/images/BinaryDiffs/Region-Segment-Comparison/Cricket-8556-diff.png

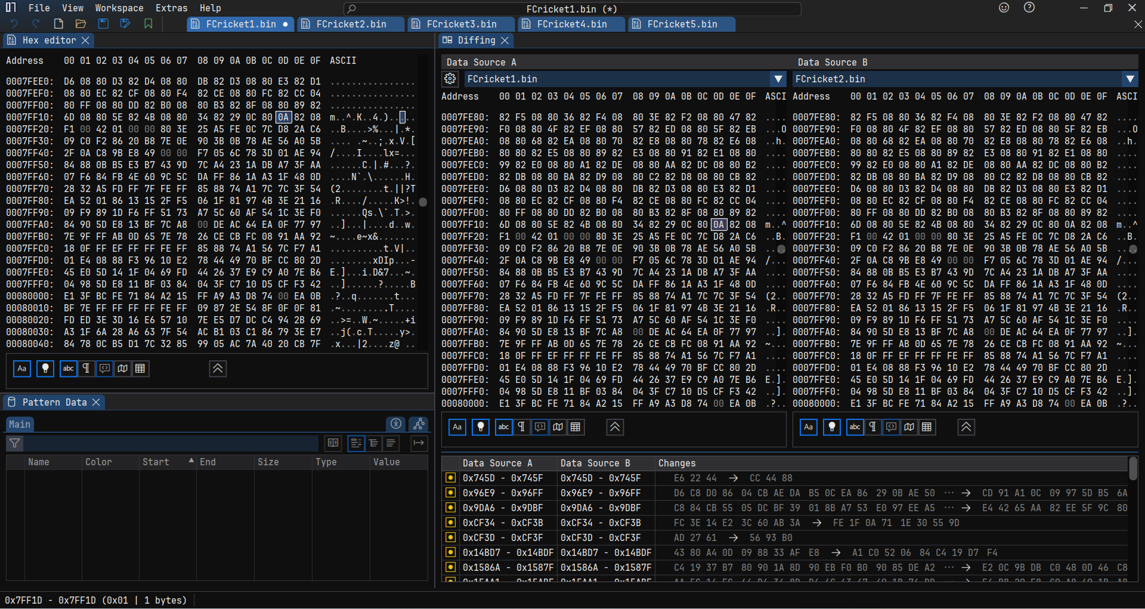
data/devlog/images/BinaryDiffs/Region-Segment-Comparison/Cricket-8556-diff.png
