mtkimmins/LTSDM_hack/data/devlog/images/BinaryDiffs/Region-Segment-Comparison/genera-PCM-body-comparisons.png

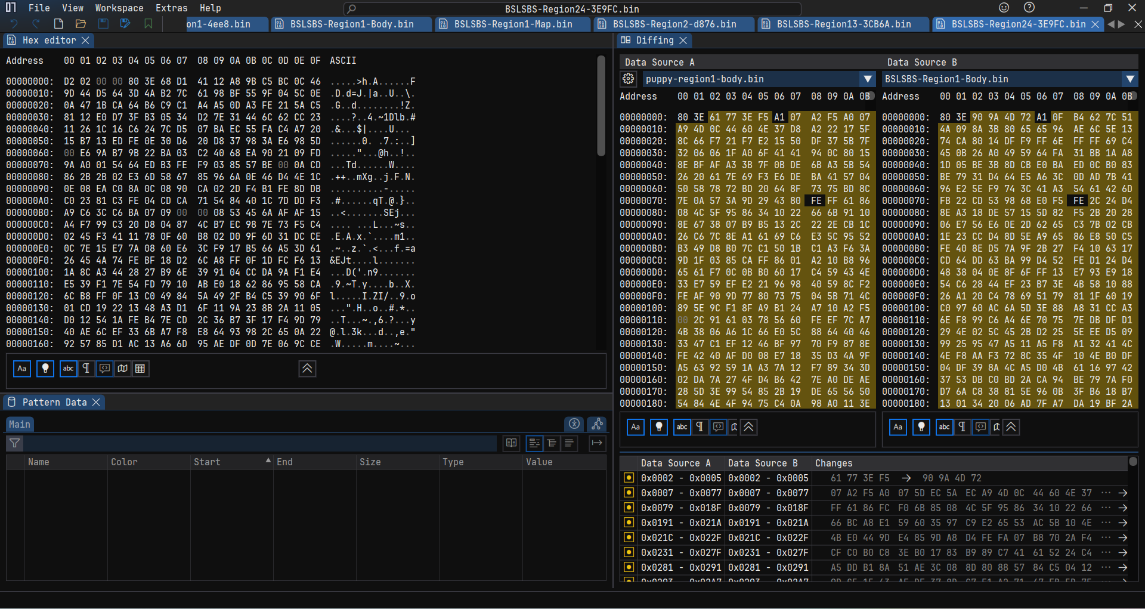
data/devlog/images/BinaryDiffs/Region-Segment-Comparison/genera-PCM-body-comparisons.png
