mtkimmins/LTSDM_hack/data/devlog/images/BinaryDiffs/Region-Segment-Comparison/Puppy-RAW-8556-diff.PNG

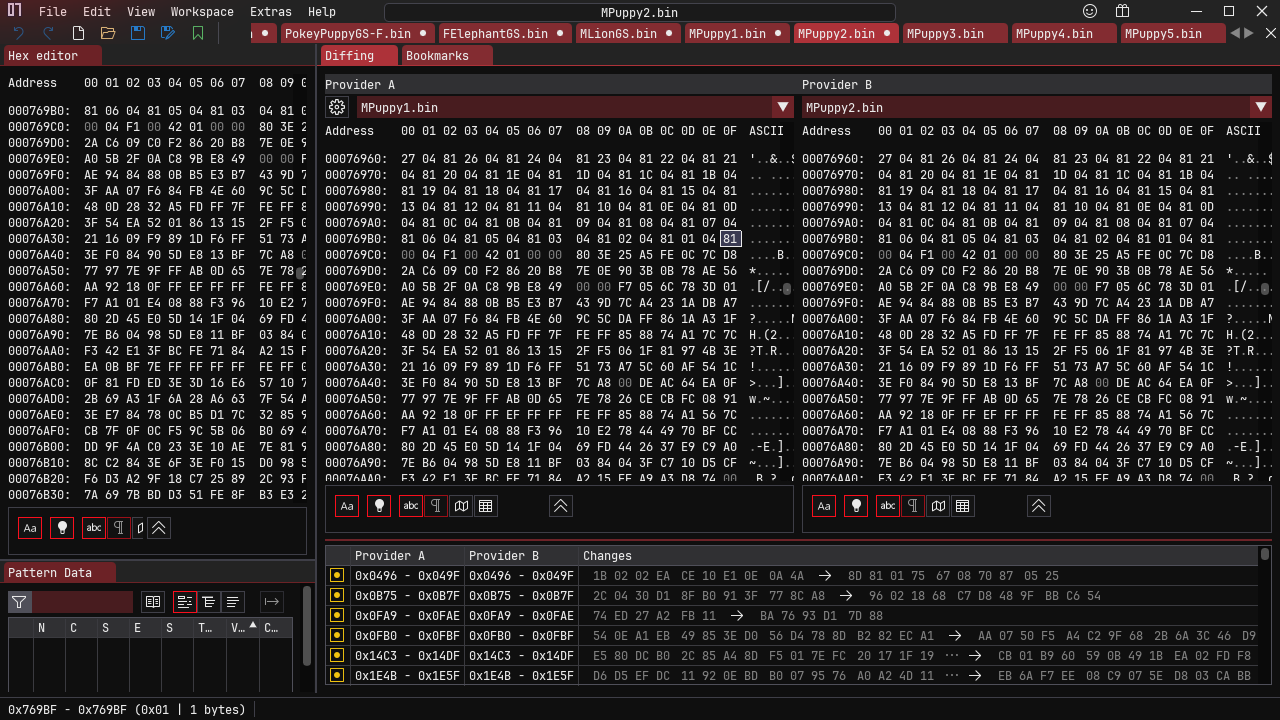
data/devlog/images/BinaryDiffs/Region-Segment-Comparison/Puppy-RAW-8556-diff.PNG
