mtkimmins/LTSDM_hack/data/devlog/images/Chips/11_back.JPG

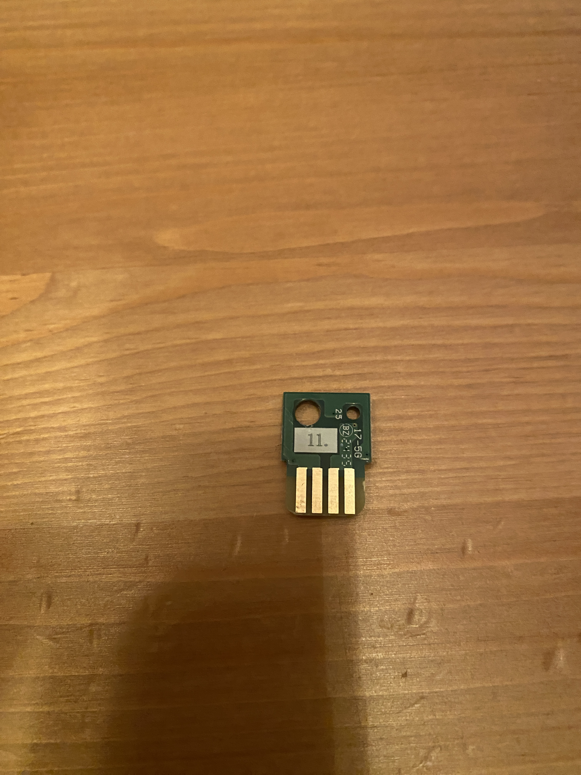
data/devlog/images/Chips/11_back.JPG
