mtkimmins/LTSDM_hack/data/devlog/images/Chips/11_front.JPG

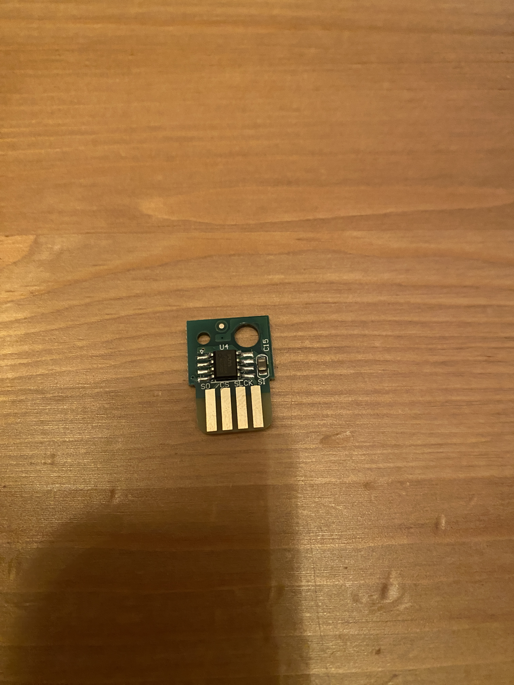
data/devlog/images/Chips/11_front.JPG
