mtkimmins/LTSDM_hack/data/devlog/images/Chips/12_back.JPG

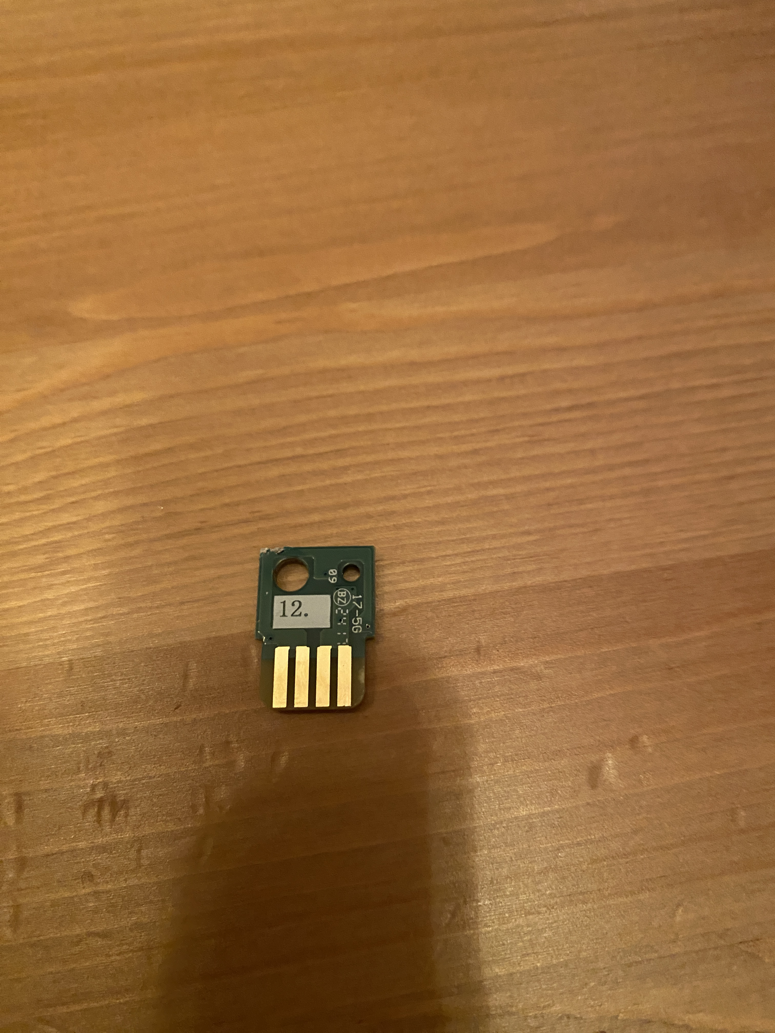
data/devlog/images/Chips/12_back.JPG
