mtkimmins/LTSDM_hack/data/devlog/images/Chips/12_front.JPG

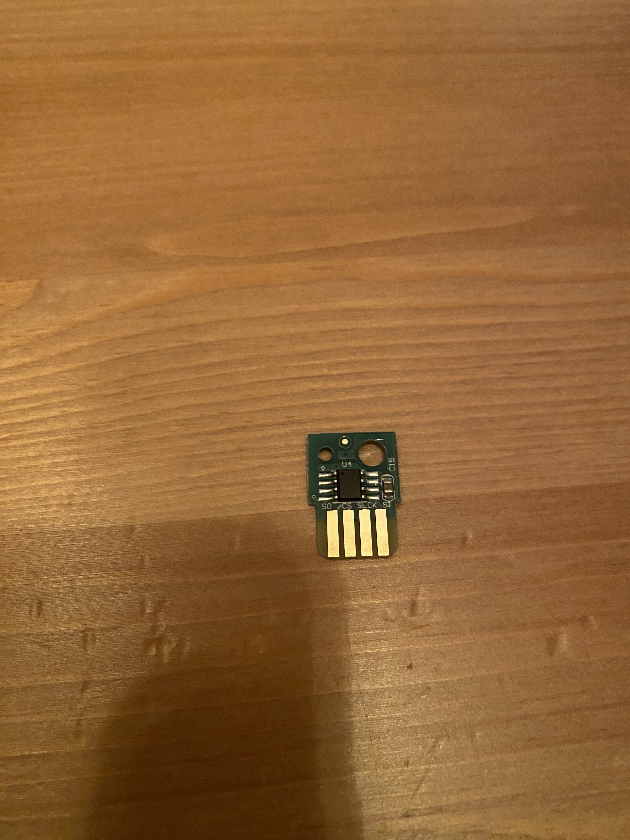
data/devlog/images/Chips/12_front.JPG
