mtkimmins/LTSDM_hack/data/devlog/images/Chips/projector_board_chips.JPG

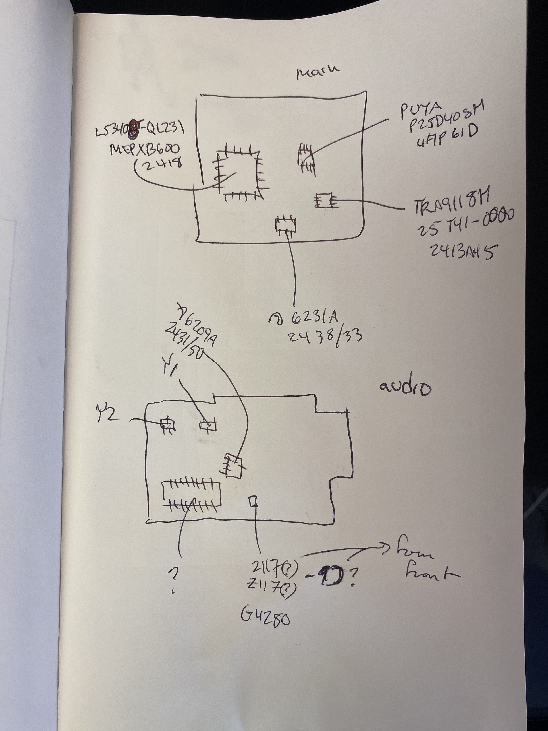
data/devlog/images/Chips/projector_board_chips.JPG
