mtkimmins/LTSDM_hack/data/devlog/images/compiler1.png

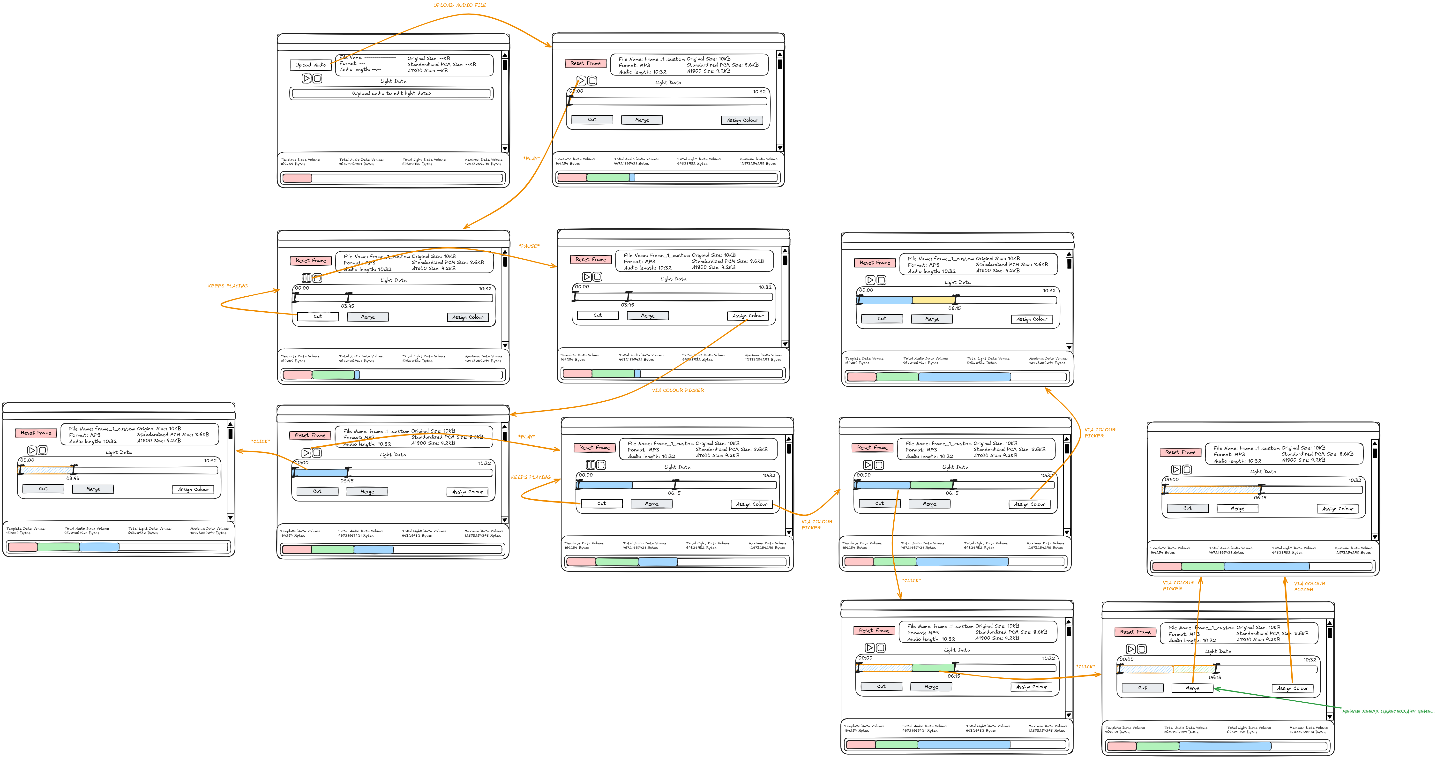
data/devlog/images/compiler1.png
