mtkimmins/LTSDM_hack/data/devlog/images/compiler2.png

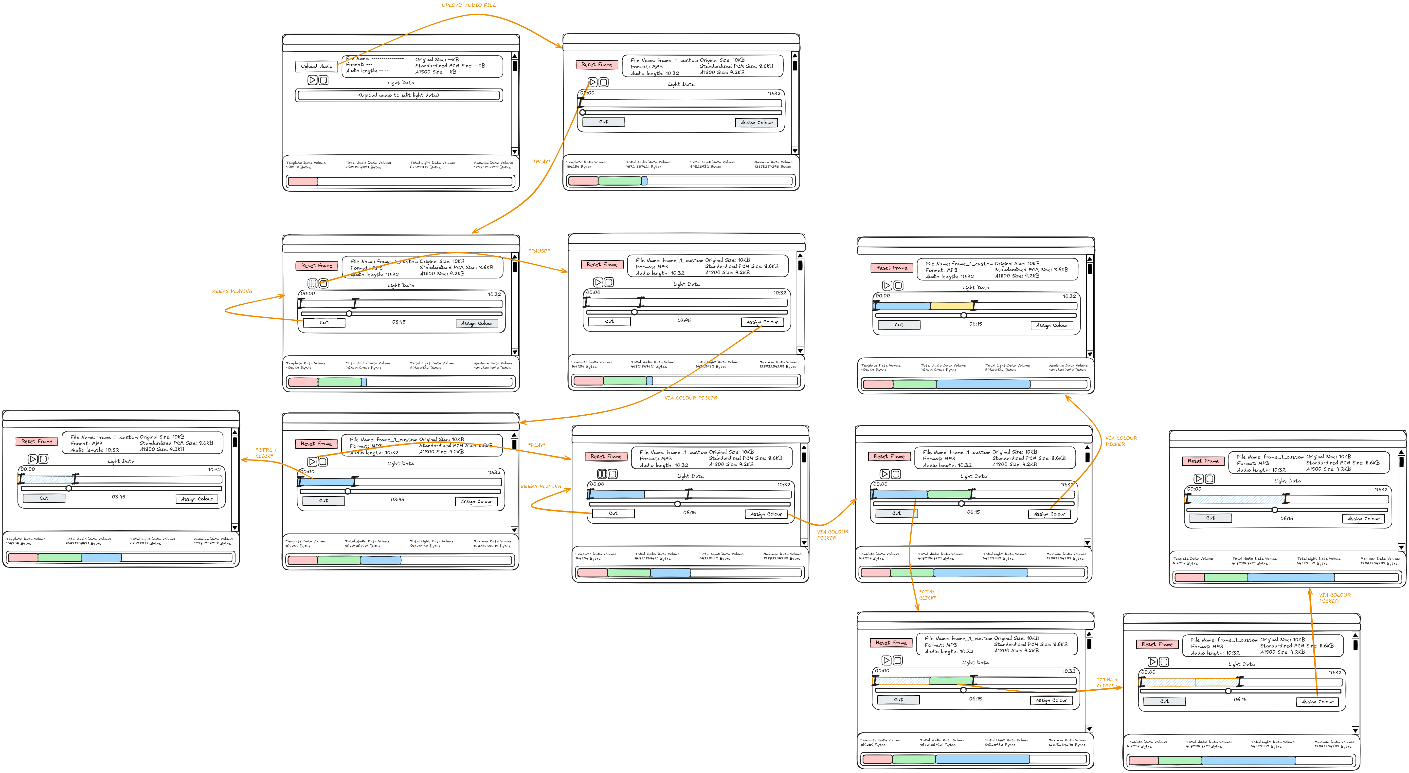
data/devlog/images/compiler2.png
