mtkimmins/LTSDM_hack/data/devlog/images/compiler5.png

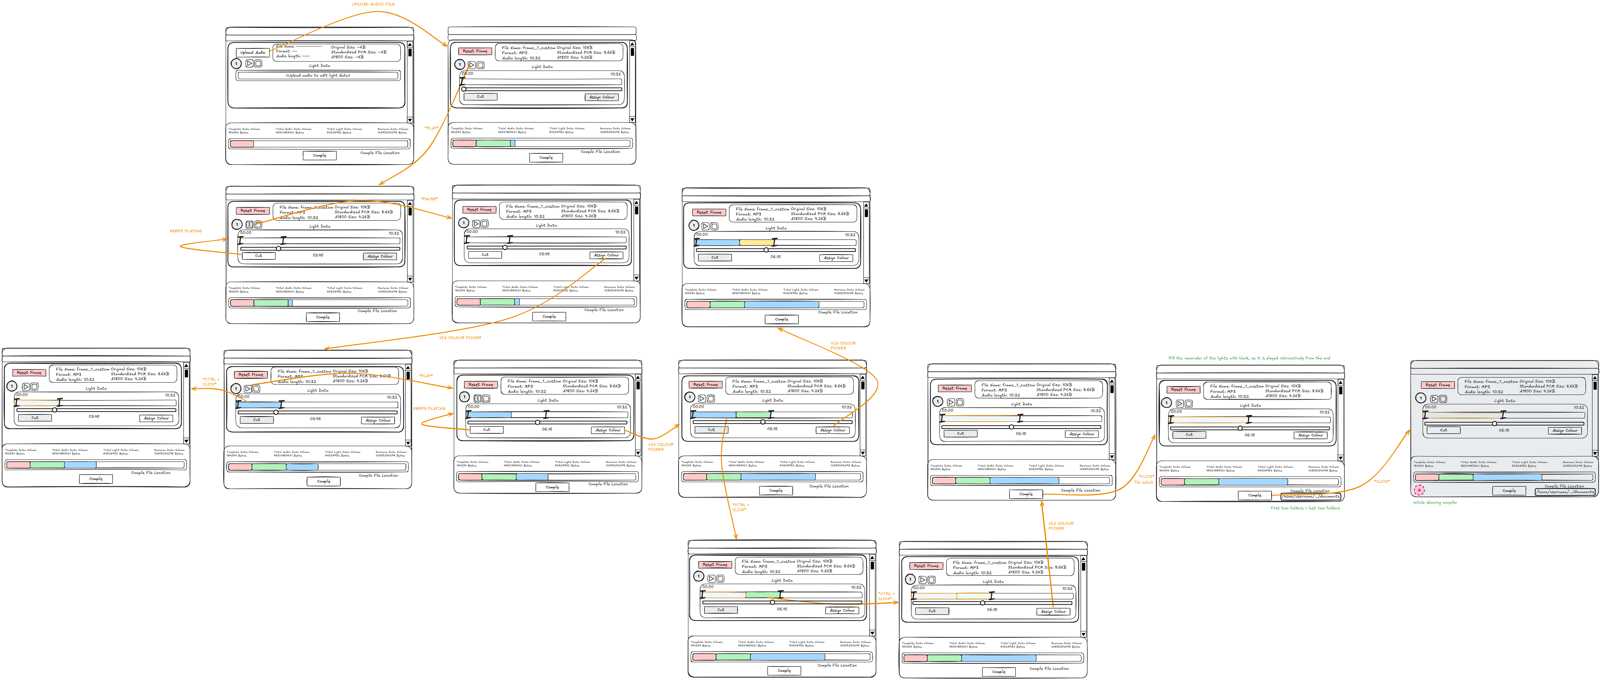
data/devlog/images/compiler5.png
