mtkimmins/LTSDM_hack/data/devlog/images/customPayload/re-dump diff.png

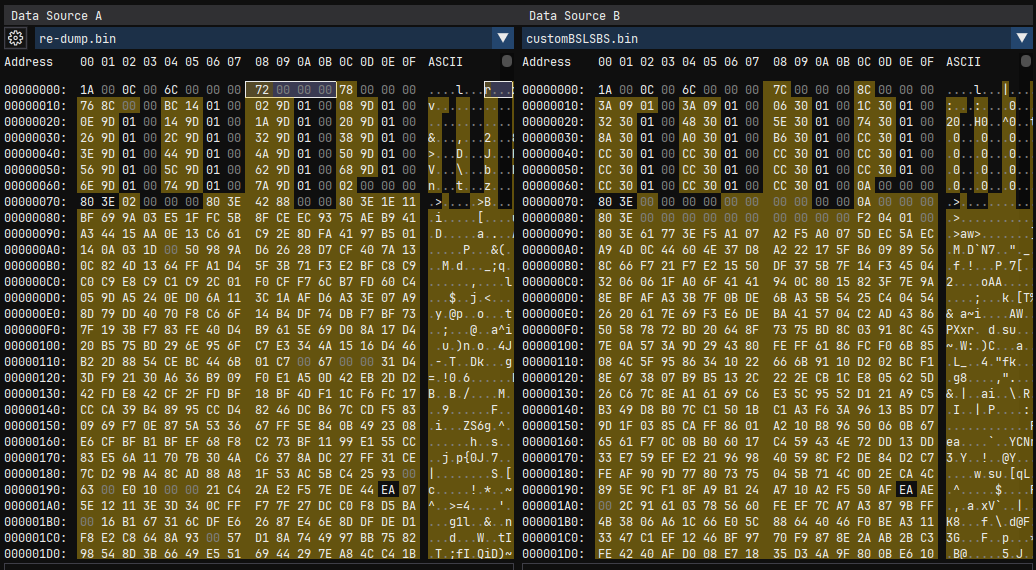
data/devlog/images/customPayload/re-dump diff.png
