mtkimmins/LTSDM_hack/data/devlog/images/encoding/first-encode.png

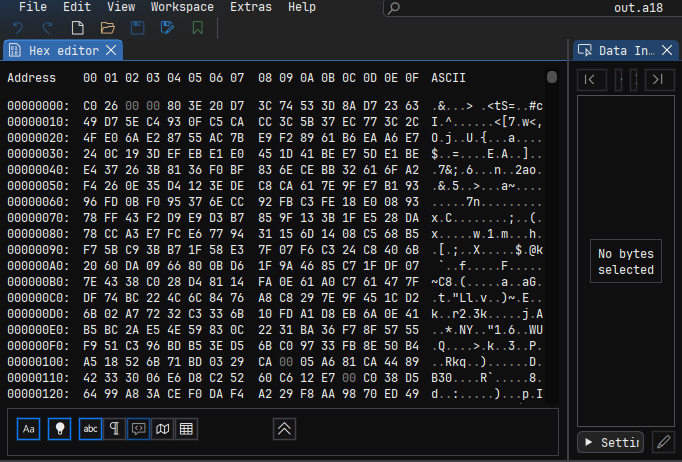
data/devlog/images/encoding/first-encode.png
