mtkimmins/LTSDM_hack/data/devlog/images/file structure map.PNG

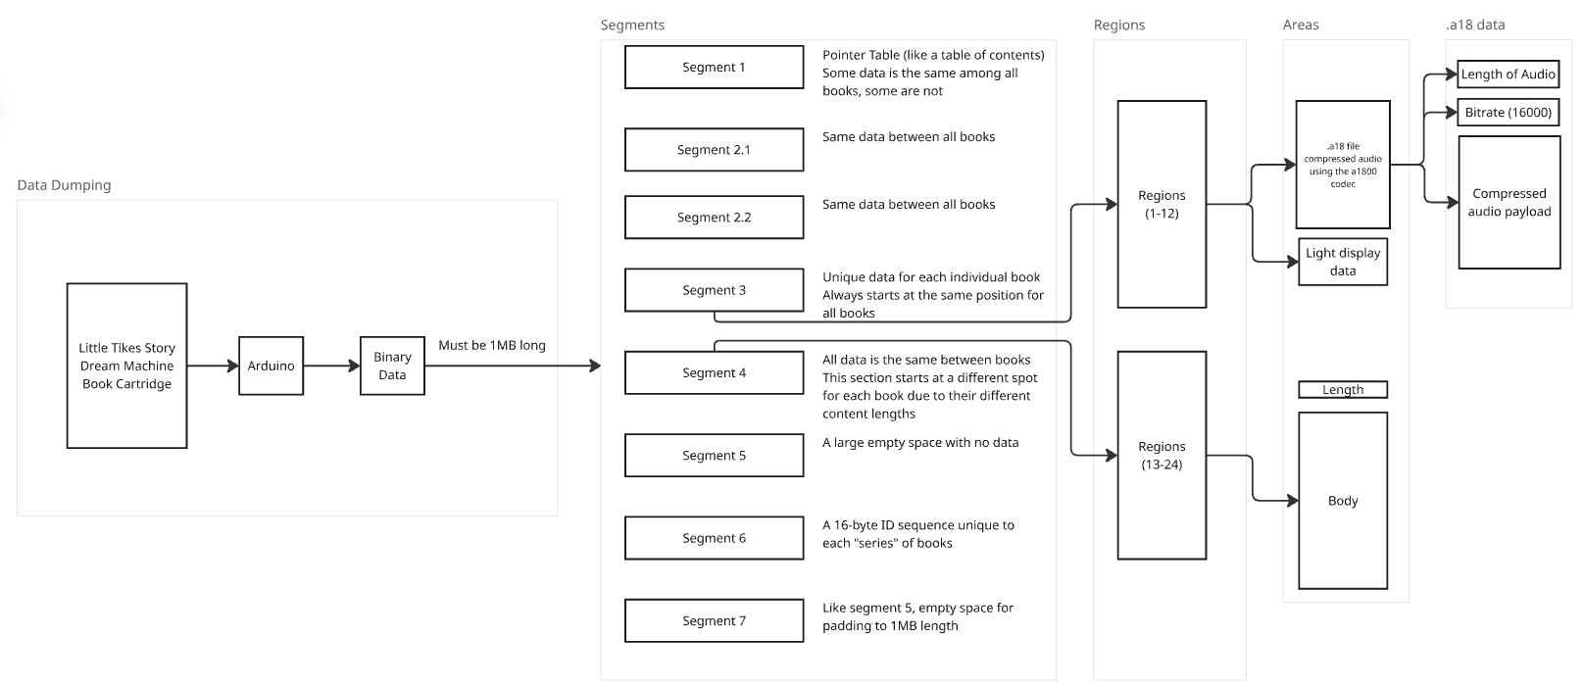
data/devlog/images/file structure map.PNG
