mtkimmins/LTSDM_hack/data/devlog/images/Ghidra-GPlus/initial_info.PNG

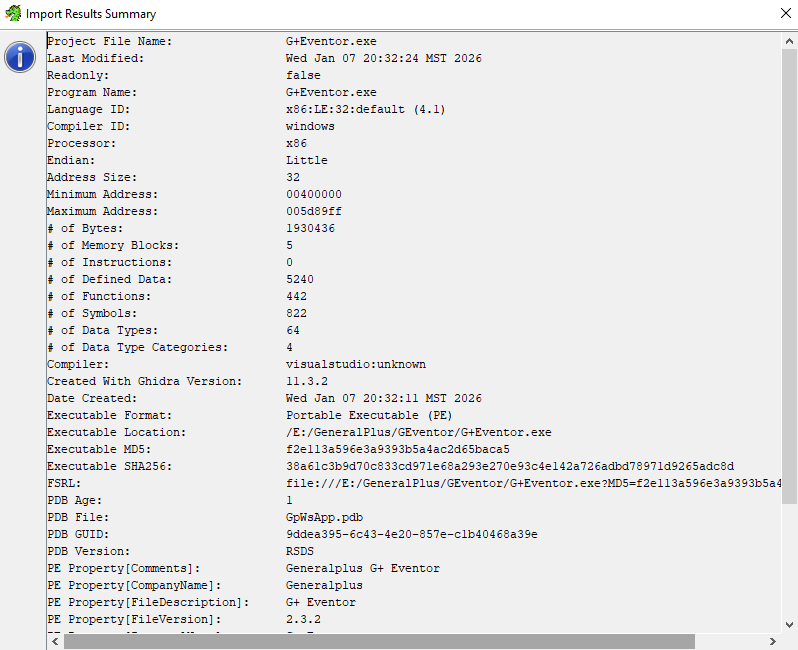
data/devlog/images/Ghidra-GPlus/initial_info.PNG
