mtkimmins/LTSDM_hack/data/devlog/images/GPlus-Exploration/G+batch-format-user-event-window.PNG

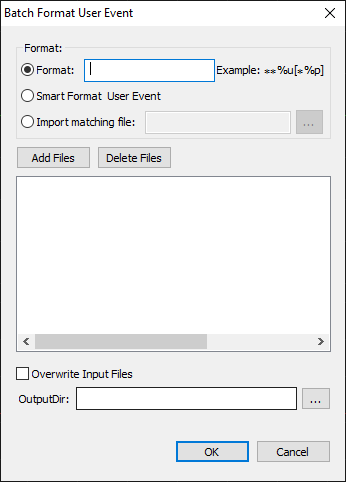
data/devlog/images/GPlus-Exploration/G+batch-format-user-event-window.PNG
