mtkimmins/LTSDM_hack/data/devlog/images/GPlus-Exploration/G+Eventor-simulation-interface.PNG

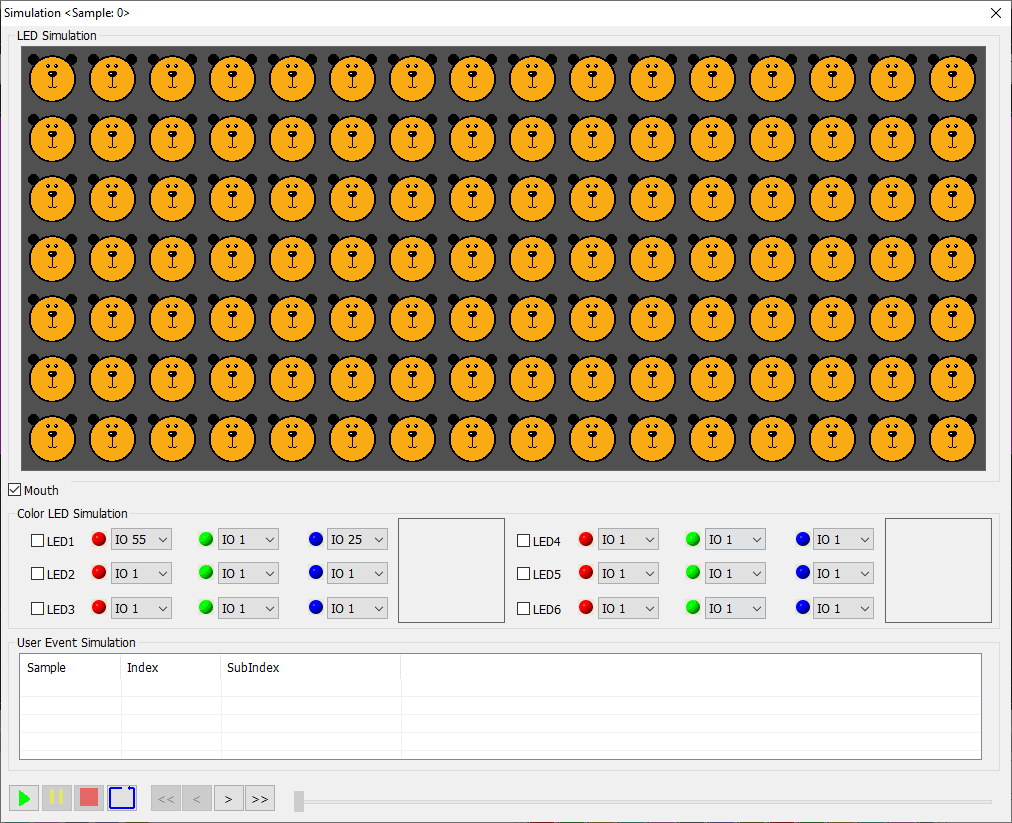
data/devlog/images/GPlus-Exploration/G+Eventor-simulation-interface.PNG
