mtkimmins/LTSDM_hack/data/devlog/images/Gplus.PNG

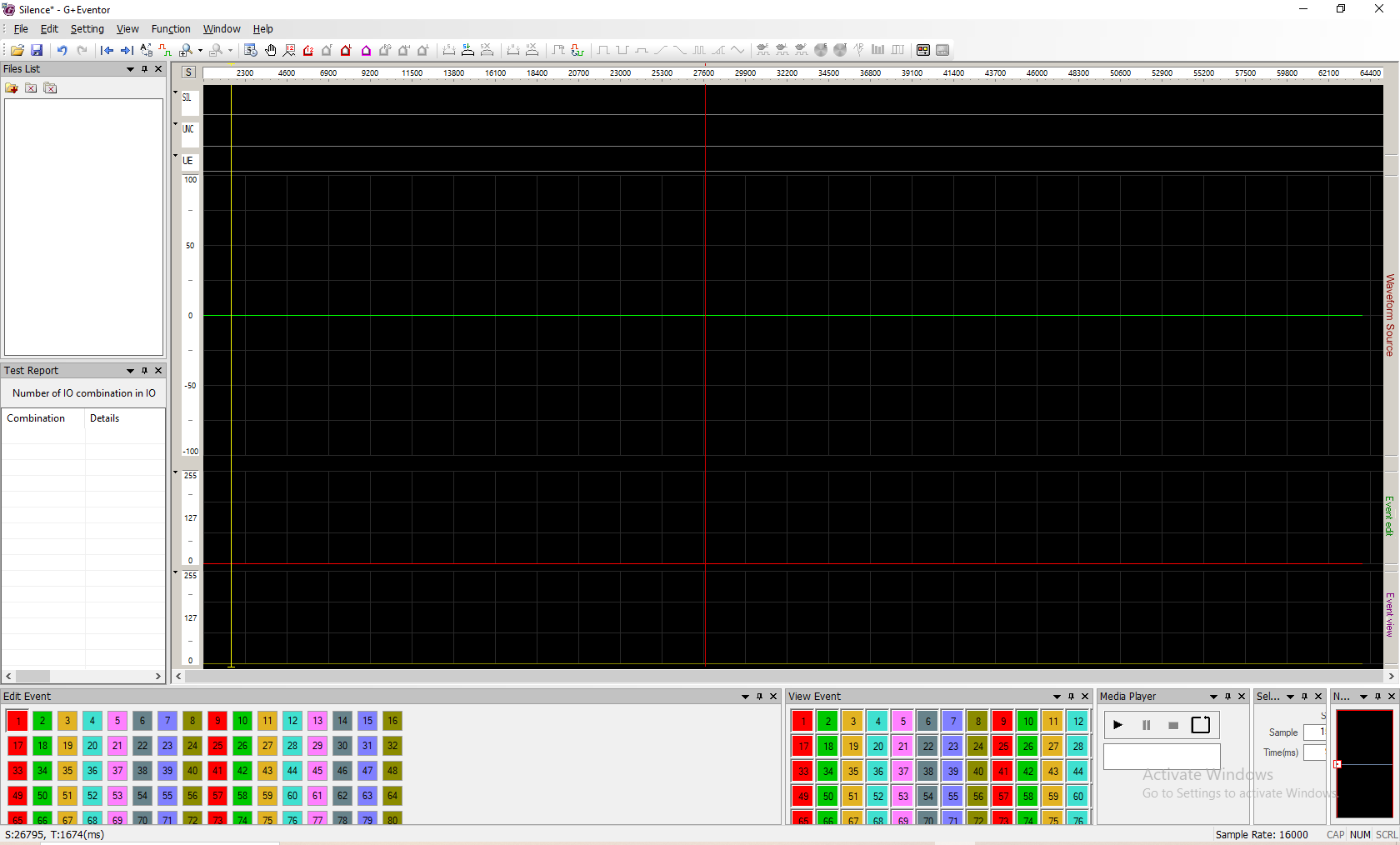
data/devlog/images/Gplus.PNG
