mtkimmins/LTSDM_hack/data/devlog/images/ImHex_screenshots/0880 pattern.PNG

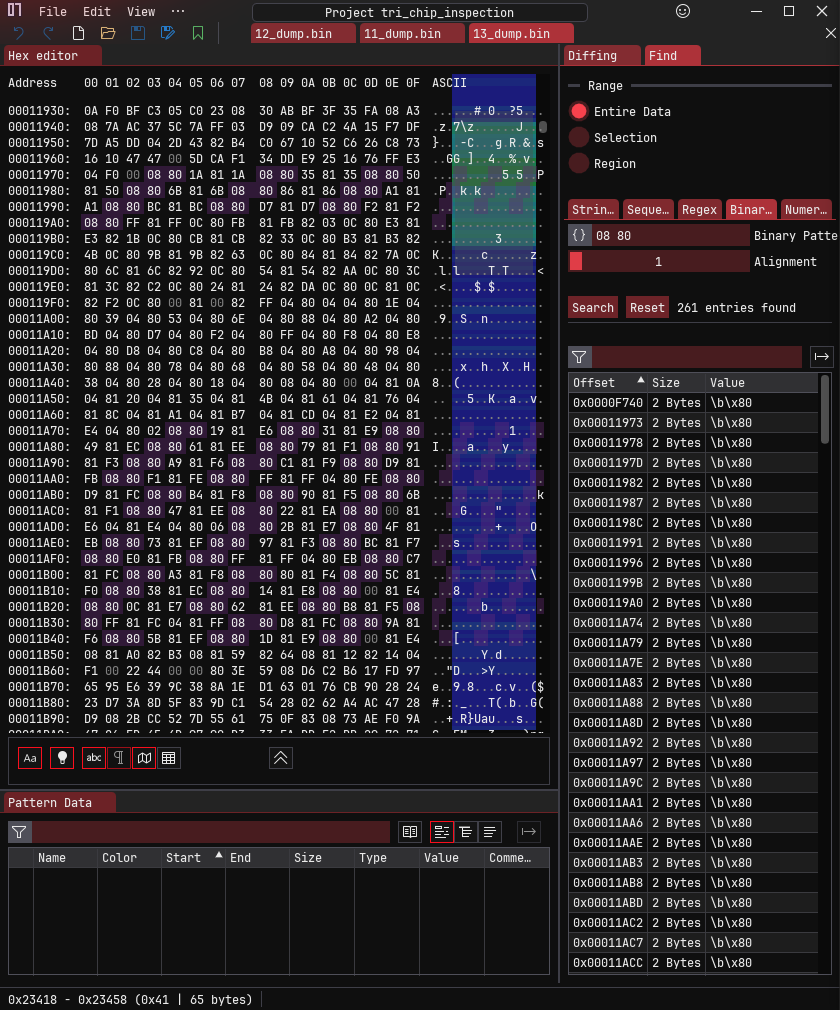
data/devlog/images/ImHex_screenshots/0880 pattern.PNG
