mtkimmins/LTSDM_hack/data/devlog/images/john-k-dreamsmith/fragmented-BSLSBS.png

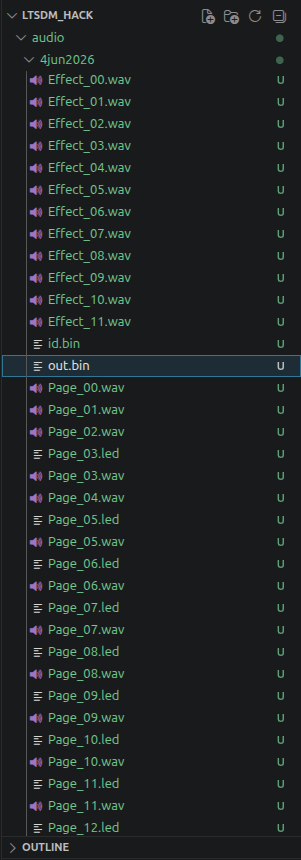
data/devlog/images/john-k-dreamsmith/fragmented-BSLSBS.png
