mtkimmins/LTSDM_hack/data/devlog/images/john-k-dreamsmith/terminal-logs-Segment1.png

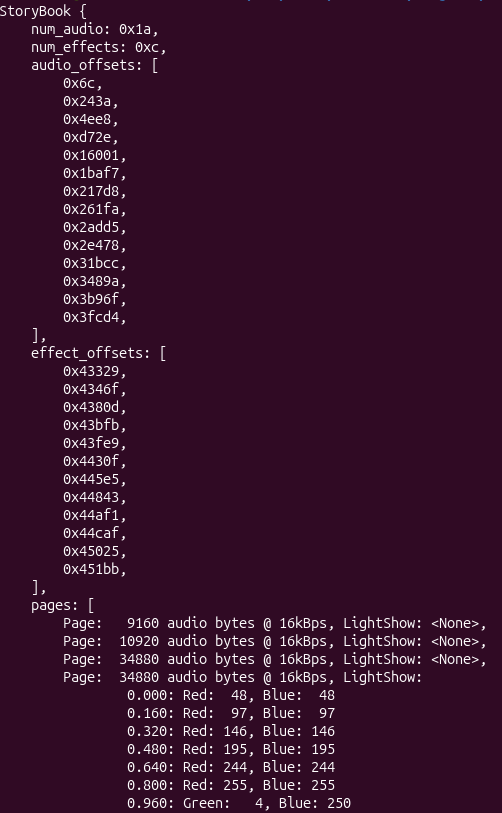
data/devlog/images/john-k-dreamsmith/terminal-logs-Segment1.png
