mtkimmins/LTSDM_hack/data/devlog/images/john-k-dreamsmith/terminal-logs-Segment3.png

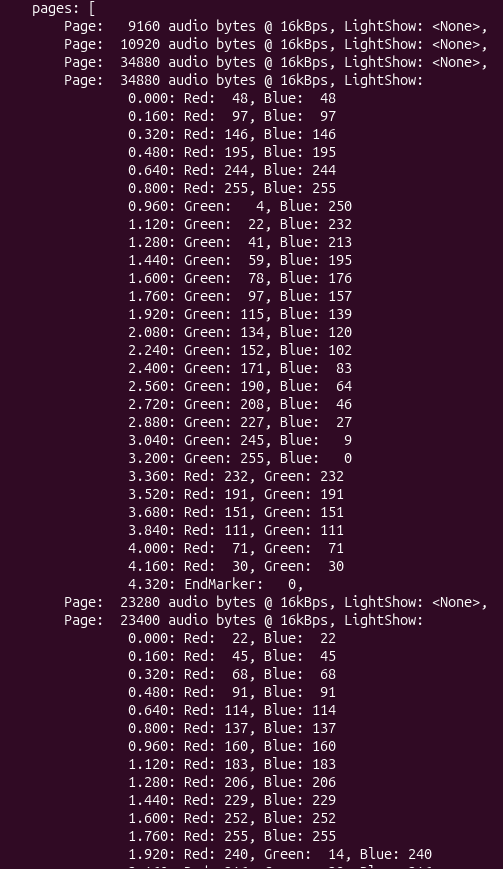
data/devlog/images/john-k-dreamsmith/terminal-logs-Segment3.png
