mtkimmins/LTSDM_hack/data/devlog/images/knowledge-base/BSLSBS-initial-region1.PNG

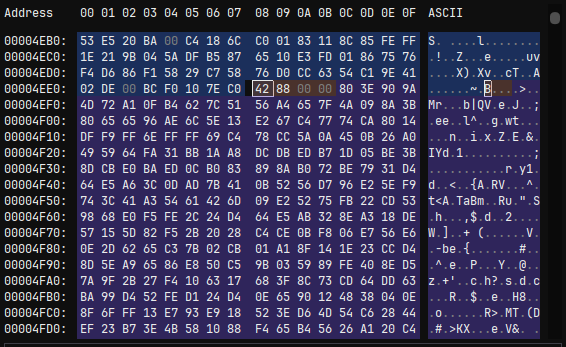
data/devlog/images/knowledge-base/BSLSBS-initial-region1.PNG
