mtkimmins/LTSDM_hack/data/devlog/images/Roadmap.png

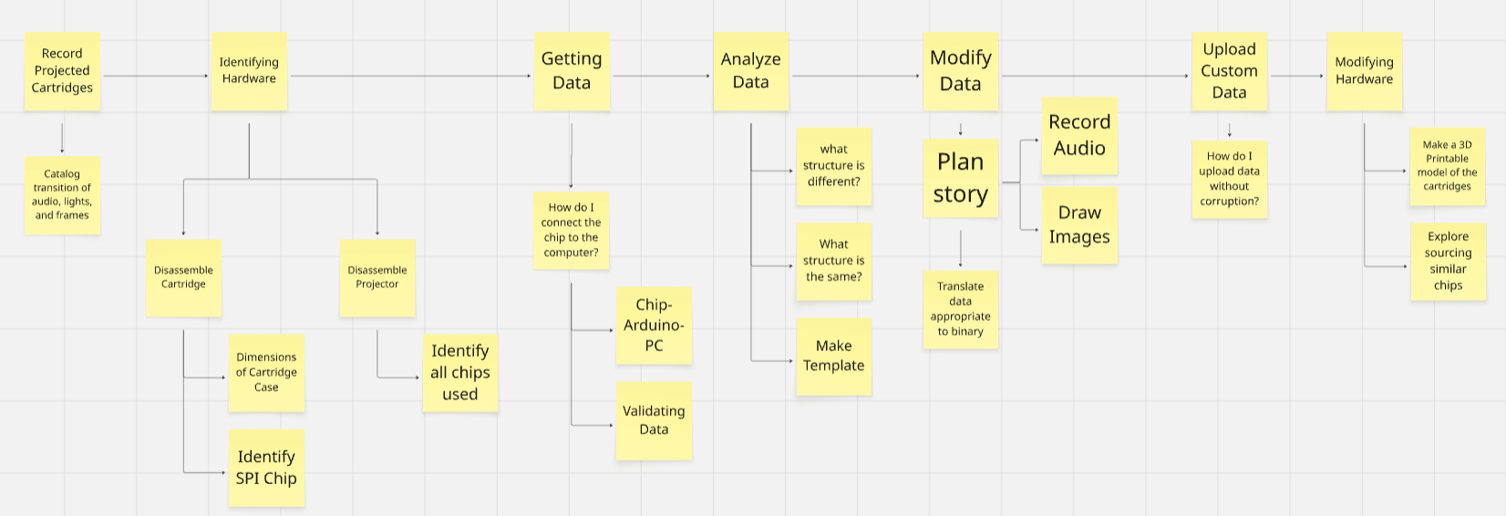
data/devlog/images/Roadmap.png
