mtkimmins/LTSDM_hack/data/devlog/images/shield/arduino-header-pins.JPG

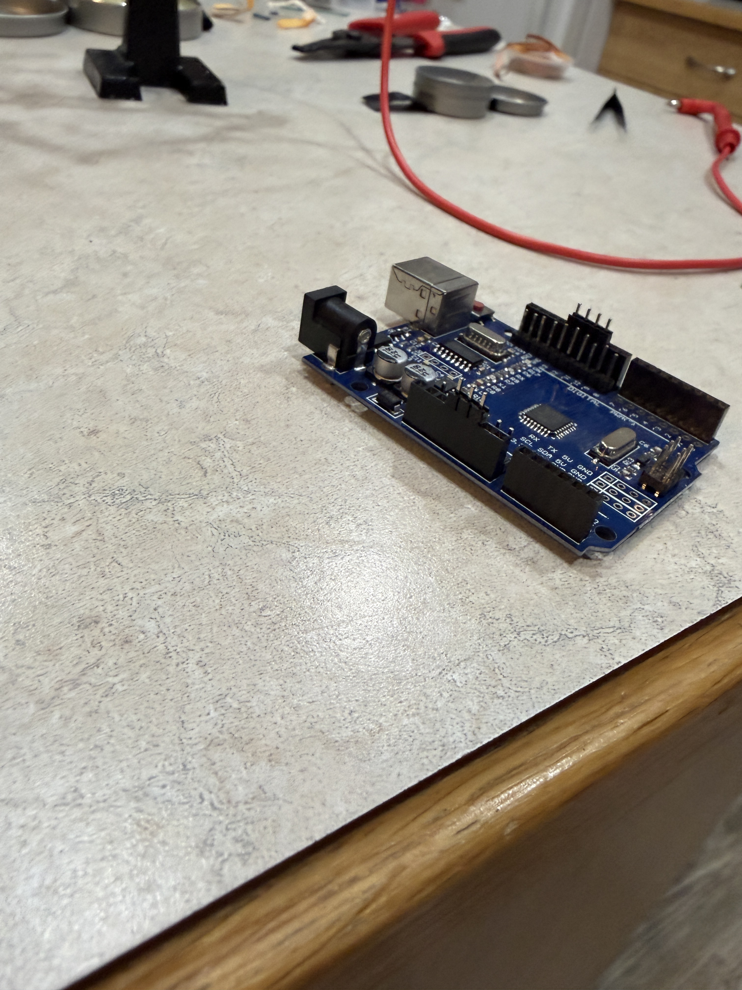
data/devlog/images/shield/arduino-header-pins.JPG
