mtkimmins/LTSDM_hack/data/devlog/images/shield/arduino-headers-proto.JPG

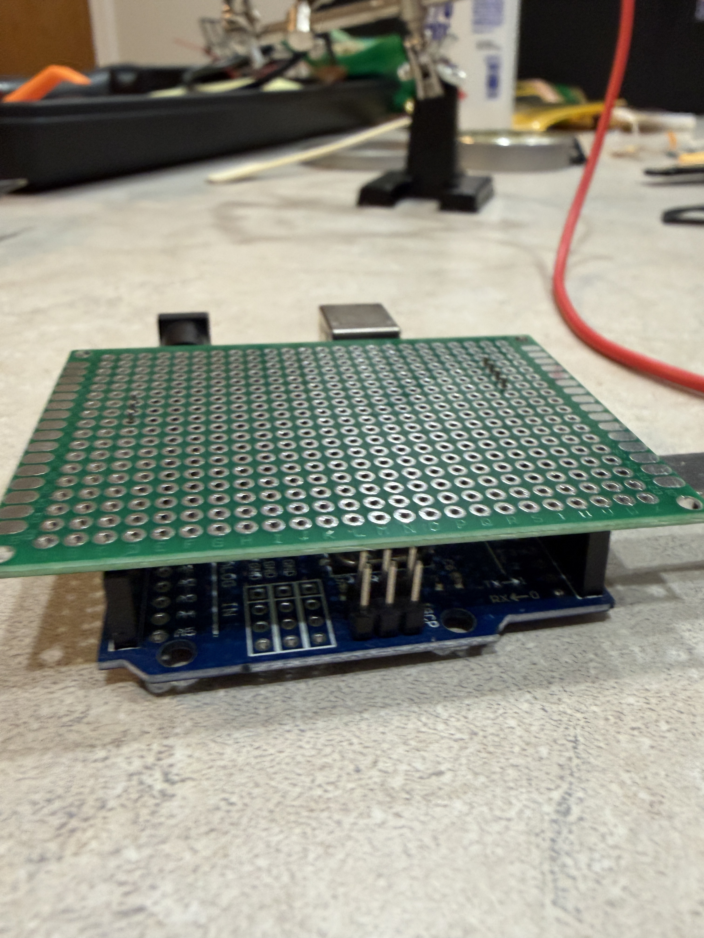
data/devlog/images/shield/arduino-headers-proto.JPG
