mtkimmins/LTSDM_hack/data/devlog/images/shield/arduino.JPG

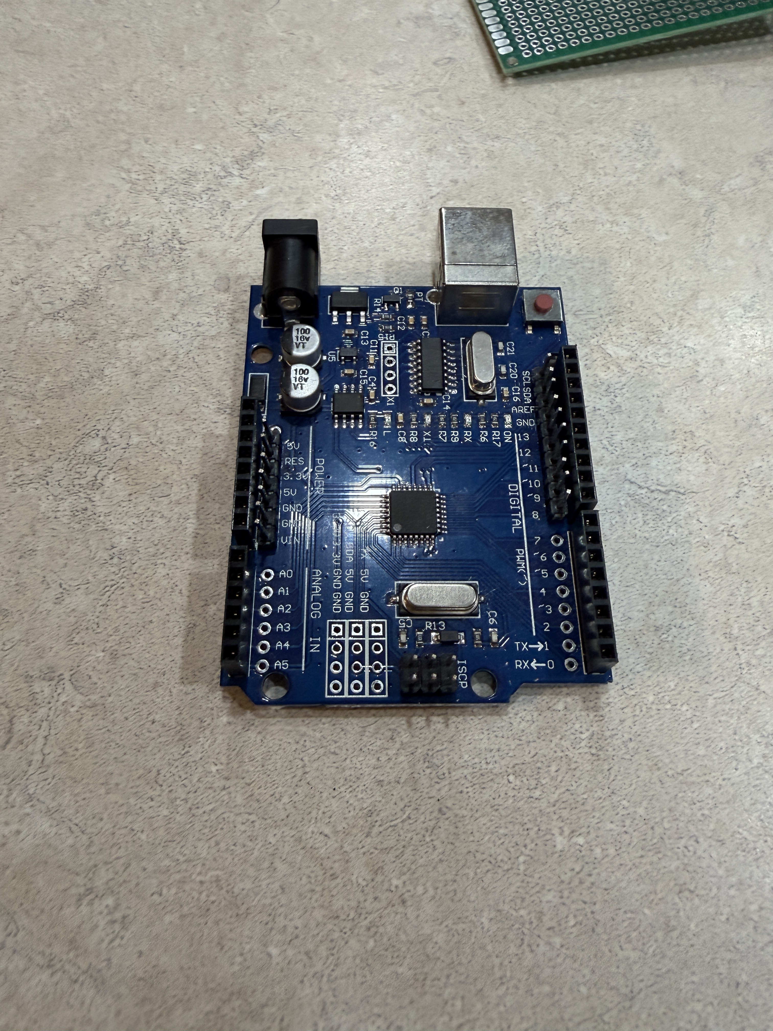
data/devlog/images/shield/arduino.JPG
