mtkimmins/LTSDM_hack/data/devlog/images/shield/headers-socket-bottom.JPG

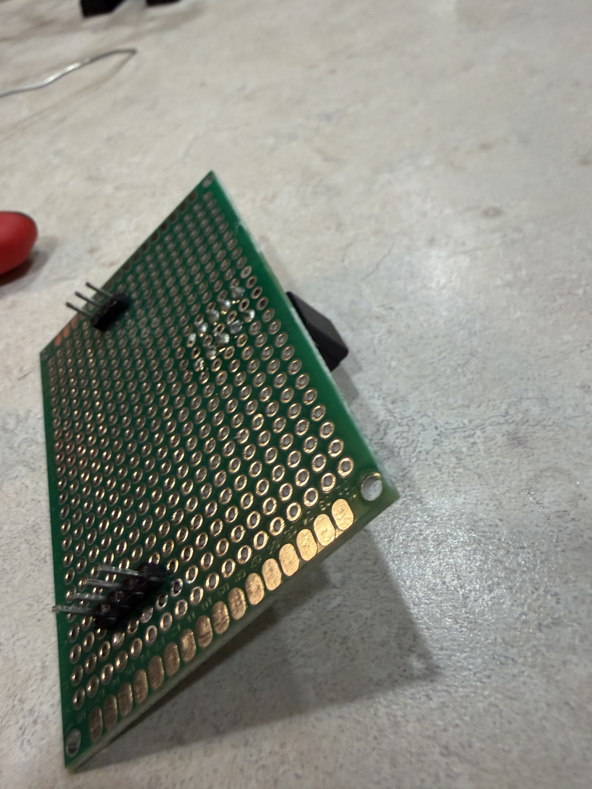
data/devlog/images/shield/headers-socket-bottom.JPG
