mtkimmins/LTSDM_hack/(commit log)

2025-06-24 Update structure + .bins
    [DiffSheet.xlsx]
2025-11-25 Update documentation with tie-breaker suggestion
    Added a suggestion for tie-breaker samples in the To Do section.
2026-07-07 + double gnd
2026-07-09 soldered pics
2026-07-09 -soldered socket
2026-08-28 isolated crash frame
2026-09-26 Update physical specs with carousel and film details
    Added detailed specifications for carousel and film components, including dimensions and notes on mounting and alignment.
