mtkimmins/LTSDM_hack/Images/WiringSetup/official-guide/cartridge-socket.JPG

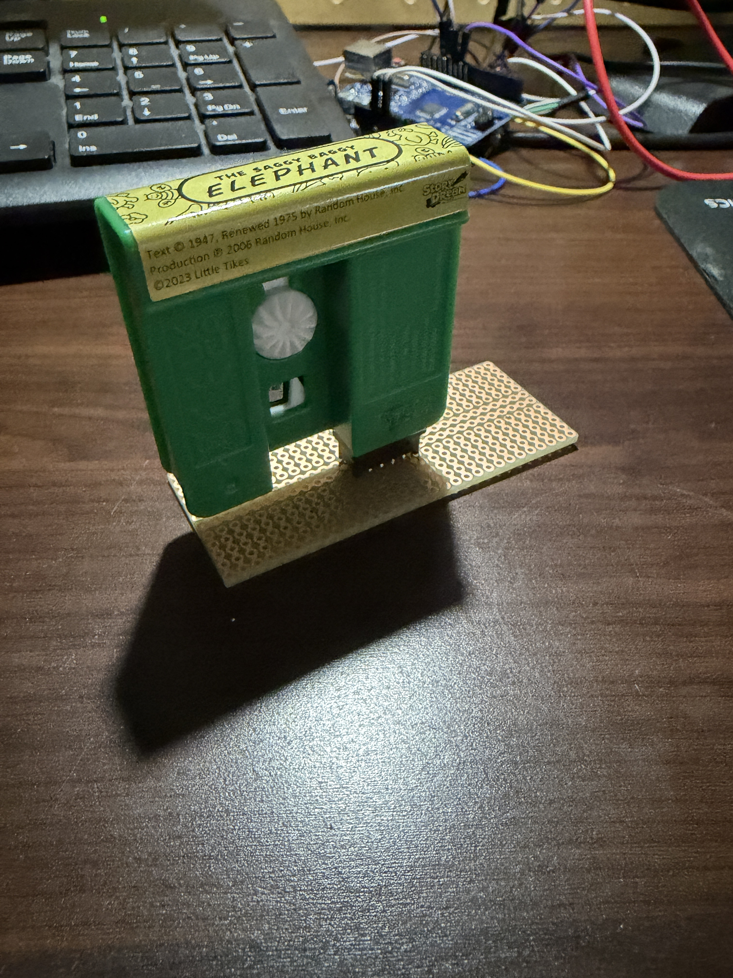
[picture p6: Images/WiringSetup/official-guide/cartridge-socket.JPG]
Images/WiringSetup/official-guide/cartridge-socket.JPG
