mtkimmins/LTSDM_hack/Images/shield/soldering/divider-wires.jpg

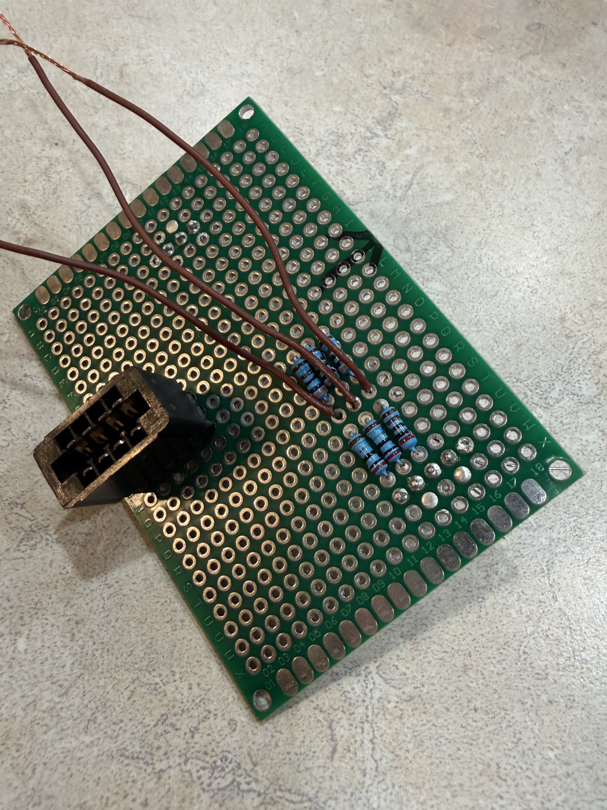
[picture p7: Images/shield/soldering/divider-wires.jpg]
Images/shield/soldering/divider-wires.jpg
