mtkimmins/LTSDM_hack/Images/shield/final/final.jpg

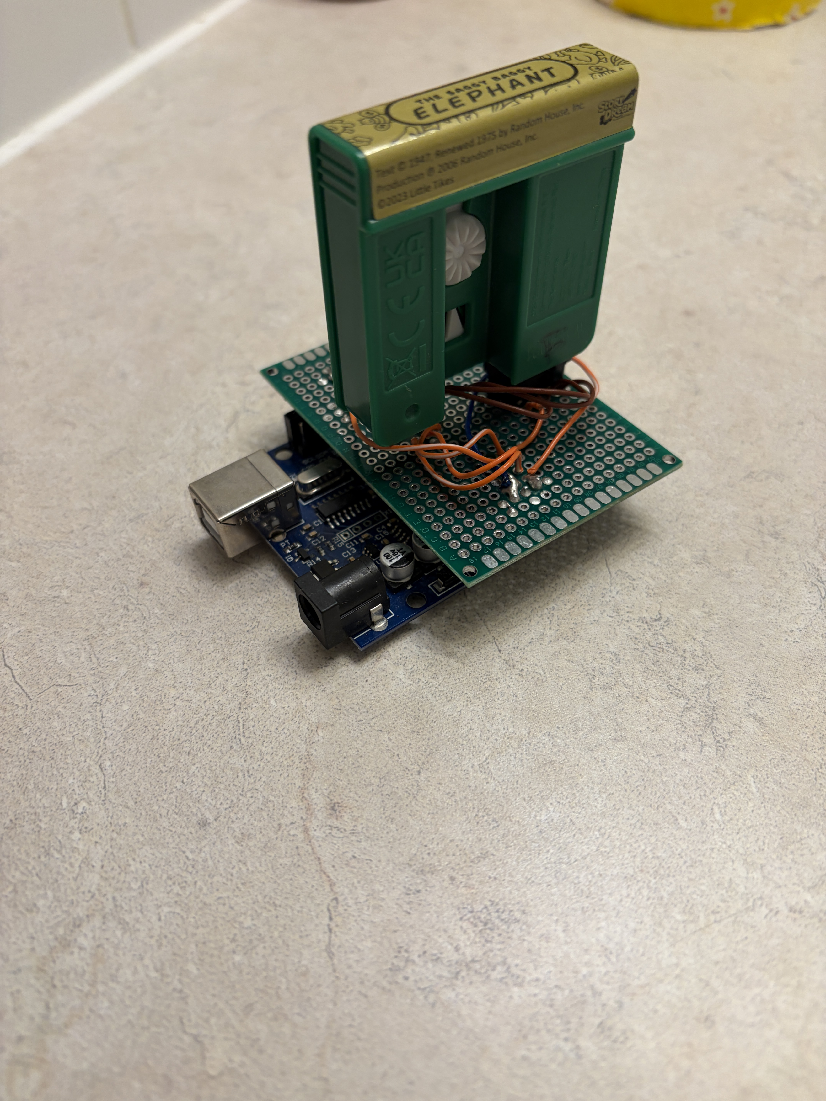
[picture p10: Images/shield/final/final.jpg]
Images/shield/final/final.jpg
