mtkimmins/LTSDM_hack/data/devlog/images/BoxInformation/Back of Box.JPG

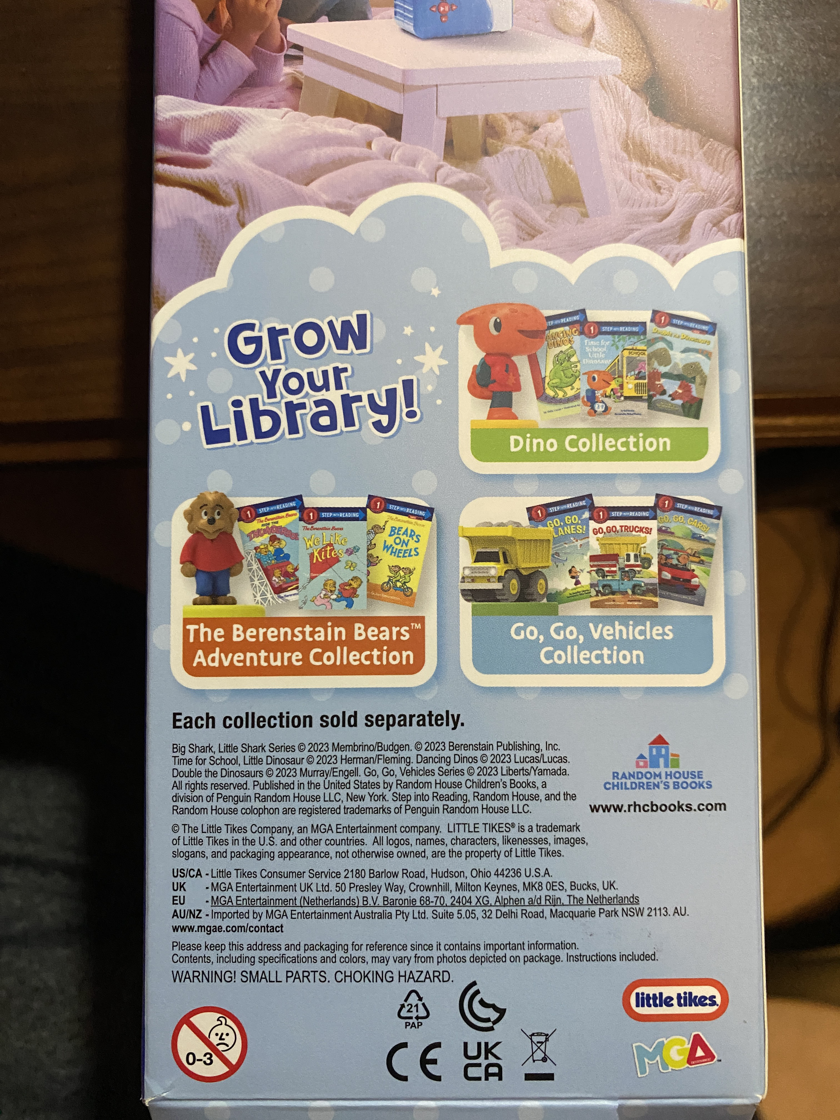
data/devlog/images/BoxInformation/Back of Box.JPG
