mtkimmins/LTSDM_hack/data/devlog/images/shield/insert-socket.JPG

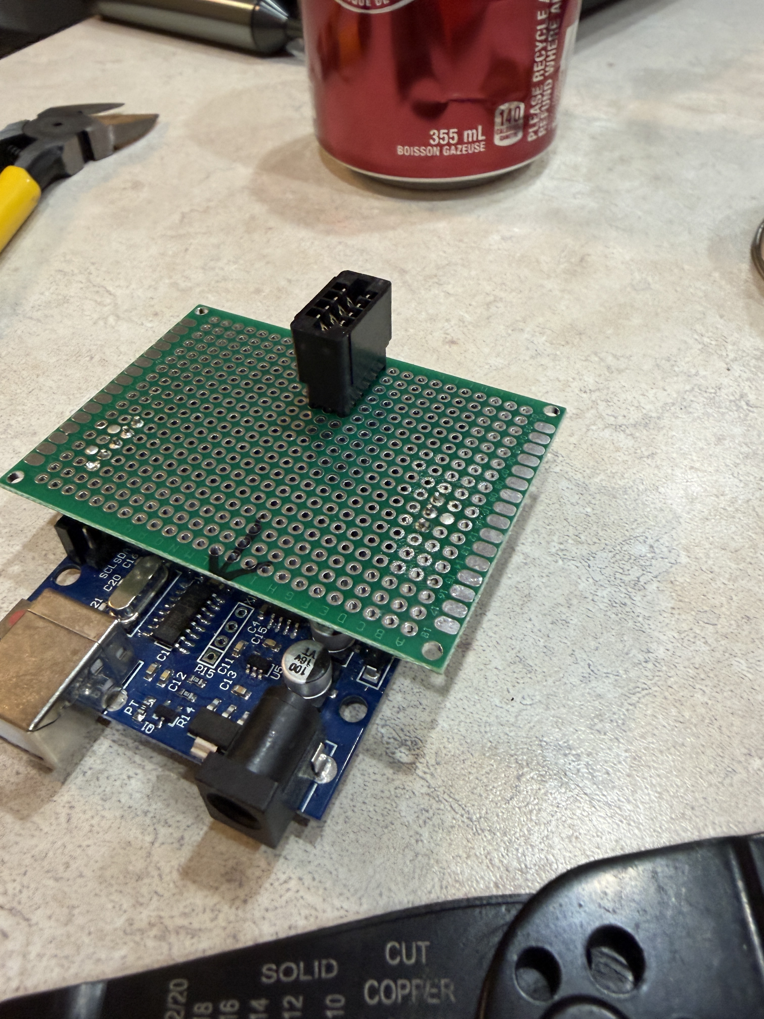
data/devlog/images/shield/insert-socket.JPG
