mtkimmins/LTSDM_hack/data/devlog/images/shield/protoboard-lengthwise.JPG

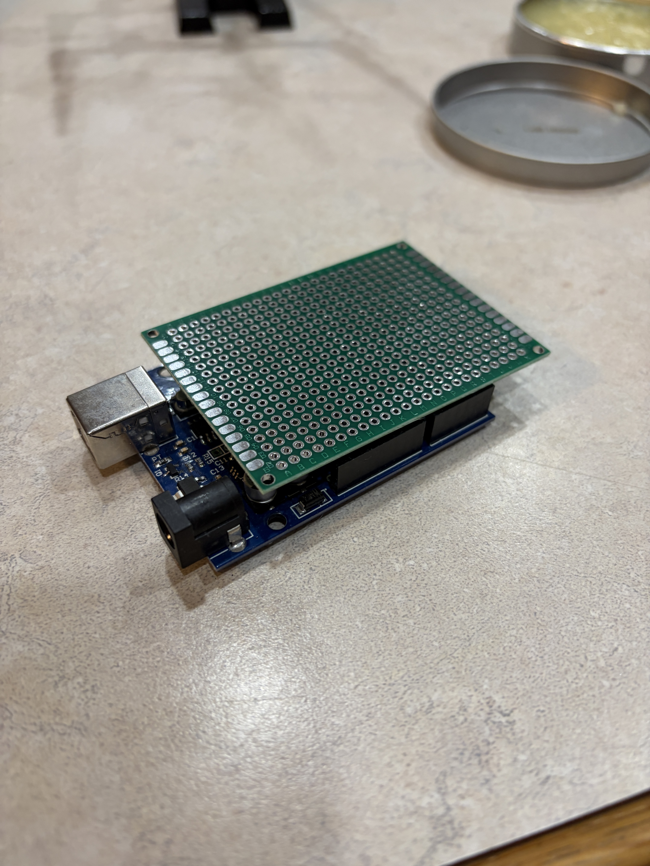
data/devlog/images/shield/protoboard-lengthwise.JPG
