mtkimmins/LTSDM_hack/data/devlog/images/shield/protoboard-widthwise.JPG

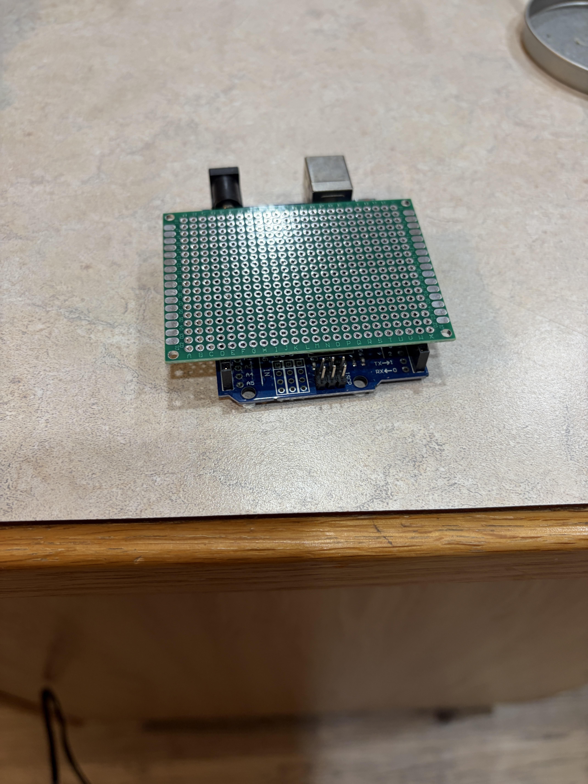
data/devlog/images/shield/protoboard-widthwise.JPG
