mtkimmins/LTSDM_hack/data/devlog/images/SOIC8Clip/Clip1.JPG

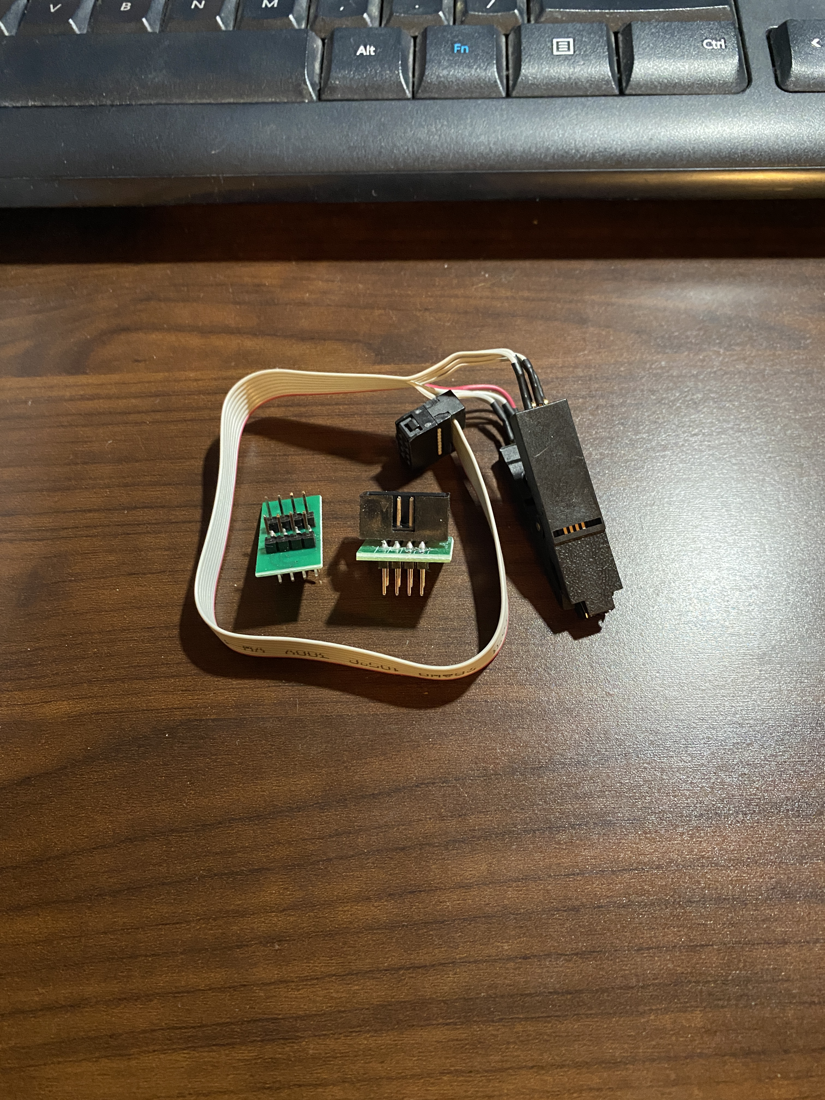
data/devlog/images/SOIC8Clip/Clip1.JPG
