mtkimmins/LTSDM_hack/data/devlog/images/SOIC8Clip/Clip2.JPG

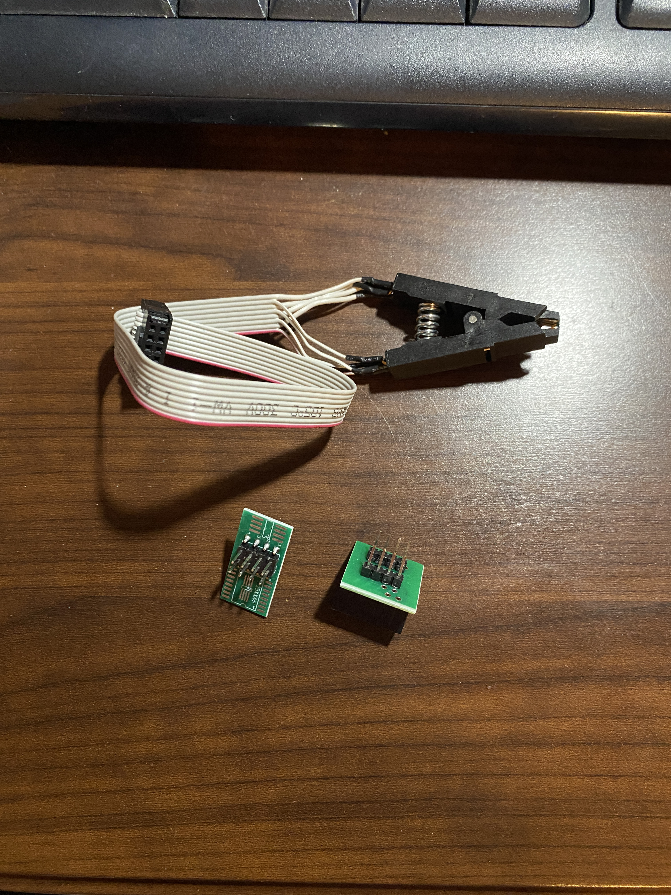
data/devlog/images/SOIC8Clip/Clip2.JPG
