mtkimmins/LTSDM_hack/data/devlog/images/BoxInformation/Manual Warranty.JPG

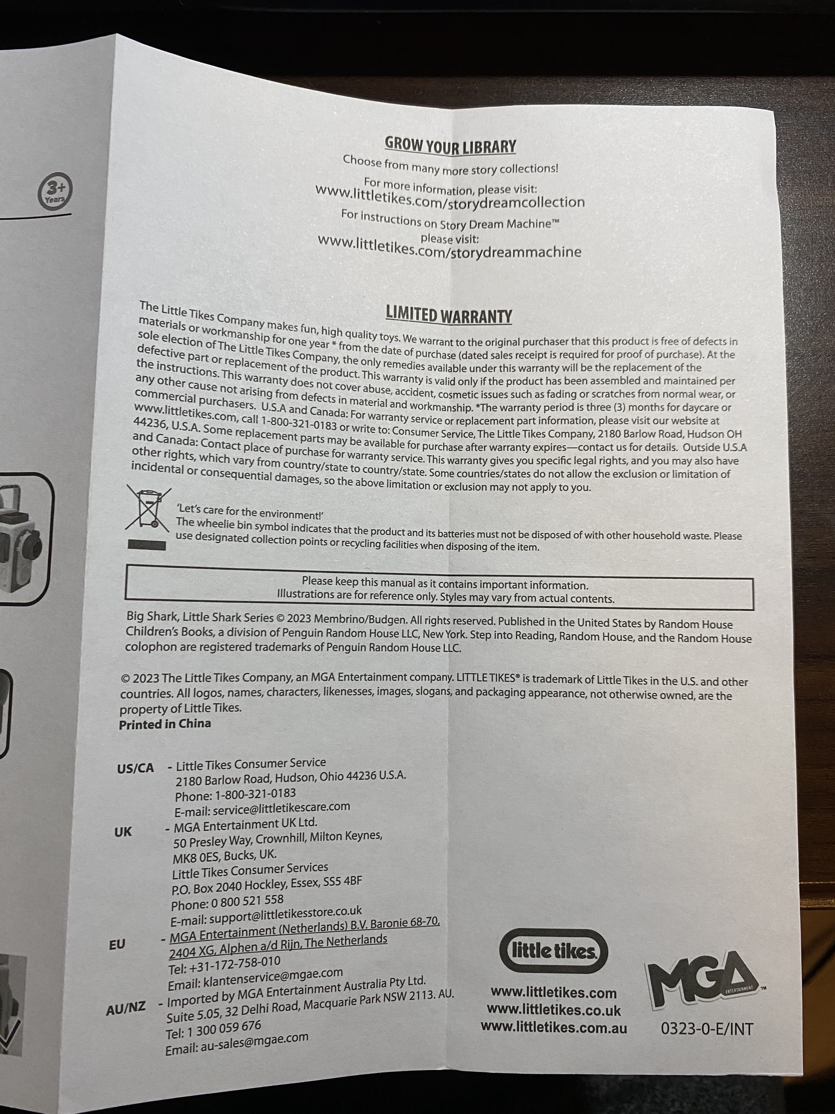
data/devlog/images/BoxInformation/Manual Warranty.JPG
