mtkimmins/LTSDM_hack/data/devlog/images/CartridgeDissassembly/internal_casing1.JPG

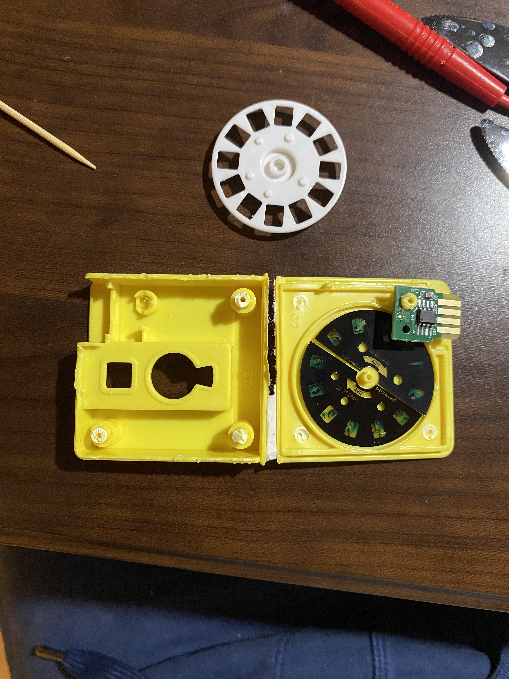
data/devlog/images/CartridgeDissassembly/internal_casing1.JPG
