mtkimmins/LTSDM_hack/data/devlog/images/CartridgeDissassembly/internal_casing2.JPG

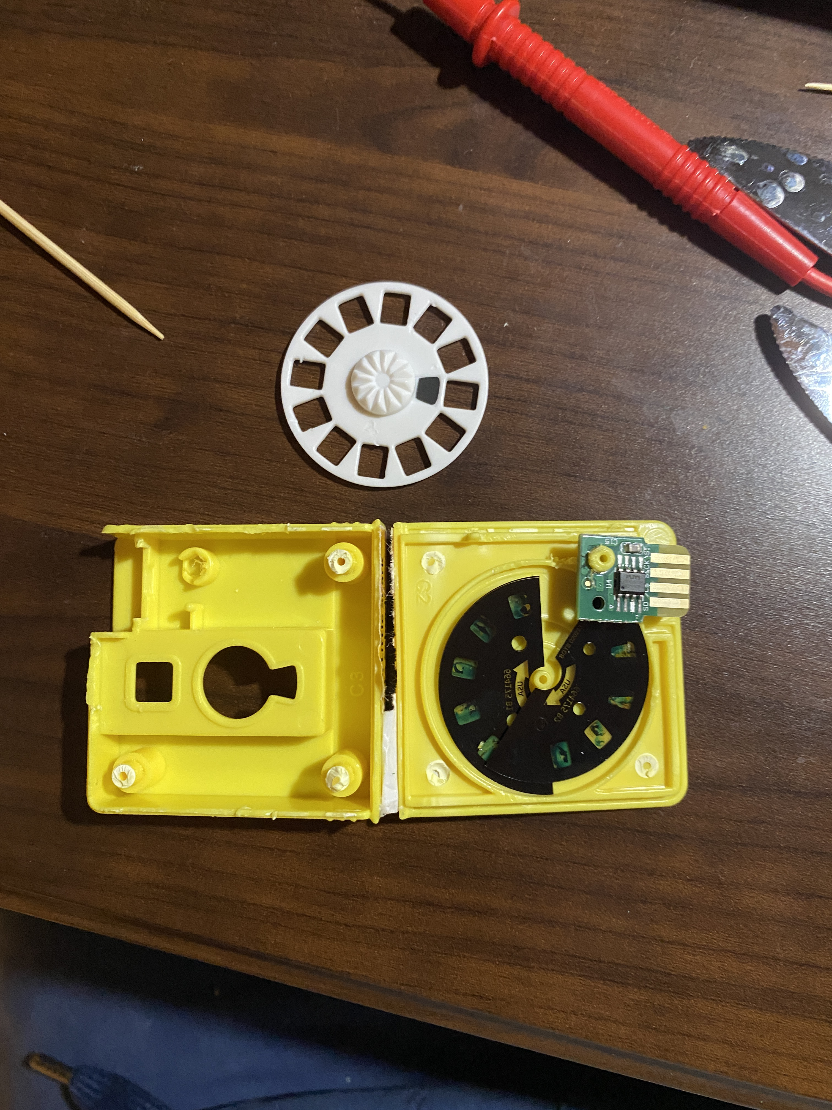
data/devlog/images/CartridgeDissassembly/internal_casing2.JPG
