mtkimmins/LTSDM_hack/data/devlog/images/CartridgeDissassembly/internal_chip_back.JPG

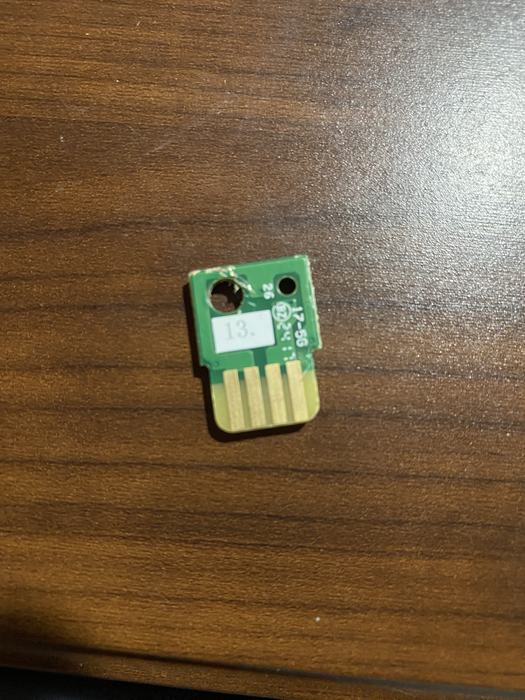
data/devlog/images/CartridgeDissassembly/internal_chip_back.JPG
