mtkimmins/LTSDM_hack/data/devlog/images/CartridgeDissassembly/internal_chip_front.JPG

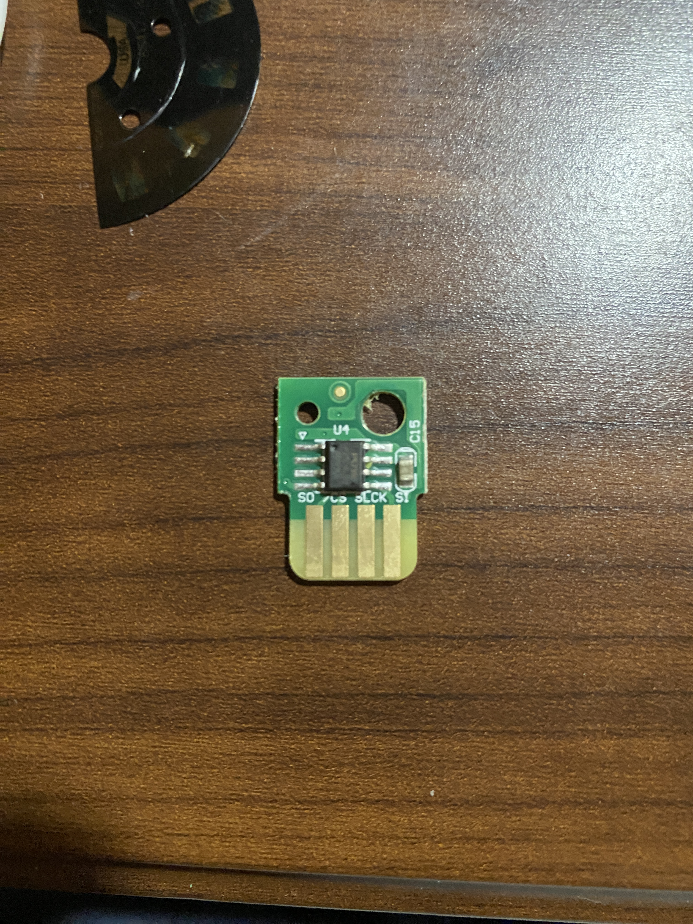
data/devlog/images/CartridgeDissassembly/internal_chip_front.JPG
