mtkimmins/LTSDM_hack/data/devlog/images/CartridgeDissassembly/internal_dissembled.JPG

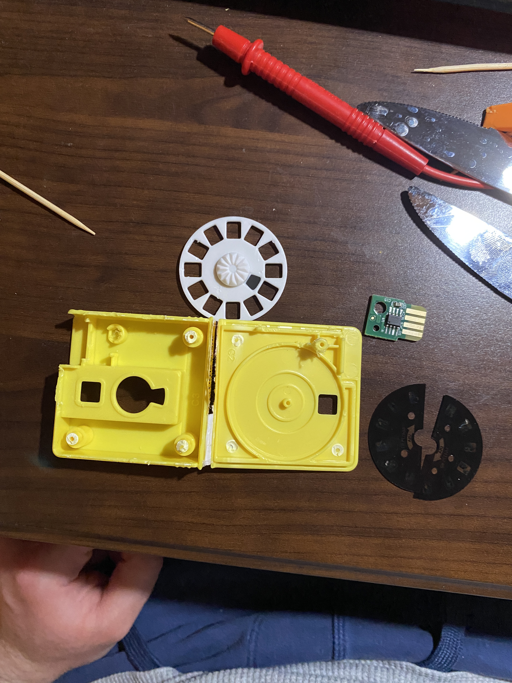
data/devlog/images/CartridgeDissassembly/internal_dissembled.JPG
