mtkimmins/LTSDM_hack/data/devlog/images/CartridgeDissassembly/internal_film_wheel.JPG

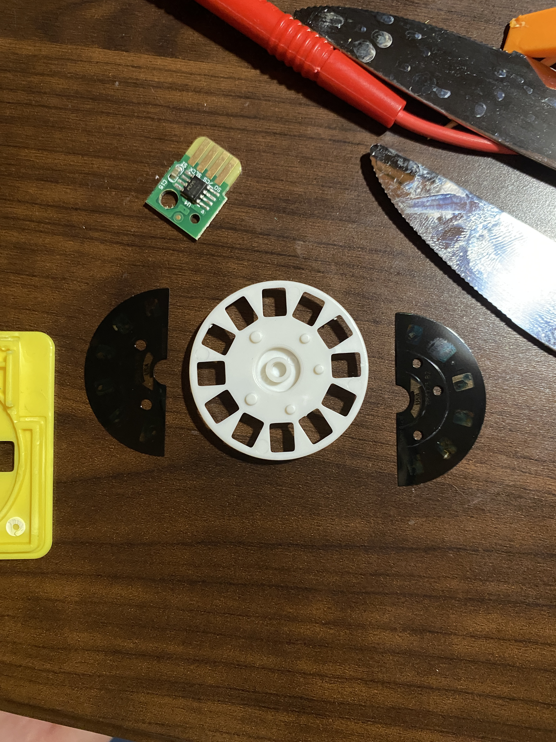
data/devlog/images/CartridgeDissassembly/internal_film_wheel.JPG
