mtkimmins/LTSDM_hack/data/devlog/images/CartridgeDissassembly/internal_flash_chip_back_with_wheel.JPG

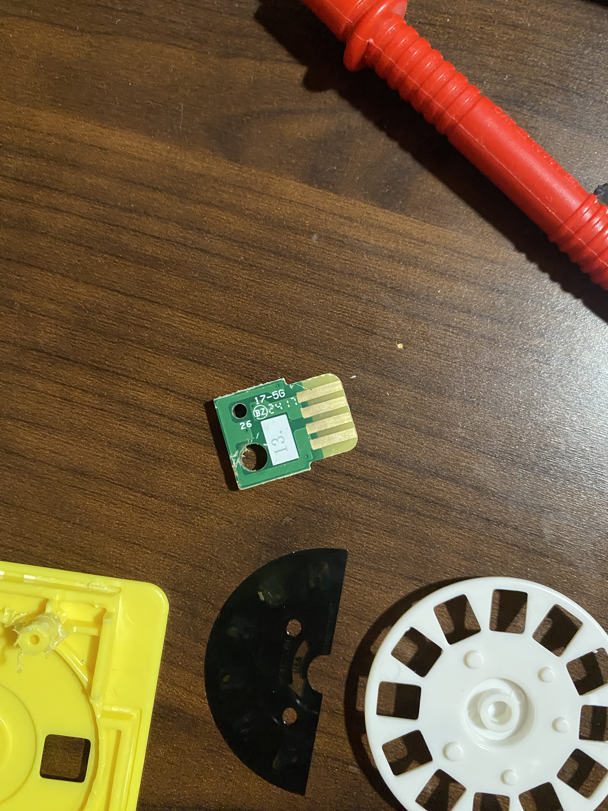
data/devlog/images/CartridgeDissassembly/internal_flash_chip_back_with_wheel.JPG
