mtkimmins/LTSDM_hack/data/devlog/images/Chips/soldered_back.JPG

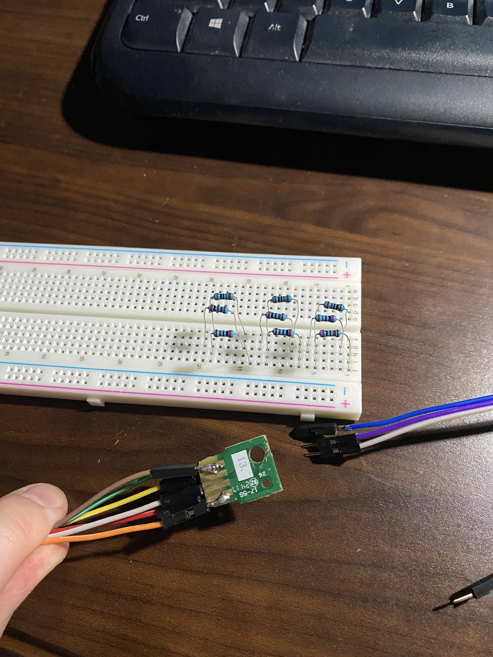
data/devlog/images/Chips/soldered_back.JPG
