mtkimmins/LTSDM_hack/data/devlog/images/Chips/soldered_front.JPG

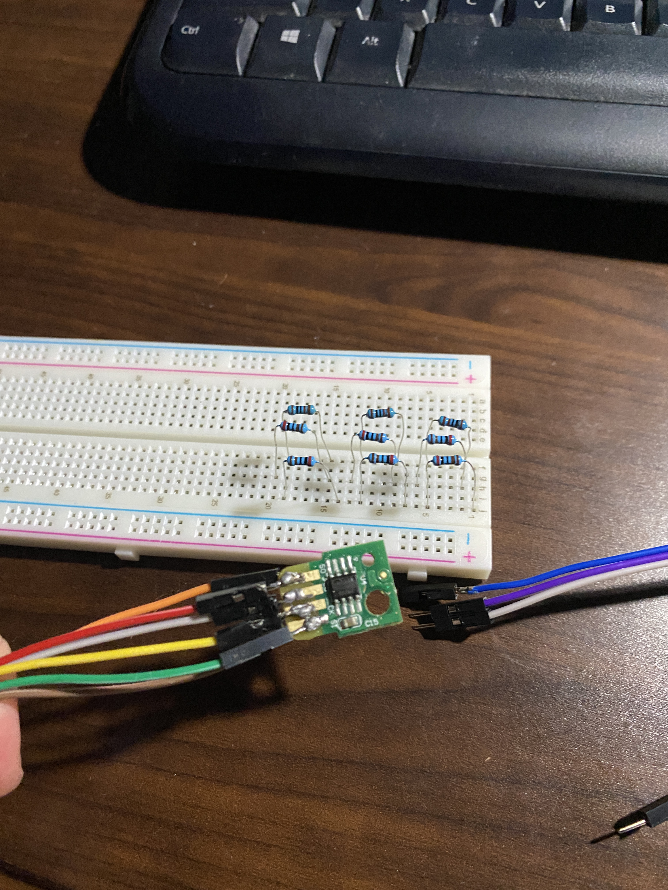
data/devlog/images/Chips/soldered_front.JPG
