mtkimmins/LTSDM_hack/data/devlog/images/Projector_disassembly/audio jack board1.JPG

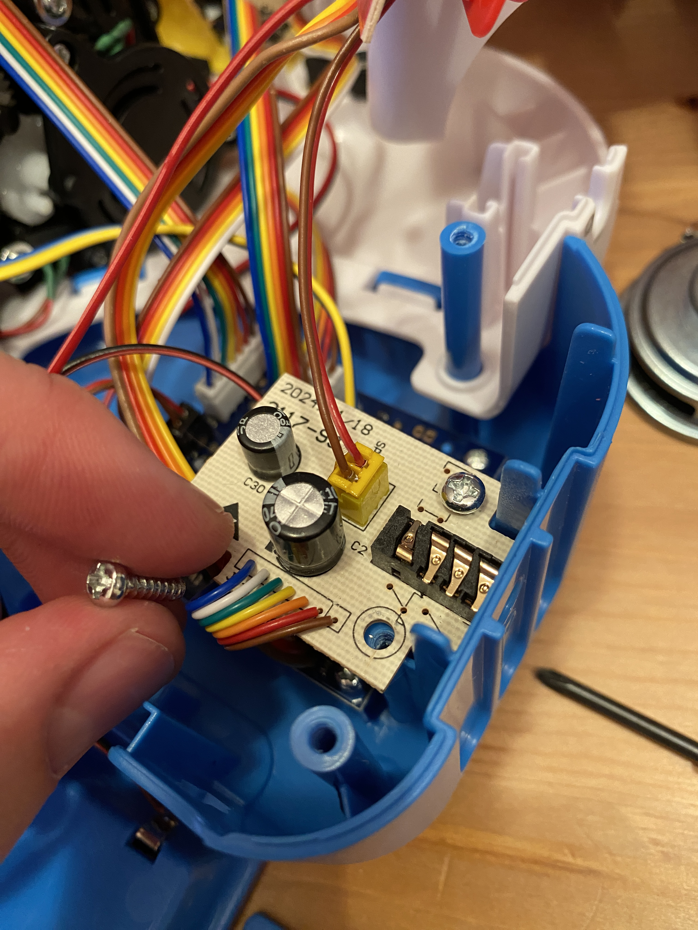
data/devlog/images/Projector_disassembly/audio jack board1.JPG
