mtkimmins/LTSDM_hack/data/devlog/images/Projector_disassembly/audio jack wiring back1.JPG

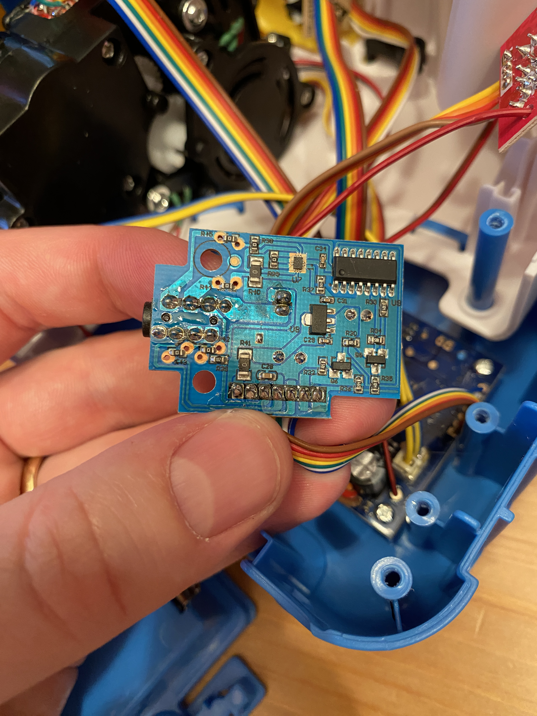
data/devlog/images/Projector_disassembly/audio jack wiring back1.JPG
