mtkimmins/LTSDM_hack/data/devlog/images/Projector_disassembly/audio jack wiring back.JPG

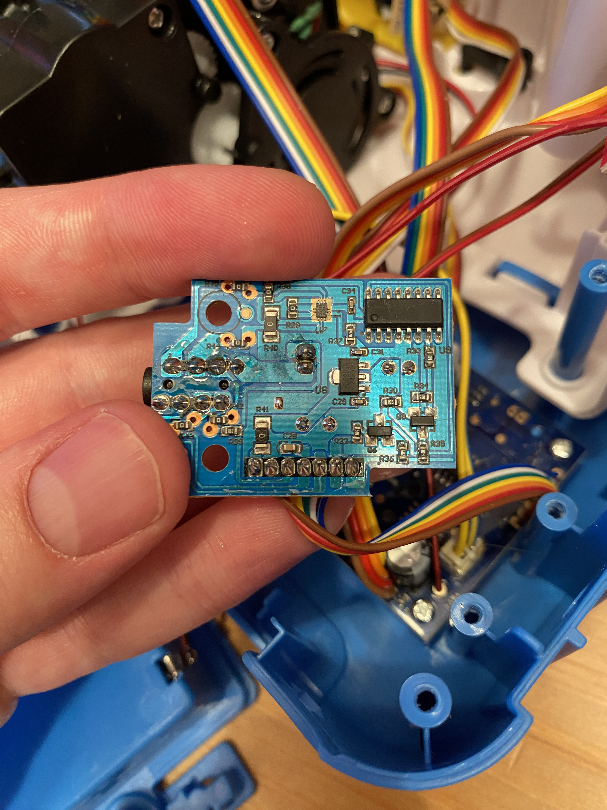
data/devlog/images/Projector_disassembly/audio jack wiring back.JPG
