mtkimmins/LTSDM_hack/data/devlog/images/Projector_disassembly/battery supply wiring.JPG

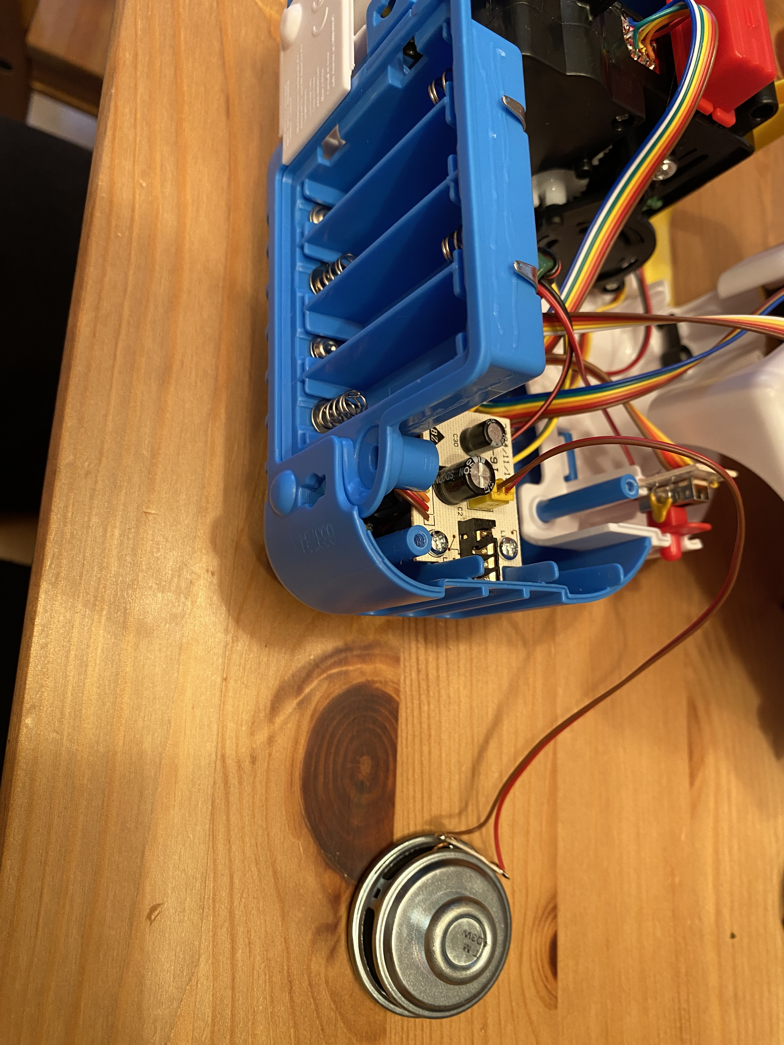
data/devlog/images/Projector_disassembly/battery supply wiring.JPG
