mtkimmins/LTSDM_hack/data/devlog/images/Projector_disassembly/initial inside1.JPG

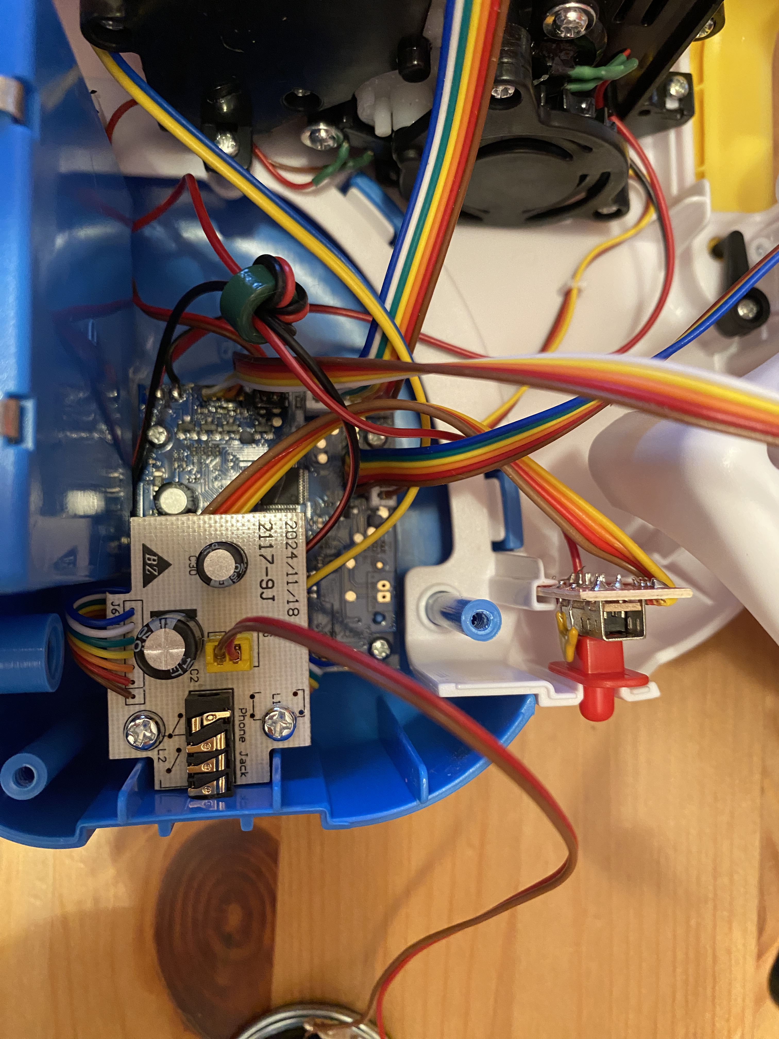
data/devlog/images/Projector_disassembly/initial inside1.JPG
