mtkimmins/LTSDM_hack/data/devlog/images/Projector_disassembly/initial inside.JPG

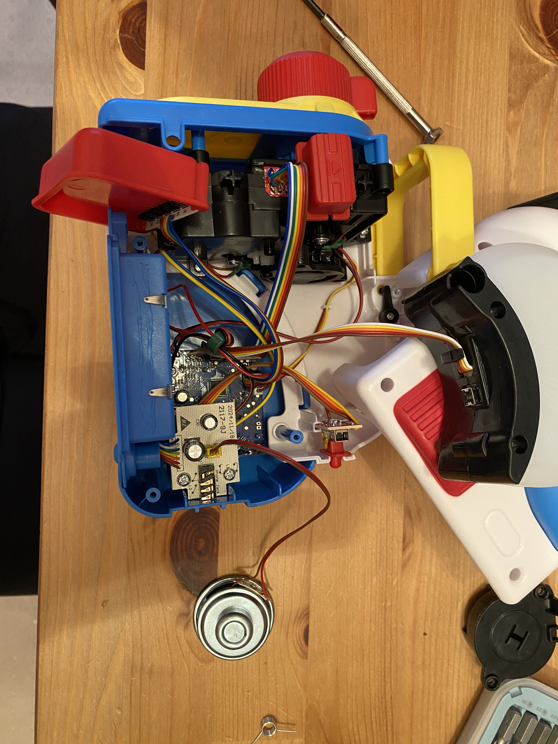
data/devlog/images/Projector_disassembly/initial inside.JPG
