mtkimmins/LTSDM_hack/data/devlog/images/Projector_disassembly/raw_guts.JPG

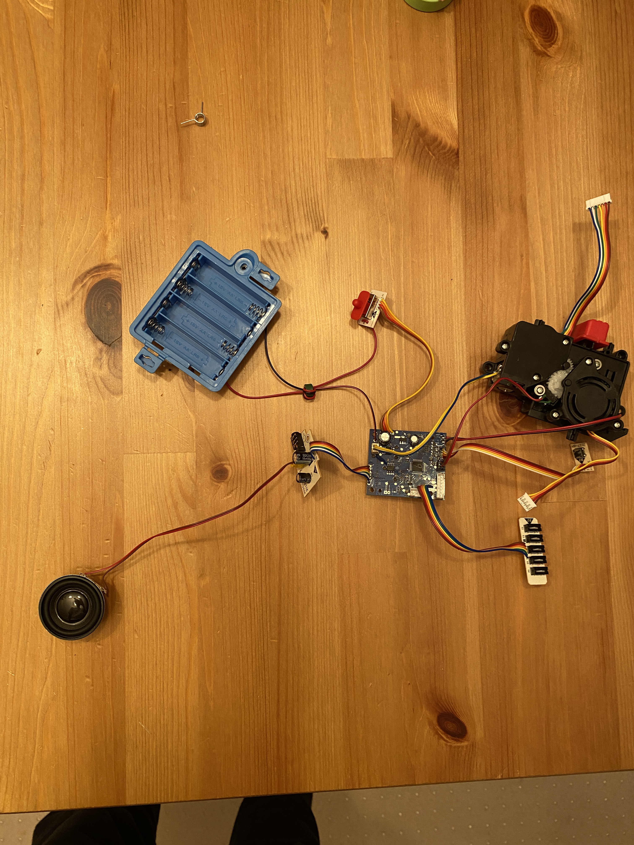
data/devlog/images/Projector_disassembly/raw_guts.JPG
