mtkimmins/LTSDM_hack/data/devlog/images/Projector_disassembly/screw6.JPG

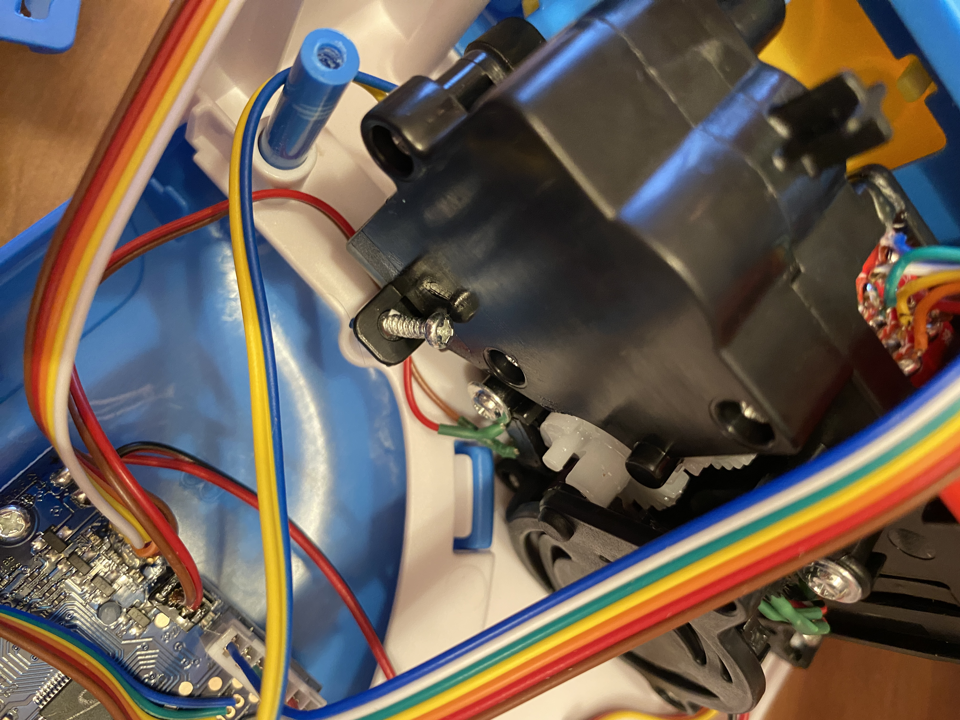
data/devlog/images/Projector_disassembly/screw6.JPG
