mtkimmins/LTSDM_hack/data/devlog/images/Projector_disassembly/total screws for shell.JPG

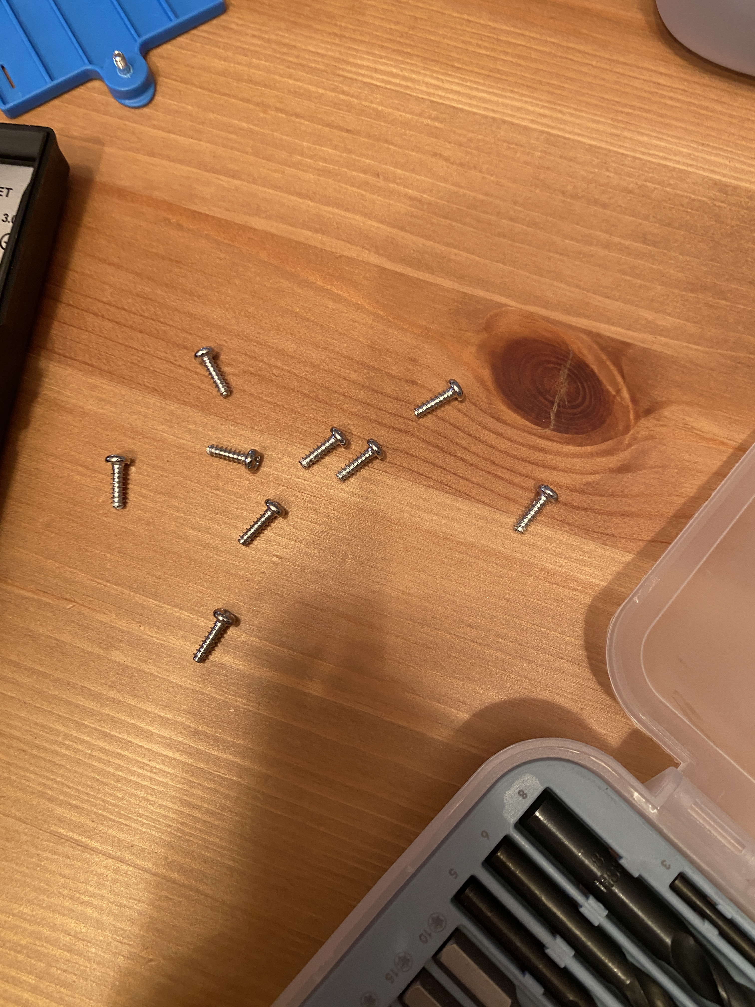
data/devlog/images/Projector_disassembly/total screws for shell.JPG
