mtkimmins/LTSDM_hack/data/devlog/images/Projector_disassembly/unboxing.JPG

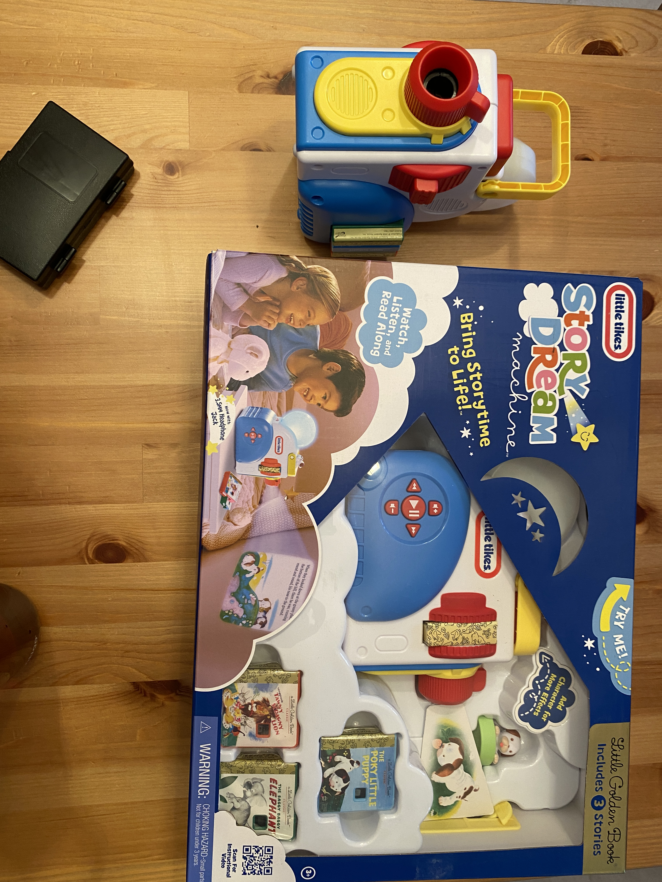
data/devlog/images/Projector_disassembly/unboxing.JPG
