mtkimmins/LTSDM_hack/data/devlog/images/shield/soldered-headers-arduino2.JPG

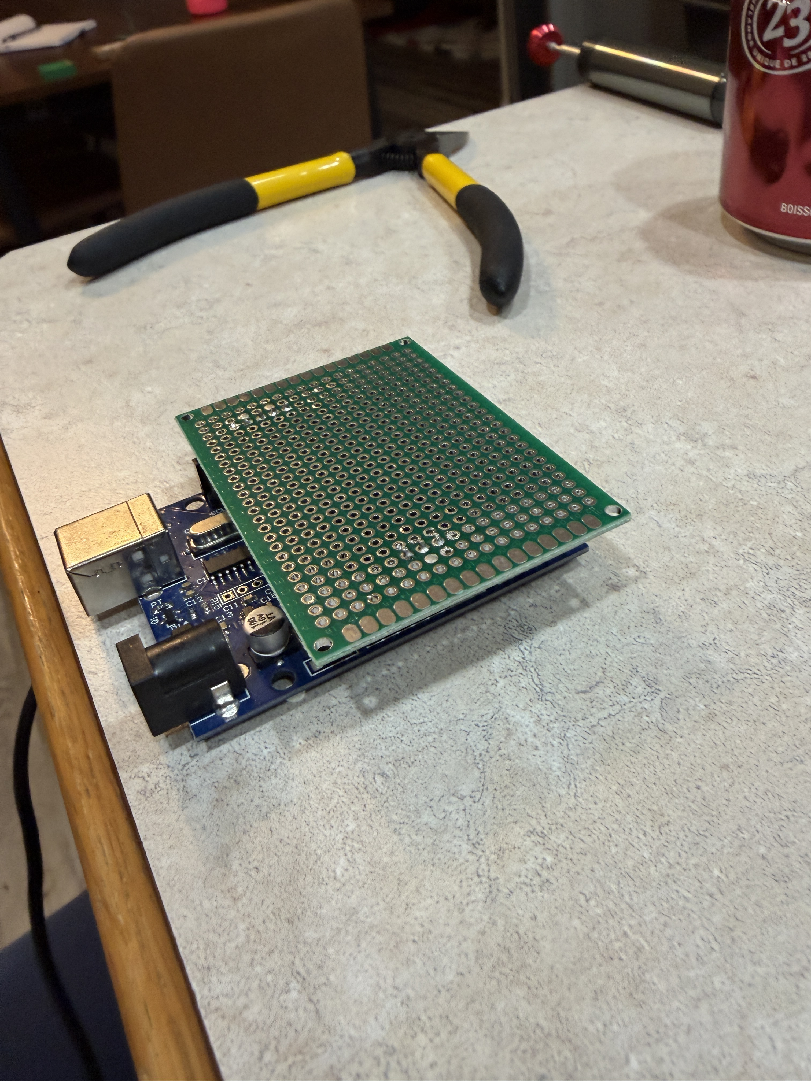
data/devlog/images/shield/soldered-headers-arduino2.JPG
