mtkimmins/LTSDM_hack/data/devlog/images/shield/soldered-socket.JPG

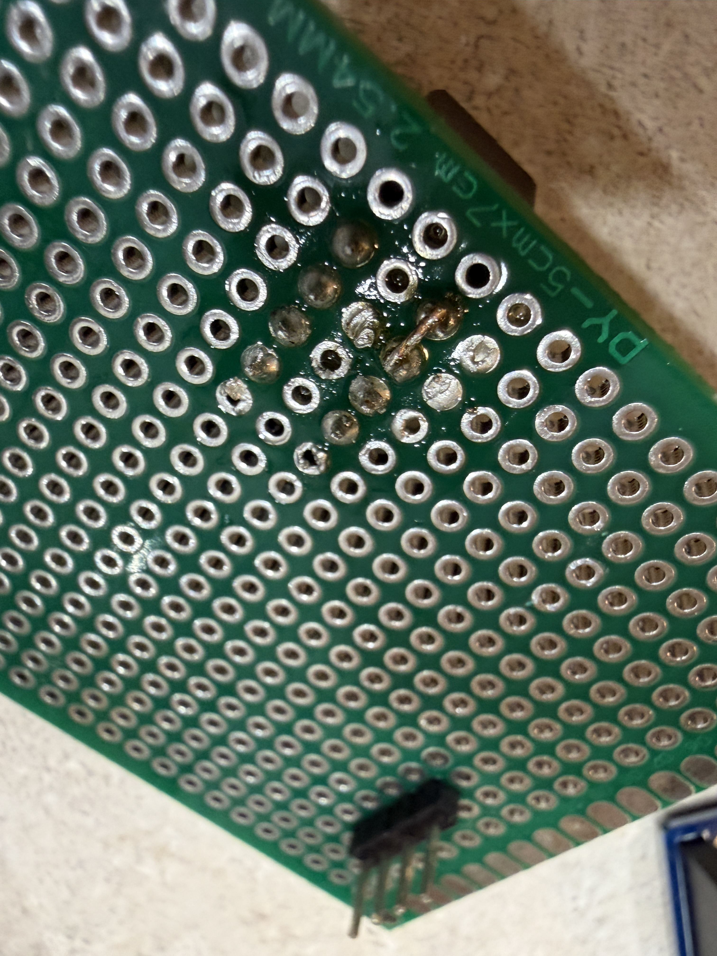
data/devlog/images/shield/soldered-socket.JPG
