mtkimmins/LTSDM_hack/data/devlog/images/shield/soldering/divider-drain-gnd.jpg

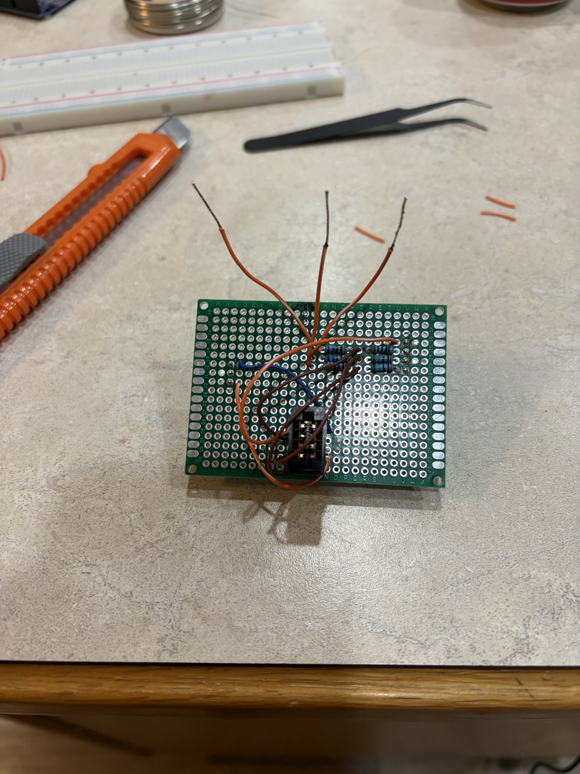
data/devlog/images/shield/soldering/divider-drain-gnd.jpg
