mtkimmins/LTSDM_hack/data/devlog/images/shield/soldering/dry-resistors-placement.jpg

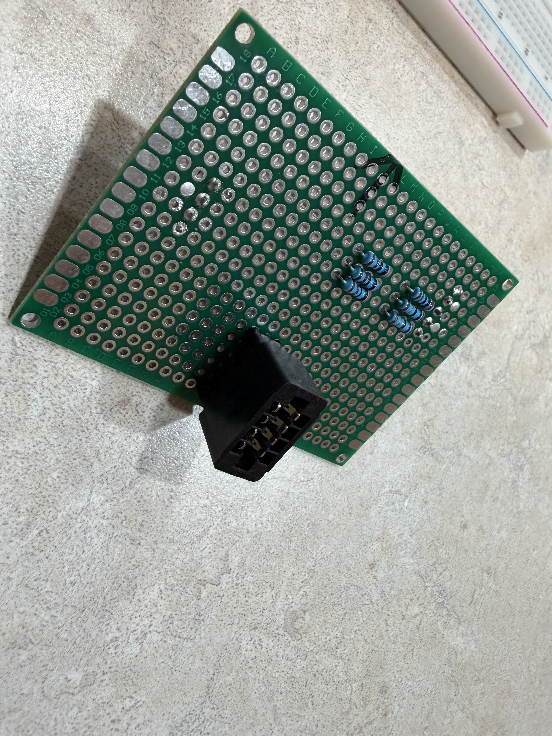
data/devlog/images/shield/soldering/dry-resistors-placement.jpg
