mtkimmins/LTSDM_hack/data/devlog/images/shield/soldering/dry-wire-top2.jpg

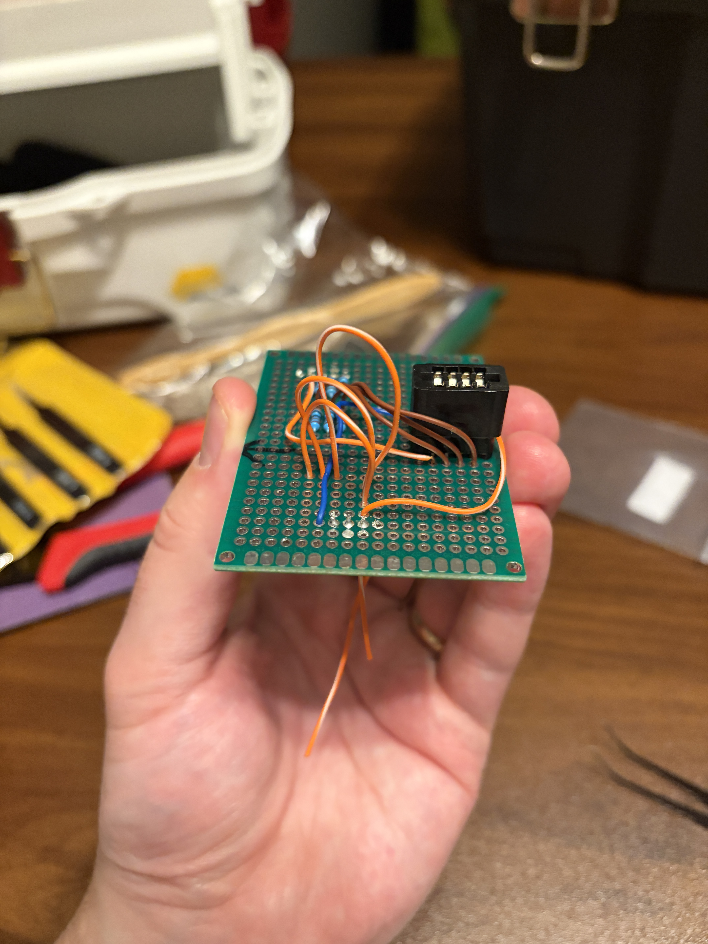
data/devlog/images/shield/soldering/dry-wire-top2.jpg
