mtkimmins/LTSDM_hack/data/devlog/images/shield/soldering/dry-wire-top3.jpg

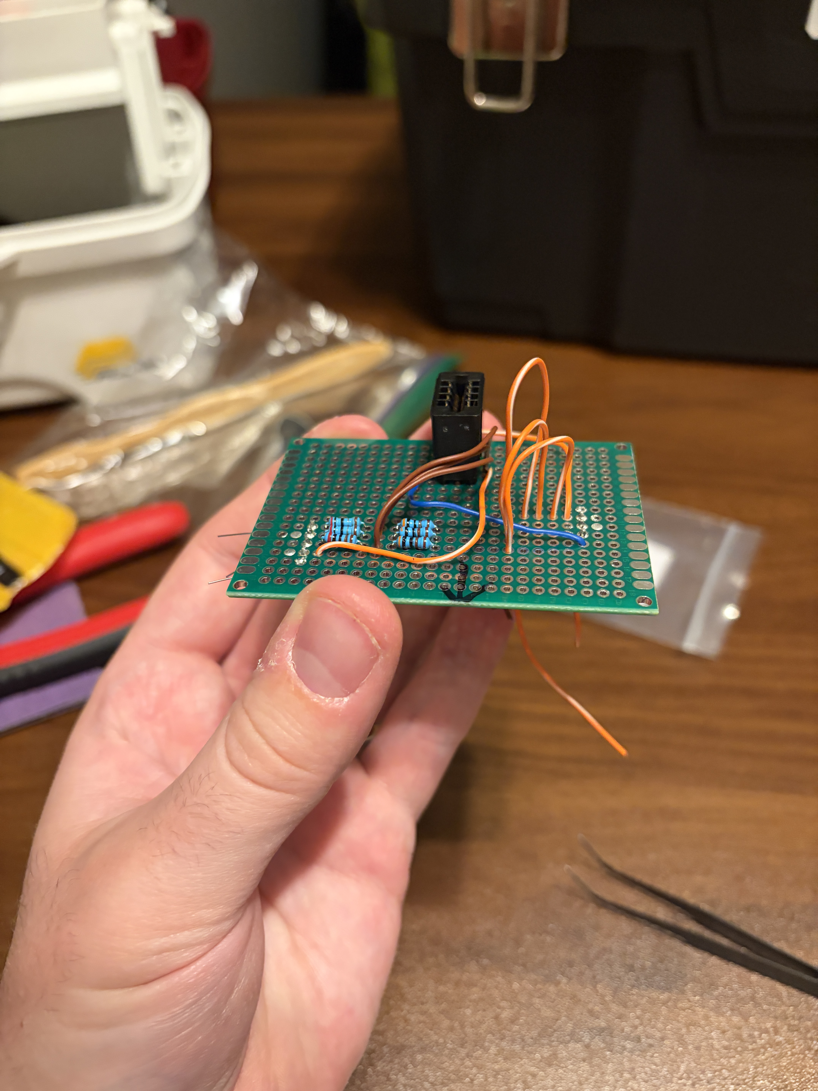
data/devlog/images/shield/soldering/dry-wire-top3.jpg
