mtkimmins/LTSDM_hack/data/devlog/images/shield/soldering/dry-wire-top4.jpg

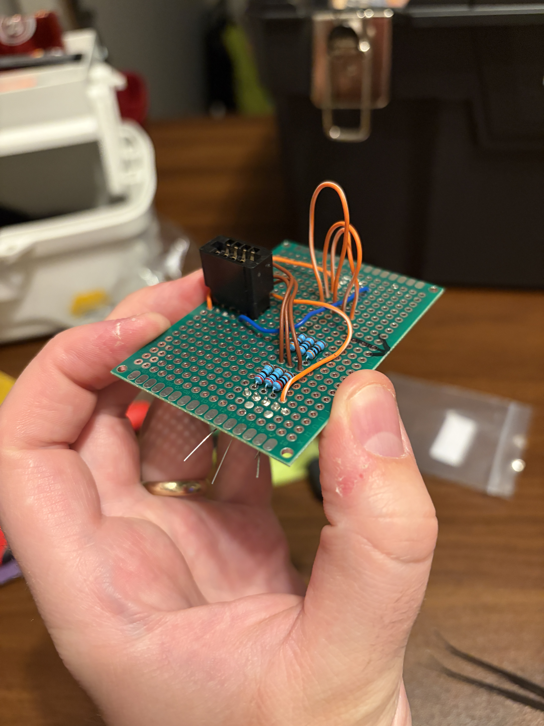
data/devlog/images/shield/soldering/dry-wire-top4.jpg
