mtkimmins/LTSDM_hack/data/devlog/images/shield/soldering/dry-wire-top5.jpg

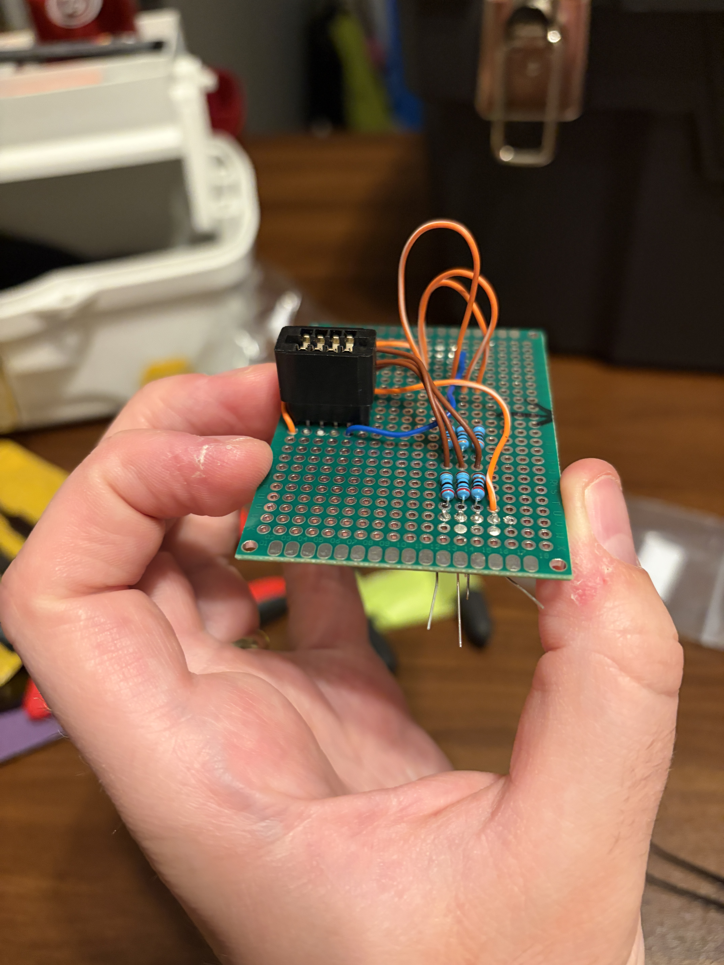
data/devlog/images/shield/soldering/dry-wire-top5.jpg
