mtkimmins/LTSDM_hack/data/devlog/images/shield/soldering/final1.jpg

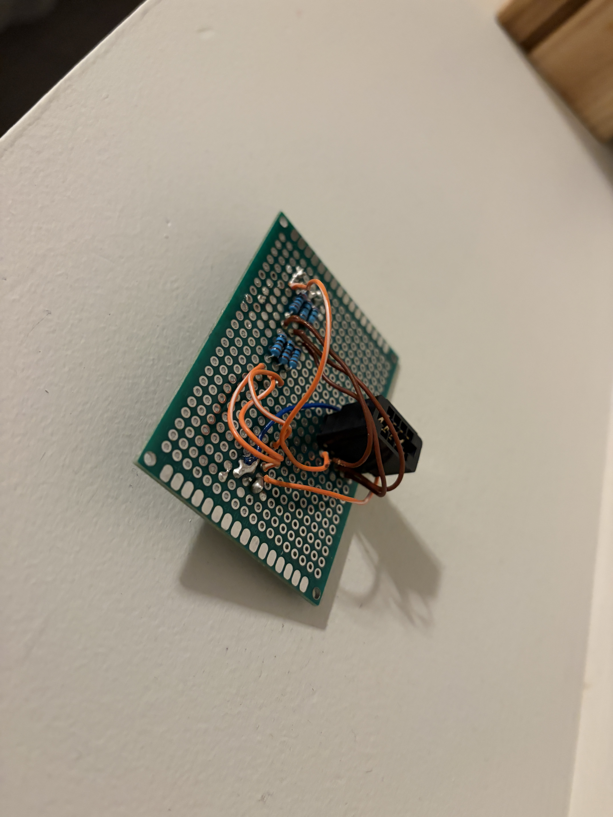
data/devlog/images/shield/soldering/final1.jpg
