mtkimmins/LTSDM_hack/data/devlog/images/shield/soldering/post-trim-bottom.jpg

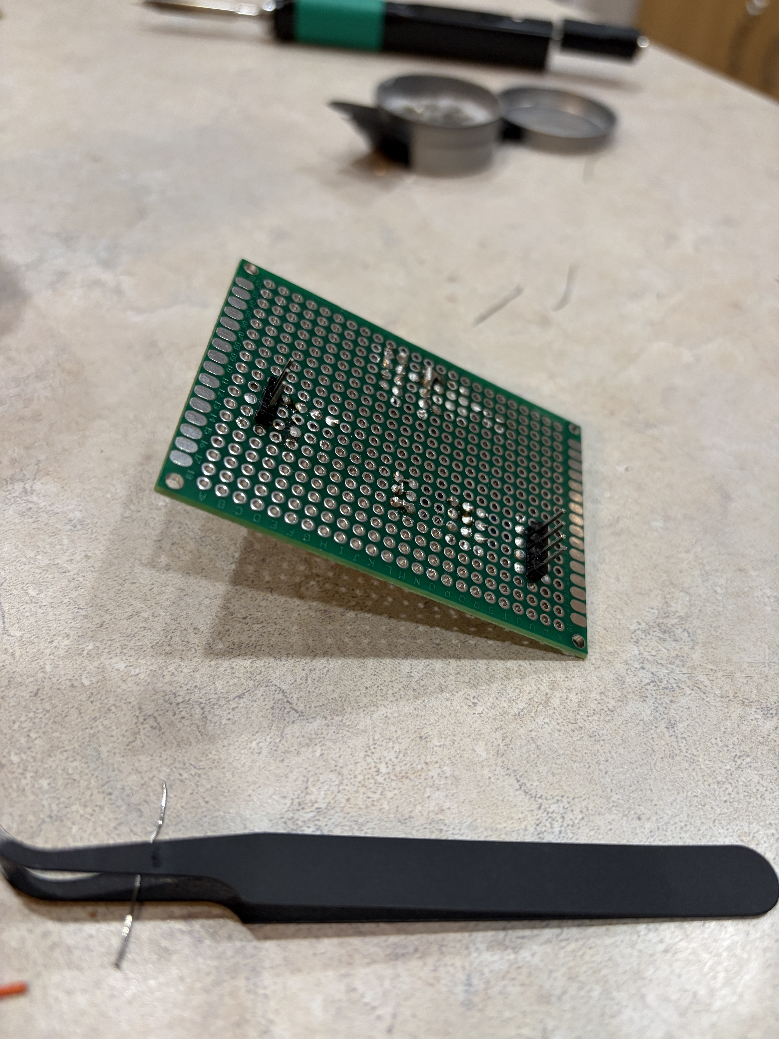
data/devlog/images/shield/soldering/post-trim-bottom.jpg
