mtkimmins/LTSDM_hack/data/devlog/images/shield/soldering/pre-solder-bridge-top2.jpg

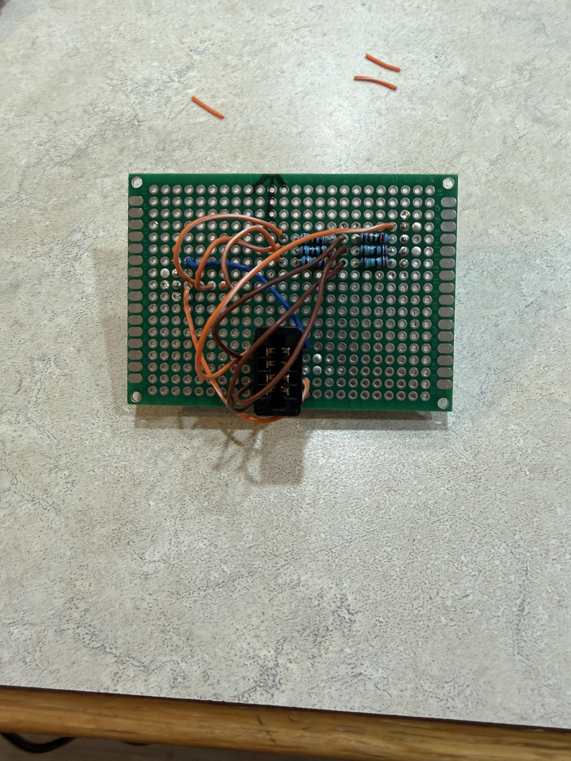
data/devlog/images/shield/soldering/pre-solder-bridge-top2.jpg
