mtkimmins/LTSDM_hack/data/devlog/images/shield/soldering/soldered-resistors.jpg

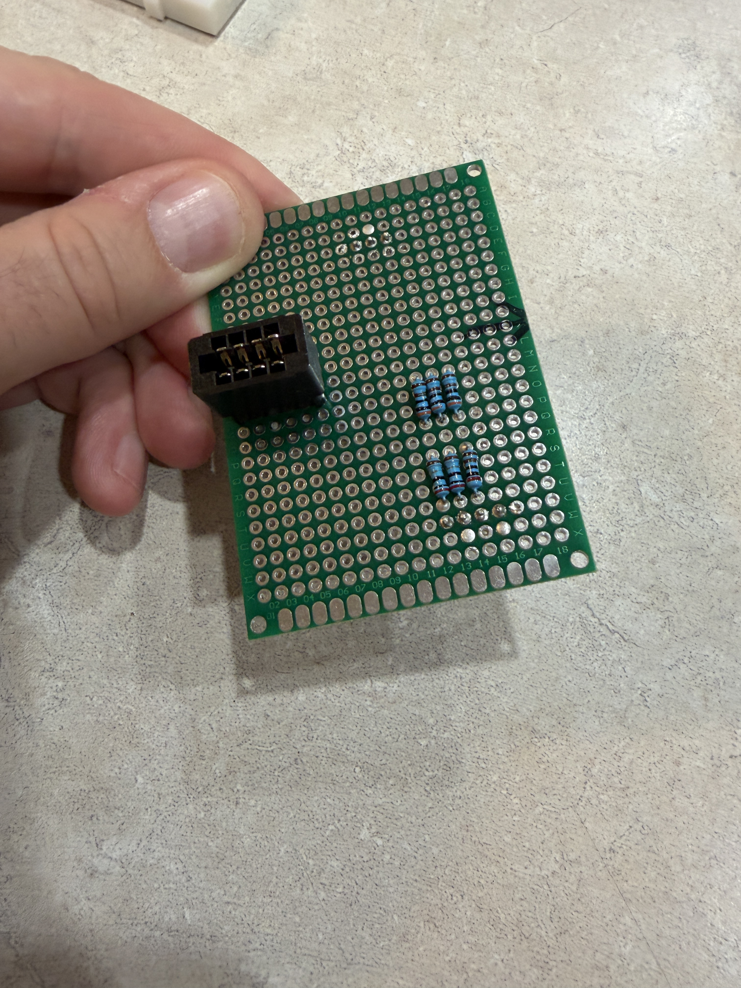
data/devlog/images/shield/soldering/soldered-resistors.jpg
