mtkimmins/LTSDM_hack/data/devlog/images/shield/soldering/vcc-chip.jpg

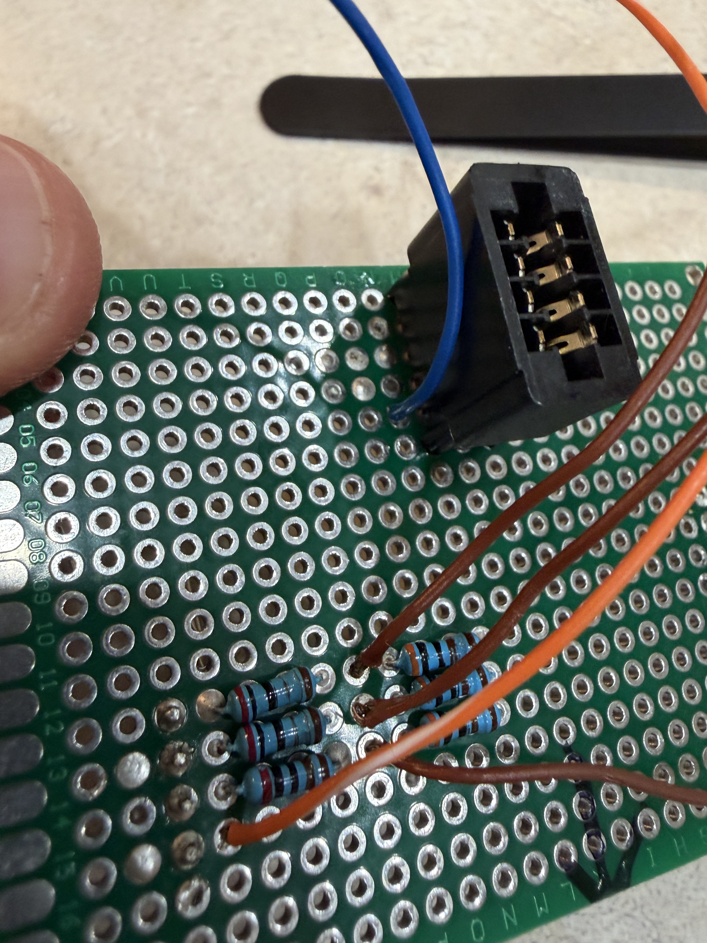
data/devlog/images/shield/soldering/vcc-chip.jpg
