mtkimmins/LTSDM_hack/data/devlog/images/WiringSetup/final_setup1.JPG

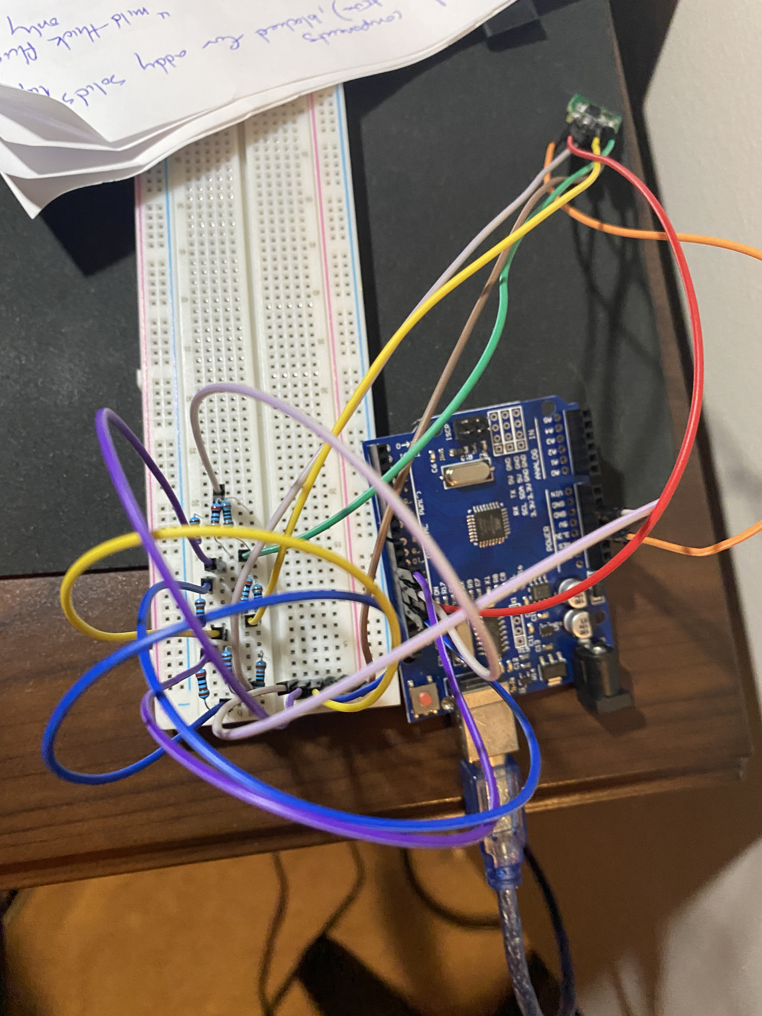
data/devlog/images/WiringSetup/final_setup1.JPG
