mtkimmins/LTSDM_hack/data/devlog/images/WiringSetup/final_setup2.JPG

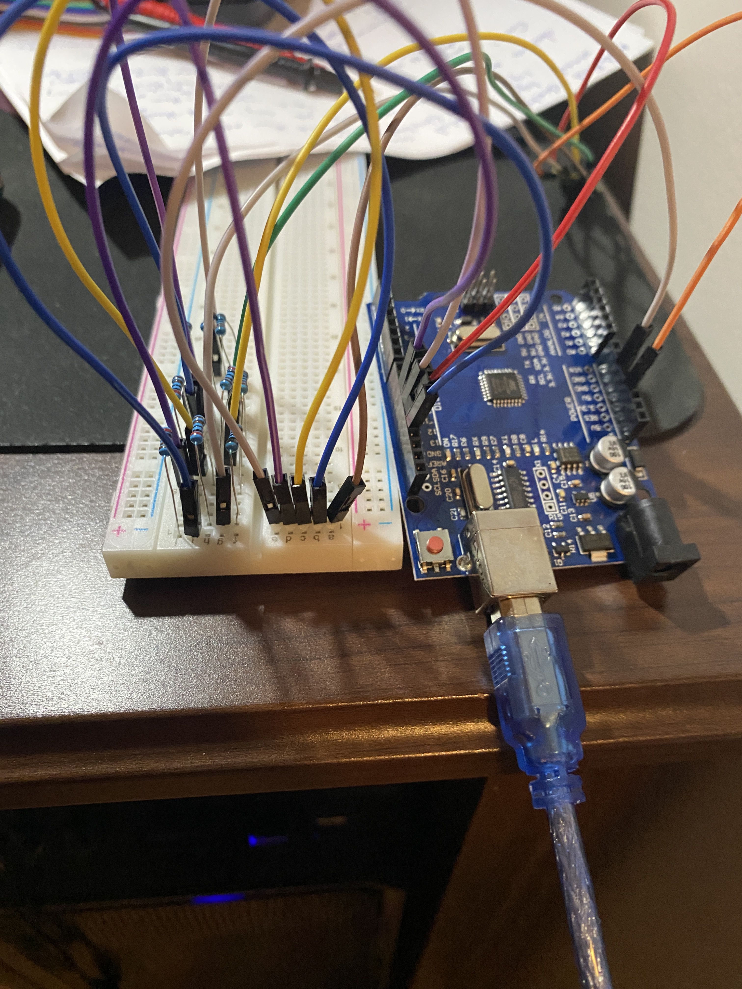
data/devlog/images/WiringSetup/final_setup2.JPG
