mtkimmins/LTSDM_hack/data/devlog/images/WiringSetup/official-guide/boards.JPG

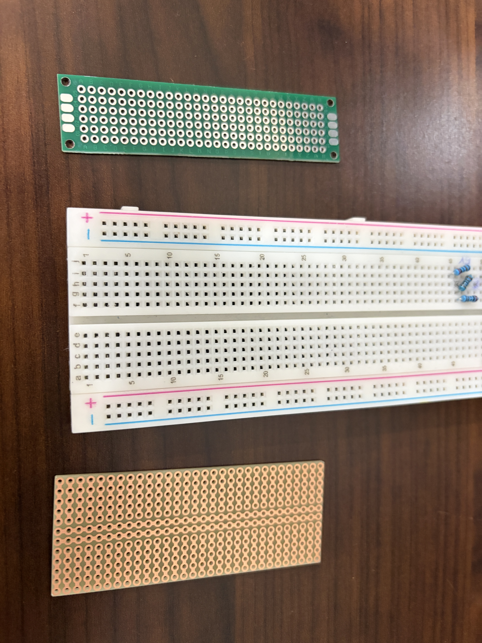
data/devlog/images/WiringSetup/official-guide/boards.JPG
