mtkimmins/LTSDM_hack/data/devlog/images/CaseMeasurements/back-measurements.png

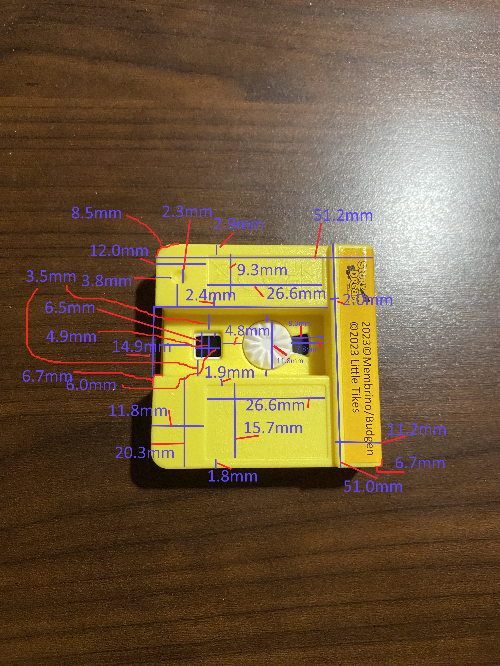
data/devlog/images/CaseMeasurements/back-measurements.png
